VictorZykov/molecubes/README.md

Welcome to the recovered Molecubes software repository!  <br/>This repository was previously hosted on SourceForge.  <br/>Please refer to the molecubes.org wiki for the full project description.
