VictorZykov/molecubes/software/CubeInterface/CubeInterface/README.txt

== Executable ==
   NxTutorial104.exe

== Libraries ==
(PhysX Libraries)
   NxCharacter.dll
   NxCooking.dll
   NxOgre.dll

(OGRE Libraries)
   OgreMain.dll
   OIS.dll
   Plugin_ParticleFX.dll
   RenderSystem_Direct3D9.dll
   RenderSystem_GL.dll

== Configuration Files ==
   config.yaml				(configuration for graphics rendering; edit in Notepad)

== Resources (images, meshes, etc.) ==
   Media\
	- resources.cfg

	- boot.zip			(contains basic media files)
	- tutorialmedia.zip		(contains media files required by tutorials)

	- MSCube19.mesh			(display mesh for bottom half-cube)
	- MSCube20.mesh			(display mesh for upper half-cube)
	- Pyramid13.mesh		(collision mesh for bottom half-cube)
	- Pyramid14.mesh		(collision mesh for upper half-cube)
	- 01 - Default.material		(material information for cubes, e.g. color)
	
	- nxbgui.material		(material information for GUI)

	- bguires.zip			(contains media files for Beta GUI)
	- bgui.exit.active.png		(image for GUI)
	- bgui.exit.png			(image for GUI)
	- debug.active.png		(image for GUI)
	- debug.png			(image for GUI)
	- debugon.active.png		(image for GUI)
	- debugon.png			(image for GUI)
	- pause.active.png		(image for GUI)
	- pause.png			(image for GUI)
	- play.active.png		(image for GUI)
	- play.png			(image for GUI)
