VictorZykov/molecubes/specs/hardware_protocol_definition.xls

Sheet: Revision History
Molecubes Half-Duplex RS232 Bus Command and Protocol Definition Document
Date | Revision | Description | Engineer
2007-09-11 | 1 | Initial revision | Phelps Williams
2007-09-25 | 2 | Coverted to xlsx format, formatting changes | Phelps Williams
2007-10-12 | 3 | Finished populating initial command listing, details of queued commands has also been worked through. Reverted back to xls format. | Phelps Williams
2007-10-15 | 4 | Revisions to instruction listing after certain commands were identified as lacking suffcient feedback. | Phelps Williams
2008-01-11 | 5 | Command 0x08 "set output pins" altered to provide explicit control over data direction. Command 0x03 "set address" marked as only usable over internal bus. Command 0x14 "ADC readout" added. | Victor Zykov
2008-03-17 | 6 | Segregared commands into Master and Slave types with the goal of only having one Master per cube with a priori known functionality (determined with its class). New classes introduced, such as triplet and duet controller AVRs and gripper | Victor Zykov
2008-03-28 | 7 | Device Classes broken out to separate sheet, battery master slave specified. | Phelps Williams

Sheet: Packet Specification
Packet Specification
HEADER | CLASS | ID | LENGTH | INSTRUCTION | PARAM1 | .... | PARAMn | CHECKSUM
Name | Range | Description
HEADER | 0xFF | This is a single byte which identifies an incoming packet
CLASS | 0x00-0xFF | This is a single byte identifying the class of the target device. (See Device Classes sheet)
ID | 0x00-0xFD | Unique class address. There are 254 available Ids for each individual class.
 |  | Class Broadcast Address: 0xFE
LENGTH | 0x00-0xFF | Parameter byte count. Maximum parameter count is 256 parameters per packet. It is important to note that the overall packet is as follows:
 |  | Overall Packet Length = 6 + Length
 |  | The overall packet length takes the header, class, id, length, instruction, and checksum into account.
INSTRUCTION | 0x00-0xFF | Instruction to perform
PARAMETER0...n | 0x00-0xFF | Parameters specific to each instruction
CHECKSUM | 0x00-0xFF | A simple 8bit checksum value. Calculated as follows:
 |  | Checksum = ^(ID + LENGTH + INSTRUCTION + PARAM1 + ... PARAMn)
 |  | Checksum value is 8bits in length and should rollover upon reaching its maxima.
NOTES
To avoid timing errors during packet transmission, the packet source has its interrupts turned off for the period of transmission.

Sheet: Device Classes
Molecubes Device Classes
Class | Master | Description
0xFF | N/A | AX-12 Servomotor class
0xFE | N/A | broadcasting class - for initial module identification and address assignment
0xFD | N/A | ARMClass - for future extensions
0xFC | Yes | Controller AVR shell - with both side panel (triplet)
0xFB | No | Controller AVR shell - with only one left side panel (duet)
0xFA | Yes | Actuator South Class - connected to the motor and Hall sensor
0xF9 | No | Actuator North Class - connected to the motor and main potentiometer
0xF8 | Yes | Gripper class
0xF7 | Yes | Battery Triplet Class (Master, South)
0xF6 | No | Battery Duet Class (Slave, North)
Note: Master Classes can be commanded over the external bus. Non-Master (slave) classes can only be commanded the internal bus.

Sheet: Molecube Instruction Listing
Molecube Module Instruction Listing‡ |  |  |  |  |  |  |  |  | COMMAND RECEPIENTS:
 |  |  |  |  |  |  |  |  | MASTERS (external bus)
Name | Instruction | Parameter Definition |  |  |  |  |  | Notes | SLAVES (internal bus)
Get Firmware Version | 0x02 | Instruction Parameters: | 0 | Bytes | Response Parameters: | 2 | Bytes |  | SOUTH HALVES (ext. bus)
 |  | None |  |  | Firmware Version | 16 | bits
Set Address | 0x03 | Instruction Parameters: | 1 | Bytes | Response Parameters: | 1 | Bytes | master uses this command to propagate
 | p[0] | Address | 8 | bits | Address | 8 | bits | address to slave half via internal bus
 |  |  |  |  |  |  |  | Used only over internal bus
Set Address with | 0x04 | Instruction Parameters: | 1 | Bytes | Response Parameters: | 1 | Bytes | Broadcast command, device which orientation pin high sets provided address and responds indicating address successfully set.
Orientation Pin† | p[0] | Address | 8 | bits | Address (as part of rx process) | 8 | bits
 |  |  |  |  | Error codes
 |  |  |  |  | No parameters - no errors
 |  |  |  |  | p[0] = 1 - Slave comm timeout
 |  |  |  |  | p[0] = 2 - Slave comm error
Get Raw Angle | 0x06 | Instruction Parameters: | 0 | Bytes | Response Parameters: | 4.875 | Bytes
 |  | None |  |  | filler | 6
 |  |  |  |  | Main Pot Reading | 10 | bits
 |  |  |  |  | filler | 6
 |  |  |  |  | Motor Position | 10 | bits
 |  |  |  |  | filler | 7 | bit
 |  |  |  |  | Hall Sensor | 1 | bit
Get Measured Angle | 0x07 | Instruction Parameters: | 0 | Bytes | Response Parameters: | 2 | Bytes | Returns measured angle derived from information also accessible in Get Raw Angle command.
 |  | None |  |  | Calculated angle in .1 degs | 12 | bits
 |  |  |  |  | filler | 4
Set Orientation Pins | 0x08 | Instruction Parameters: | 1 | Bytes | Response Parameters: | 0 | Bytes | CARE SHOULD BE TAKEN TO AVOID
 | p[0] | Board ID - bits 4..7 | 4 | bits | Error codes |  |  | OUTPUT-TO-OUTPUT SHORTS
 |  | Pin ID - bits 2 and 3 | 2 | bits | No parameters - no errors |  |  | ALL PINS ARE INPUTS
 |  | filler bit 1 | 1 | bits | p[0] = 1 - Pin is an output already |  |  | unless set to Output = High
 |  | Desired state bit 0 | 1 | bits | p[0] = 2 - High input level detected |  |  | Sets both data direction and value (for
 |  |  |  | bits | p[0] = 3 - Requested board abscent |  |  | outputs) of individual orientation pins
 |  |  |  |  | p[0] = 4 - Slave commication timeout |  |  | Checks input first to avoid short circuit
 |  |  |  |  | p[0] = 5 - Slave commication error
 | p[0] | Slave Side ID - bits 4..5 | 2 | bits | Error codes
 |  | Pin ID - bits 2 and 3 | 2 | bits | No parameters - no errors
 |  | filler bit 1 | 1 | bits | p[0] = 1 - Pin is an output already
 |  | Desired state bit 0 | 1 | bits | p[0] = 2 - High input level detected
 |  |  |  |  | p[0] = 3 - Requested board not installed
 |  |  |  |  | p[0] = 4 - Wrong side requested
Get Orientation Pins | 0x09 | Instruction Parameters: | 0 | Bytes | Response Parameters: | 4 | Bytes
 | None |  |  |  | p[0] = M3..0, R3..0 (master) | 8 | bits | Sets all orientation I/O s to inputs and
 |  |  |  |  | p[1] = L3..0(m), M3..0 (slave) | 8 | bits | reads their states, then reports them
 |  |  |  |  | p[2] = R3..0, L3..0 (slave) | 8 | bits | in 2 parameter bytes of response
 |  |  |  |  | p[3] = 1 - Slave comm timeout | 8 | bits
` |  |  |  |  | p[3] = 2 - Slave comm error
 | None |  |  |  | p[0] = 4 bit filler, M3..0 (slave) | 8
 |  |  |  |  | p[1] = R3..0, L3..0 (slave) | 8
Get Motor Status | 0x0B | Instruction Parameters: | 0 | Bytes | Response Parameters: | 10 | Bytes
 |  | None |  |  | Goal Position | 16 | bits
 |  |  |  |  | Present Position | 16 | bits
 |  |  |  |  | Present Speed | 16 | bits
 |  |  |  |  | Present Load | 16 | bits
 |  |  |  |  | Present Voltage | 8 | bits
 |  |  |  |  | Present Temperature | 8 | bits
Get Motor Register | 0x0C | Instruction Parameters: | 2 | Bytes | Response Parameters: | * | Bytes
 |  | Starting Address | 8 | bits | Parameter 1 | 8 | bits
 |  | Number of registers to read | 8 | bits | Parameter 2 | 8 | bits
 |  |  |  |  | Parameter n | 8 | bits
Set Motor Register | 0x0D | Instruction Parameters: | * | Bytes | Response Parameters: | 0 | Bytes
 |  | Starting Address | 8 | bits | None
 |  | Parameter 1 | 8 | bits
 |  | Parameter 2 | 8 | bits
 |  | Parameter n | 8 | bits
Servo Angle Tracking | 0x0E | Instruction Parameters: | 1 | Bytes | Response Parameters: | 0 | Bytes | This command turns on and off the
 |  | filler | 7 | bits |  |  |  | servo angle tracking loop
 |  | Tracking Status (ON / OFF) | 1 | bits
Preload Motor Profile | 0x0F | Instruction Parameters: | * | Bytes | Response Parameters: | 0 | Bytes | This allows for command preloading on the servo. Specifically utilizing the REG_WRITE (4-3-1) functionality. An ACTION (4-3-2) command is additionally preloaded and executed when a heartbeat of corresponding timestamp is received.
 |  | Timestamp(msec) | 32 | bits | None
 |  | Starting Address | 8 | bits
 |  | Parameter 1 | 8 | bits
 |  | Parameter 2 | 8 | bits
 |  | Parameter n | 8 | bits
Preload Command | 0x10 | Instruction Parameters: | * | Bytes | Response Parameters: | 0 | Bytes | This is for preloading a command outside of the motor, such as a command listed here. Valid commands cannot have response parameters. An example usage of this command is Set LEDs.
 |  | Timestamp(msec) | 32 | bits
 |  | Instruction | 8 | bits | None
 |  | Parameter 1 | 8 | bits
 |  | Parameter 2 | 8 | bits
 |  | Parameter n | 8 | bits
Heartbeat † | 0x11 | Instruction Parameters: | 4 | Bytes | Response Parameters: | 0 | Bytes | Any preloaded command with matching timestamp is executed simultaneously.
 |  | Timestamp | 32 | bits | None
Set LEDs | 0x12 | Instruction Parameters: | 4 | Bytes | Response Parameters: | 0 | Bytes
 |  | Filler (must be 0) | 5 | bits | Error codes
 | p[0] | BoardID (0 - 5) | 3 | bits | No parameters - no errors
 | p[1] | Red | 8 | bits | p[0] = 1 - Right slave board not installed
 | p[2] | Green | 8 | bits | p[0] = 2 - Left slave board not installed
 | p[3] | Blue | 8 | bits | p[0] = 3 - Slave commication timeout
 |  |  |  |  | p[0] = 4 - Slave commication error
 | p[0] | Side (M = 00, R = 01, L = 10) | 2 | bits | No parameters - no errors
 | p[1] | Red | 8 | bits | p[0] = 1 - Right slave board not installed
 | p[2] | Green | 8 | bits | p[0] = 2 - Left slave board not installed
 | p[3] | Blue | 8 | bits
Get ADC Readout | 0x14 | Instruction Parameters: | 0 | Bytes | Response Parameters: | 2 | Bytes | Command designed for use in actuator
 |  | None |  | p[0] | ADCdata & 0x00ff (LSB) | 10 | bits | angle calculation for transmission over
 |  |  |  | p[1] | (ADCdata & 0xff00)>>8 (MSB) | 6 |  | internal bus, however will also respond
 |  |  |  |  |  |  |  | If received on external bus. North half
 |  |  |  |  |  |  |  | returns Hall effect sensor readout,
 |  |  |  |  |  |  |  | South half returns potentiometer readout,
 |  |  |  |  |  |  |  | Data has no meaning for other classes
Set goal speed and angle | 0x15 | Instruction Parameters: | 4 | Bytes | Response Parameters: | 0 | Bytes
 | p[0] | GoalAngle & 0x00ff (LSB) | 8 |  | confirms execution
 | p[1] | (GlAngl & 0xff00)>>8 (MSB) | 8 |  | by returning own class,
 | p[2] | GoalSpeed & 0x00ff (LSB) | 8 |  | address and command ID
 | p[3] | (GSpeed & 0xff00)>>8 (MSB) | 8
 |  | Goal Angle (0..3600)
 |  | Goal Speed (0..3600)
Request inputs state | 0x16 | Instruction Parameters: | 0 | Bytes | Response Parameters: | 0 | Bytes
Gripper actuation | 0x17 | Instruction Parameters: | 6 | Bytes | Response Parameters: | 0 | Bytes
 | p[0] | Position & 0x00ff (LSB) | 8 |  | confirms execution
 | p[1] | (Pos & 0xff00)>>8 (MSB) | 8 |  | by returning own class,
 | p[2] | Speed & 0x00ff (LSB) | 8 |  | address and command ID
 | p[3] | (Speed & 0xff00)>>8 (MSB) | 8
 | p[4] | Force & 0x00ff (LSB) | 8
 | p[5] | (Force & 0xff00)>>8 (MSB) | 8
 |  | Pos 0..1023
 |  | Speed 0..1023
 |  | Force 200..(400)..500
Get Status | 0xFE | Instruction Parameters: | 0 | Bytes | Response Parameters: | 1 | Bytes | Error codes have not been defined, only occurs in response packet, this instruction will replace the intended response instruction.
 |  | None |  |  | Error Code | 8 | bits
Notes:
† Valid for broadcast
‡ Assumes default address upon startup of molecube module
