VictorZykov/molecubes/specs/molecubes_morphology_file_spec.xls

Sheet: Revision History
Molecube Morphology File (*.mmf) Specification
Date | Revision | Description | Engineer
2008-03-28 | 1 | Initial official revision, file structure implemented and functioning to this spec. | Phelps Williams

Sheet: MorphologyConvention
Overall Molecube Morphology File Structure
Item | Range | Contents
cubecount | 0 - 255 | Number of cubes in the morphology, this corresponds ot the number of module descriptors
cubes[] |  | Array of module descriptors
morphology checksum | 0 - 255
statecount | 0 - 2^32 | Number of state descriptors in the state array
state[] |  | Array of state descriptors
state checksum | 0 - 255
List of Modules is an array listing all Module Descriptors - by the number of Molecube modules comprising the assembly
Module Descriptor is a simple feature list that includes the following items
Item | Range | Contents
ID | 0 - 253 | individual Molecube module identifier, address 0xFE is reserved for broadcasting
Class | 0 - 255 | Molecube class identifier, such as AX-12 servo, South actuator half, North actuator half, etc.
NumLinks | 0 - 255 | Number of physical connections this module has in Molecube assembly
Links[ ] |  | Array of Link Descriptors - structures with physical connection specifications - size of array specified by NumLinks
List Array stores all physical connections existing between modules in the Molecube assembly
Link Descriptor is a simple feature list including two sets of items, describing both joint Molecube connectors and their relative orientation
Item | Range | Contents
selfID | 0 - 253 | individual Molecube module identifier of the first joint module
selfClass | 0 - 255 | Molecube class identifier of the first joint module
selfSide | 0 - n | The joint interface identifier for the first joint module (see Module Connector Identification Conventions below)
selfOrient | 0 - 3 | Orientation of the first module relative to the second (see Orientation Convention below)
neighborID | 0 - 253 | individual Molecube module identifier of the second joint module
neighborClass | 0 - 255 | Molecube class identifier of the second joint module
neighborSide | 0 - n | The joint side identifier for the second joint module
 | Orientation Convention
 | There are four possible relative orientations of the Molecube interfaces relative to each other when joint together
 | Each of these four orientations can be characterized by one of four pin interconnection variants below
 | Orientation 0 |  | Orientation 1 |  |  | Orientation 2 |  | Orientation 3
 | Face A | Face B | Face A | Face B |  | Face A | Face B | Face A | Face B
 | Pin 0 <-> | Pin 3 | Pin 0 <-> | Pin 2 |  | Pin 0 <-> | Pin 1 | Pin 0 <-> | Pin 0
 | Pin 1 <-> | Pin 2 | Pin 1 <-> | Pin 1 |  | Pin 1 <-> | Pin 0 | Pin 1 <-> | Pin 3
 | Pin 2 <-> | Pin 1 | Pin 2 <-> | Pin 0 |  | Pin 2 <-> | Pin 3 | Pin 2 <-> | Pin 2
 | Pin 3 <-> | Pin 0 | Pin 3 <-> | Pin 3 |  | Pin 3 <-> | Pin 2 | Pin 3 <-> | Pin 1
 | Module Connector Identification Conventions
 | Face ID | Actuator | Gripper |  | Controller |  | Battery
 | 0 | South Main | Main |  | Triplet Main |  | Triplet Main | Masters
 | 1 | South Right | Right |  | Triplet Right |  | Triplet Right
 | 2 | South Left | Left |  | Triplet Left |  | Triplet Left
 | 3 | North Main |  |  | Duet Main |  | Duet Main | Slaves
 | 4 | North Right |  |  |  |  | Duet Right
 | 5 | North Left |  |  | Duet Left
State Descriptor - a state descriptor maintains some representation of physical or logical state at a point in time
Item | Range | Contents
id | 0 - 255 | Molecube address
class | 0 - 255 | Molecube class
timestamp | 0 - 2^32 | Time of state validity
channel | 0 - 255 | Telemetry Channel represented
value | 0 - 2^32 | Telemetry Channel value
Telemetry Channel Definitions - reference to cube specific channels of telemetry
Class | Channel | Description
0xFA |  | South Actuator Half
 | 0x00 | Actuator position in 10ths of degrees
0xF8 |  | Gripper
 | 0x00 | Gripper position
