VictorZykov/molecubes/software/CubeInterface/hardware_protocol_definition.xls

Sheet: Revision History
Molecubes Half-Duplex RS232 Bus Command and Protocol Definition Document
Date | Revision | Description | Engineer
2007-09-11 | 1 | Initial revision | Phelps Williams
2007-09-25 | 2 | Coverted to xlsx format, formatting changes | Phelps Williams
2007-10-12 | 3 | Finished populating initial command listing, details of queued commands has also been worked through. Reverted back to xls format. | Phelps Williams
2007-10-15 | 4 | Revisions to instruction listing after certain commands were identified as lacking suffcient feedback. | Phelps Williams

Sheet: Packet Specification
Packet Specification
HEADER | CLASS | ID | LENGTH | INSTRUCTION | PARAM1 | .... | PARAMn | CHECKSUM
Name | Range | Description
HEADER | 0xFF | This is a single byte which identifies an incoming packet
CLASS | 0x00-0xFF | This is a single byte identifying the class of the target device.
 |  | Device Classes:
 |  | 0xFF | AX-12 Servomotor
 |  | 0xFE | Molecube North Controller
 |  | 0xFD | Molecube South Controller
ID | 0x00-0xFD | Unique class address. There are 254 available Ids for each individual class.
 |  | Class Broadcast Address: 0xFE
LENGTH | 0x00-0xFF | Parameter byte count. Maximum parameter count is 256 parameters per packet. It is important to note that the overall packet is as follows:
 |  | Overall Packet Length = 6 + Length
 |  | The overall packet length takes the header, class, id, length, instruction, and checksum into account.
INSTRUCTION | 0x00-0xFF | Instruction to perform
PARAMETER0...n | 0x00-0xFF | Parameters specific to each instruction
CHECKSUM | 0x00-0xFF | A simple 8bit checksum value. Calculated as follows:
 |  | Checksum = ^(ID + LENGTH + INSTRUCTION + PARAM1 + ... PARAMn)
 |  | Checksum value is 8bits in length and should rollover upon reaching its maxima.

Sheet: Molecube Instruction Listing
Molecube Module Instruction Listing‡
Name | Instruction | Parameter Definition |  |  |  |  |  | Notes
Get Firmware Version | 0x02 | Instruction Parameters: | 0 | Bytes | Response Parameters: | 2 | Bytes
 |  | None |  |  | Firmware Version | 16 | bits
Set Address | 0x03 | Instruction Parameters: | 1 | Bytes | Response Parameters: | 1 | Bytes
 |  | Address | 8 | bits | Address | 8 | bits
Set Address with Orientation Pin† | 0x04 | Instruction Parameters: | 1 | Bytes | Response Parameters: | 1 | Bytes | Broadcast command, device which orientation pin high sets provided address and responds indicating address successfully set.
 |  | Address | 8 | bits | Address | 8 | bits
Set Address with Orientation Pin and Set Motor Master† | 0x05 | Instruction Parameters: | 1 | Bytes | Response Parameters: | 1 | Bytes
 |  | Address | 8 | bits | Address | 8 | bits
Get Raw Angle | 0x06 | Instruction Parameters: | 0 | Bytes | Response Parameters: | 3 | Bytes
 |  | None |  |  | Global Position | 10 | bits
 |  |  |  |  | Motor Position | 10 | bits
 |  |  |  |  | Insensitivity Region | 1 | bit
 |  |  |  |  | Filler | 3 | bits
Get Measured Angle | 0x07 | Instruction Parameters: | 0 | Bytes | Response Parameters: | 2 | Bytes | Returns measured angle derived from information also accessible in Get Raw Angle command.
 |  | None |  |  | Joint Angle | 16 | bits
Set Orientation Pin | 0x08 | Instruction Parameters: | 1 | Bytes | Response Parameters: | 0 | Bytes
 |  | Side (M = 00, R = 01, L = 10) | 2 | bits | None
 |  | Pin (0-3) | 2 | bits
 |  | State | 1 | bit
 |  | Filler (don't care) | 3 | bits
Get Orientation Pins | 0x09 | Instruction Parameters: | 0 | Bytes | Response Parameters: | 3 | Bytes | Provides complete representation of current orientation pin state along with Data Direction indication (DDR) which indicates whether pin is an input or an output.
 |  | None |  |  | Main (M0, M1, M2, M3) | 4 | bits
 |  |  |  |  | Right (R0, R1, R2, R3) | 4 | bits
 |  |  |  |  | Left (L0, L1, L2, L3) | 4 | bits
 |  |  |  |  | Main DDR (M0, M1, M2, M3) | 4 | bits
 |  |  |  |  | Right DDR (R0, R1, R2, R3) | 4 | bits
 |  |  |  |  | Left DDR (L0, L1, L2, L3) | 4 | bits
`
Is Orientation Pin Observed† | 0x0A | Instruction Parameters: | 0 | Bytes | Response Parameters: | 1 | Bytes | If observed is false (0) remaining bits in parameter byte are don’t care
 |  | None |  |  | Observed (boolean) | 1 | bit
 |  |  |  |  | Side (M = 00, R = 01, L = 10) | 2 | bits
 |  |  |  |  | Pin (0-3) | 2 | bits
 |  |  |  |  | State | 1 | bit
 |  |  |  |  | Filler (don't care) | 2 | bits
Get Motor Status | 0x0B | Instruction Parameters: | 0 | Bytes | Response Parameters: | 10 | Bytes
 |  | None |  |  | Goal Position | 16 | bits
 |  |  |  |  | Present Position | 16 | bits
 |  |  |  |  | Present Speed | 16 | bits
 |  |  |  |  | Present Load | 16 | bits
 |  |  |  |  | Present Voltage | 8 | bits
 |  |  |  |  | Present Temperature | 8 | bits
Get Motor Register | 0x0C | Instruction Parameters: | 2 | Bytes | Response Parameters: | * | Bytes
 |  | Starting Address | 8 | bits | Parameter 1 | 8 | bits
 |  | Number of registers to read | 8 | bits | Parameter 2 | 8 | bits
 |  |  |  |  | Parameter n | 8 | bits
Set Motor Register | 0x0D | Instruction Parameters: | * | Bytes | Response Parameters: | 0 | Bytes
 |  | Starting Address | 8 | bits | None
 |  | Parameter 1 | 8 | bits
 |  | Parameter 2 | 8 | bits
 |  | Parameter n | 8 | bits
Set Motor Master | 0x0E | Instruction Parameters: | 0 | Bytes | Response Parameters: | 0 | Bytes | The receipient of this command is expected to internally inform the other half of the molecube.
 |  | None |  |  | None
Preload Motor Profile | 0x0F | Instruction Parameters: | * | Bytes | Response Parameters: | 0 | Bytes | This allows for command preloading on the servo. Specifically utilizing the REG_WRITE (4-3-1) functionality. An ACTION (4-3-2) command is additionally preloaded and executed when a heartbeat of corresponding timestamp is received.
 |  | Timestamp(msec) | 32 | bits | None
 |  | Starting Address | 8 | bits
 |  | Parameter 1 | 8 | bits
 |  | Parameter 2 | 8 | bits
 |  | Parameter n | 8 | bits
Preload Command | 0x10 | Instruction Parameters: | * | Bytes | Response Parameters: | 0 | Bytes | This is for preloading a command outside of the motor, such as a command listed here. Valid commands cannot have response parameters. An example usage of this command is Set LEDs.
 |  | Timestamp(msec) | 32 | bits
 |  | Instruction | 8 | bits | None
 |  | Parameter 1 | 8 | bits
 |  | Parameter 2 | 8 | bits
 |  | Parameter n | 8 | bits
Heartbeat † | 0x11 | Instruction Parameters: | 4 | Bytes | Response Parameters: | 0 | Bytes | Any preloaded command with matching timestamp is executed simultaneously.
 |  | Timestamp | 32 | bits | None
Set LEDs | 0x12 | Instruction Parameters: | 4 | Bytes | Response Parameters: | 0 | Bytes
 |  | Filler (must be 0) | 6 | bits | None
 |  | Side (M = 00, R = 01, L = 10) | 2 | bits
 |  | Red | 8 | bits
 |  | Green | 8 | bits
 |  | Blue | 8 | bits
Get Status | 0xFE | Instruction Parameters: | 0 | Bytes | Response Parameters: | 1 | Bytes | Error codes have not been defined, only occurs in response packet, this instruction will replace the intended response instruction.
 |  | None |  |  | Error Code | 8 | bits
Notes:
† Valid for broadcast
‡ Assumes default address upon startup of molecube module
