VictorZykov/molecubes/hardware/actuator/pcb/docs/ATmega16PinsFuncs.xls

Chip ID | U1
Type | ATmega644P
Pin No. | Pin ID | Function | Connects to
1 | PB5 | ISP: MOSI | X1.1 (MO)
2 | PB6 | ISP: MISO | X1.2 (MI)
3 | PB7 | ISP: SCK | X1.6 (SC)
4 | /RESET | /RESET | X1.5 (/RS)
5 | VCC | VCC | X1.4 (VC)
6 | GND | GND | X1.3 (GD)
7 | XTAL2 | XTAL2 | Q1.1
8 | XTAL1 | XTAL1 | Q1.3
9 | PD0 | RXD0 Internal RS232 | IC1.6 (1Y)
10 | PD1 | TXD0 Internal RS232 | IC1.5 (2A)
11 | PD2 | RXD1 External RS232 | IC4.6 (1Y)
12 | PD3 | TXD1 External RS232 | IC4.5 (2A)
13 | PD4 | Control TXD1 (External RS-232) | IC4.7 (2OE)
14 | PD5 | Control RXD1 (External RS-232) | IC4.1 (1OE)
15 | PD6 | I/O Left_3 | P10.3, J10.1
16 | PD7 | I/O Left_0 | P9.3, J9.1
17 | VCC | VCC
18 | GND | GND
19 | PC0 | TWI: SCL | IC7.8, IC8.8, IC9.8
20 | PC1 | TWI: SDA | IC7.9, IC8.9, IC9.9
21 | PC2 | I/O Left_2 | P11.3, J11.1
22 | PC3 | I/O Left_1 | P12.3, J12.1
23 | PC4 | Not connected
24 | PC5 | Not connected
25 | PC6 | I/O Right_2 | P5.3, J5.1
26 | PC7 | I/O Right_1 | P6.3, J6.1
27 | AVCC | Conditioned ADC power supply | C5, L1
28 | GND | GND
29 | AREF | Not connected
30 | PA7 | I/O Right_3 | P8.3, J8.1
31 | PA6 | I/O Right_0 | P7.3, J7.1
32 | PA5 | ADC pin | JP3.AD, JP4.AD
33 | PA4 | Not connected
34 | PA3 | Not connected
35 | PA2 | I/O M0 | P2.3, J2.1
36 | PA1 | I/O M3 | P3.3, J3.1
37 | PA0 | I/O M2 | P4.3, J4.1
38 | VCC | VCC
39 | GND | GND
40 | PB0 | I/O M1 | P1.3, J1.1
41 | PB1 | Control RXD0 (Internal RS-232) | IC1.1 (1OE)
42 | PB2 | Control TXD0 (Internal RS-232) | IC1.7 (2OE)
43 | PB3 | Not connected
44 | PB4 | Not connected
