VictorZykov/molecubes/doc/LPC-P2148.pdf

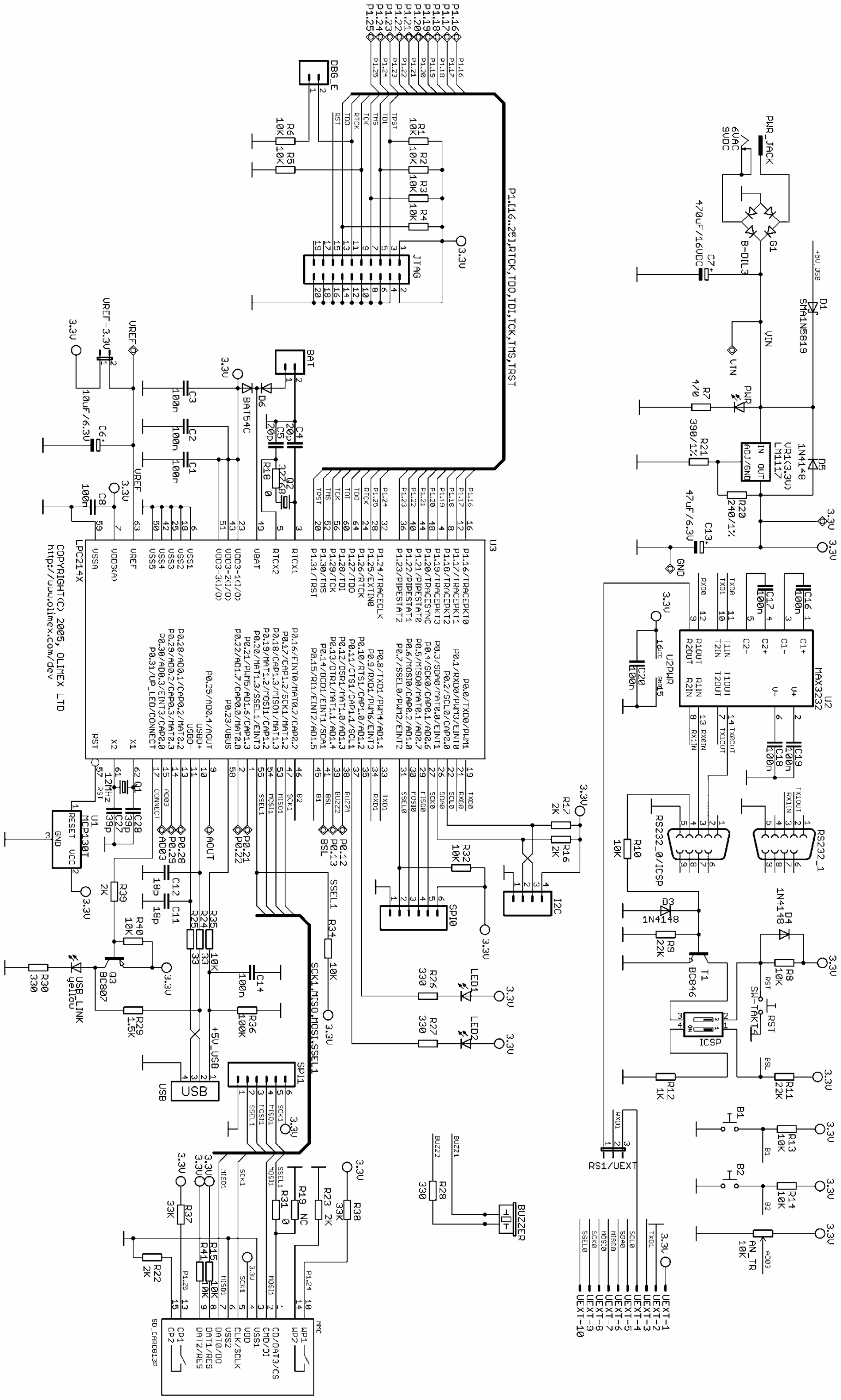
[picture p10: figure]
