VictorZykov/molecubes/specs/molecubes_sequence_file_spec.xls

Sheet: Revision History
Molecube Sequence File (*.msf) Specification
Date | Revision | Description | Engineer
2008-03-28 | 1 | Initial official revision, file structure implemented and functioning to this spec. | Phelps Williams

Sheet: FileStructure
Molecube Sequence File (*.msf) Specification
Description: This is a binary file of currently arbitrary size specified by the structure in this document. For Commands, see hardware_protocol_definition document.
Name | Variable Type | Description | Example (base16) | Example Decoded
Sequence Name | char array size 25 | Human Readable identifier of the command sequence | 54 65 73 74 20 53 65 71 75 65 6e 63 65 00 | Test Sequence
Topology Hash | unsigned int (32bit) | Links sequence to hardware configuration. LSB must equal number of cubes, format of 3MSB has yet to be specified and isn't used in runtime yet | 02 00 00 00 | 2
Command Count | unsigned int (32bit) | Total Number of commands in this particular sequence | 04 00 00 00 | 4
Size | unsigned int (32bit) | Size of all Commands in the sequence, not including this header | 34 00 00 00 | 52
Header Checksum | unsigned char (8bit) | Equals Name, Topology Hash, Command Count and size, summed and inverted(~) | fd
Cmd0 Timestamp | unsigned int (32bit) | Time in milliseconds of execution | 0a 00 00 00 | 10
Cmd0 Bus | unsigned char (8bit) | 0 (Internal Bus), 1 (External Bus) | 00 | 0 (Internal Bus)
Cmd0 Header | unsigned char (8bit) | Always 255 | ff
Cmd0 Class | unsigned char (8bit) |  | ff | 255 is AX12 Motor
Cmd0 ID | unsigned char (8bit) | Device Address | 01
Cmd0 Length | unsigned char (8bit) |  | 02
Cmd0 Instruction | unsigned char (8bit) |  | 03
Cmd0 Param 0 | unsigned char (8bit) |  | 19
… | …
Cmd0 Param n | unsigned char (8bit) |  | 00
… | …
Cmd N Timestamp | unsigned int (32bit)
Cmd N Bus | unsigned char (8bit)
Cmd N Header | unsigned char (8bit)
Cmd N Class | unsigned char (8bit)
Cmd N ID | unsigned char (8bit)
Cmd N Length | unsigned char (8bit)
Cmd N Instruction | unsigned char (8bit)
Cmd N Param 0 | unsigned char (8bit)
… | …
Cmd N Param n | unsigned char (8bit)
