VictorZykov/molecubes/doc/datasheets/rn41/RN41-pads.jpg

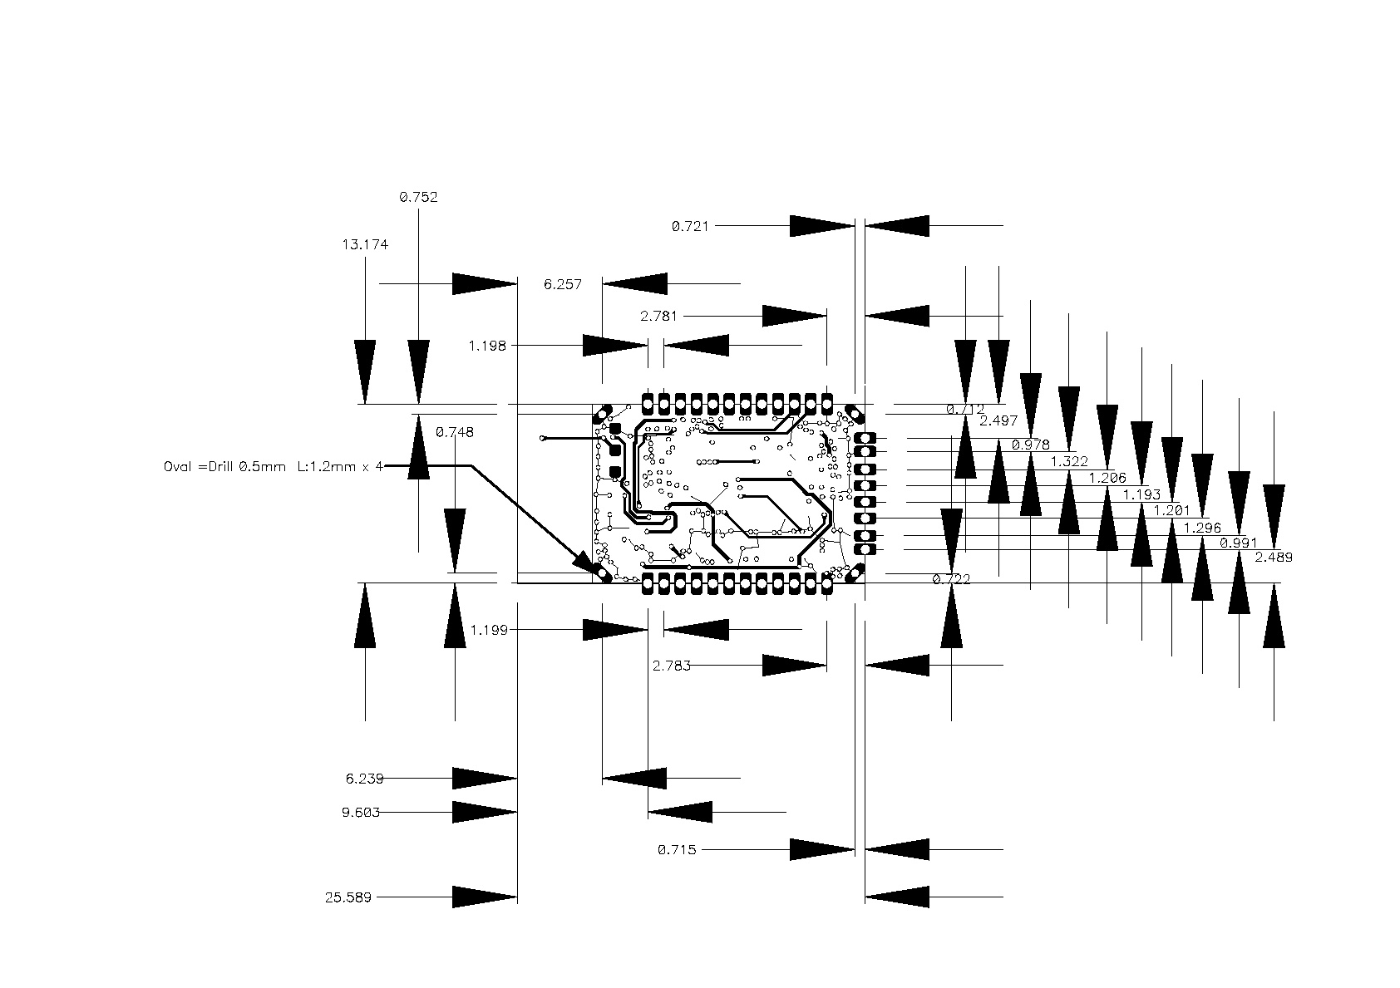
doc/datasheets/rn41/RN41-pads.jpg
