VictorZykov/molecubes/doc/LPC-H2148-dimensions.gif

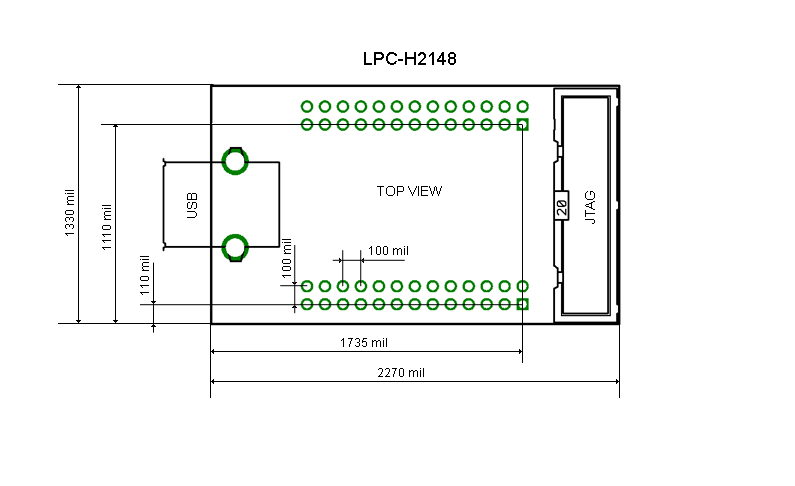
doc/LPC-H2148-dimensions.gif
