VictorZykov/molecubes/hardware/stand/BOM_stand.xls

LCD Voltmeter | QM100V-40 | http://www.martelmeters.com/pdf/QM_100V-40.pdf
Power Switch | CRE22F4FBBNE | http://www.cherrycorp.com/english/rockers/pdf/CR_Series.pdf
Battery Holder | BH24D | http://www.batteryholders.com/BH24DL.pdf
AC-DC converter | PW132 | http://www.slpower.com/Upload/Technical/200703140337144861498590_PW132.pdf
Jack for power supply | SC1050-ND | http://www.switchcraft.com/products/pdf_files/jack-120_schematic.pdf
