VictorZykov/molecubes/hardware/battery/regulator_2A_14V/bom.xls

Molecubes Battery 14V 2A BOM
Part | Description | Manufacturer P/N | Digikey P/N | Notes
C1 | CAP .10UF 25V CERAMIC X7R 0805 | C0805C104K3RACTU | 399-1168-1-ND | Cbyp | y
C2 | CAP .15UF 16V CERAMIC X7R 0805 | ECJ-2VB1C154K | PCC1814CT-ND | Ccomp | y
C3 | CAP 100UF 16V ELECT FK SMD | EEV-FK1C101P | PCE3399CT-ND | Cin | y
C4 | CAP 330UF 35V ELECT FK SMD | EEV-FK1V331P | PCE3420CT-ND | Cout | y
C5 | CAP 330UF 35V ELECT FK SMD | EEV-FK1V331P | PCE3420CT-ND | Cout | y
C6 | CAP 330UF 35V ELECT FK SMD | EEV-FK1V331P | PCE3420CT-ND | Cout | y
C7 | CAP 10000PF 50V CERAMIC X7R 0805 | C0805C103K5RACTU | 399-1158-1-ND | Csense | y
D1 | DIODE SCHOTTKY 30V 12A D-PAK | 12CWQ03FN | 12CWQ03FN-ND |  | y
IC1 | LM3478MM | LM3478MM | LM3478MMCT-ND |  | y
L1 | INDUCTOR POWER 22UH 4.1A SMD | 744770122 | 732-1227-1-ND |  | y
M1 | MOSFET N-CH 30V 13.6A 8-SOIC | IRF7821TRPBF | IRF7821PBFCT-ND |  | y
R1 | RES 1.0K OHM 1/8W 5% 0805 SMD | ERJ-6GEYJ102V | P1.0KACT-ND | Rcomp | y
R2 | RES 0.0 OHM 1/8W 5% 0805 SMD | ERJ-6GEY0R00V | P0.0ACT-ND | Rdr | y
R3 | RES 95.3K OHM 1/8W 1% 0805 SMD | ERJ-6ENF9532V | P95.3KCCT-ND | Rfadj | y
R4 | RES 976 OHM 1/16W 1% 0402 SMD | CRCW0402976RFKED | 541-976LCT-ND | Rfb1 | y
R5 | RES 10K OHM 1/8W 5% 0805 SMD | ERJ-6GEYJ103V | P10KACT-ND | Rfb2 | y
R6 | RES 604 OHM 1/16W 1% 0402 SMD | CRCW0402604RFKED | 541-604LCT-ND | Rs1 | y
R7 | RESISTOR .022 OHM 1/4W 1% 1210 | ERJ-L14KF22MU | P22NACT-ND | Rsense | y
J1 | CONN BATTERY 2 POS MINI | 009155002201006 | 478-4682-1-ND |  | y
J2 | CONN BATTERY 2 POS MINI | 009155002201006 | 478-4682-1-ND |  | y
Fuse Options
 | FUSE 5A 32V FAST 1206 | 0466005.NR | F1460CT-ND | Fast 5A
 | FUSE 5A 63V 1206 SLOW C1S | C1S 5 | 507-1194-1-ND | Slow 5A
 | FUSE 7A 125V 6125 SLOW SST | SST 7 | 507-1072-1-ND | Slow 7A
 | FUSE BRICK 10A 125V FAST 6125FA | TR2/6125FA10A | 283-2530-1-ND | Fast 10A
 |  |  | Newark P/N
S1 | Miniature Slide Switch 6A | SPC12416 | 53H6675 |  | y
 | External power jack | SC1050-ND |  |  | y
