VictorZykov/molecubes/hardware/controller/pcb/bom.xls

Sheet: BOM
 | Molecubes Controller Daughter Board BOM
 | Part | Description | Manufacturer P/N | Digikey P/N | Notes
* | EXT1 | CONN HEADER 26 POS STRGHT GOLD | N2526-6002RB | MHC26K-ND
* | EXT2 | CONN HEADER 26 POS STRGHT GOLD | N2526-6002RB | MHC26K-ND
* | R1 | RES 10K OHM 1/10W 5% 0603 SMD | ERJ-3GEYJ103V | P10KGCT-ND
* | R2 | RES 10K OHM 1/10W 5% 0603 SMD | ERJ-3GEYJ103V | P10KGCT-ND
* | R3 | RES 1.0K OHM 1/10W 5% 0603 SMD | RC0603JR-071KL | 311-1.0KGRCT-ND
* | R4 | RES 1.0K OHM 1/10W 5% 0603 SMD | RC0603JR-071KL | 311-1.0KGRCT-ND
* | R5 | RES 0.0 OHM 1/10W 5% 0603 SMD | MCR03EZPJ000 | RHM0.0GCT-ND
* | R6 | RES 82 OHM 1/10W 5% 0603 SMD | MCR03EZPJ820 | RHM82GCT-ND
* | R7 | RES 1.0K OHM 1/10W 5% 0603 SMD | RC0603JR-071KL | 311-1.0KGRCT-ND
* | R8 | RES 10K OHM 1/10W 5% 0603 SMD | ERJ-3GEYJ103V | P10KGCT-ND
* | R9 | RES 10K OHM 1/10W 5% 0603 SMD | ERJ-3GEYJ103V | P10KGCT-ND
 | C1 | DELETED
 | C2 | DELETED
 | C3 | DELETED
 | C4 | DELETED
* | C5 | CAP CERM .01UF 10% 50V X7R 0603 | 06035C103KAT2A | 478-1227-1-ND | Cb
* | C6 | CAP CER .68UF 50V 10% X7R 1210 | GRM32NR71H684KA01L | 490-1860-1-ND | Cin
* | C7 | CAP CER .68UF 50V 10% X7R 1210 | GRM32NR71H684KA01L | 490-1860-1-ND | Cin
 | C8 | CAP CER 22UF 16V X5R 20% 1210 | C3225X5R1C226M | 445-1436-1-ND | Cout
 | C9 | CAP CER 22UF 16V X5R 20% 1210 | C3225X5R1C226M | 445-1436-1-ND | Cout
 | C10 | CAP CER 22UF 16V X5R 20% 1210 | C3225X5R1C226M | 445-1436-1-ND | Cout
 | C11 | CAP CERAMIC .56UF 10V X5R 0603 | C0603C564K8PACTU | 399-3115-1-ND
 | C12 | CAP CERAMIC .56UF 10V X5R 0603 | C0603C564K8PACTU | 399-3115-1-ND
 | L1 | INDUCTOR SHIELD PWR 100UH SMD | DR74-101-R | 513-1225-1-ND | L1
* | D1 | DIODE SCHOTTKY 30V 3A SMA | B330A-13-F | B330A-FDICT-ND | D1
* | D2 | LED 470NM BLUE CLEAR 0603 SMD | SML-E12BC7TT86 | 511-1589-1-ND
* | IC1 | IC QUAD BUS BUF GATE 3ST 14TSSOP | SN74AHCT126PWR | 296-4660-1-ND
 | IC2 | DELETED
* | IC3 | LM2674M-5.0 | LM2674M-5.0/NOPB | LM2674M-5.0-ND
* | IC4 | IC BUS BUFF GATE DUAL 3ST 8VSSOP | SN74LVC2G126DCUR | 296-12555-1-ND
* | IC5 | MODULE BLUETOOTH W/ANT CLASS1 | RN-41 | WRL-08497 (Sparkfun) | 740-1007-ND - Sparkfun is less expensive
 | SKT1 | CONN TRANSFLSH R/A PUSH-PUSH SMD | 500873-0801 | PRT-00127 (Sparkfun)
 | S1 | SWITCH PB SPDT .4VA SMD | GP12MSV1BE | CKN9063CT-ND
 | S2 | SWITCH PB SPDT .4VA SMD | GP12MSV1BE | CKN9063CT-ND

Sheet: Regulation Tests
Regulation Load Test
Load | Description | Digikey P/N
50mA | 100ohm .5W resistor | PPC100XCT-ND
106mA | 47ohm 1W resistor | PPC47W-1CT-ND
208mA | 24ohm 2W resistor | BC24W-2CT-ND
313mA | 16ohm 2W resistor | BC16W-2CT-ND
417mA | 2x 6ohm 2W resistor (in series) | PPC6.2W-2CT-ND
