VictorZykov/molecubes/hardware/actuator/pcb/docs/BOM_Molecubes.xls

Bill of Materials
Manufacturer Part No. | Supplier Part No. | Qty | Design Reference | Description | Package | Pitch, mm | Cost, $ | Total, $ | 200 Qty | Totals | Vendor
Section 1: Parts below should be assembled on all 200 boards
TMK107BJ474KA-T | 587-1247-1-ND | 2 | C1, C9 | CAP CER .47UF 25V X5R 0603 | 0603 |  | 0.121 | 0.242 | 500 | 20.63 | digikey
GRM31CF50J226ZE01L | 490-1846-1-ND | 2 | C2, C8 | CAP CERAMIC 22UF 16V X5R 1206 | 1206 |  | 0.94 | 1.88 | 500 | 161.81 | digikey
C0603C104K8RACTU | 399-1095-1-ND | 2 | C5, C6 | CAP .10UF 10V CERAMIC X7R 0603 | 0603 (1608) |  | 0.023 | 0.046 | 500 | 3.94 | digikey
SN74LVC2G126DCUR | 296-12555-1-ND | 2 | IC1, IC4 | IC BUS BUFF GATE DUAL 3ST | 8-VSSOP | 0.5 | 0.48 | 0.96 | 500 | 84 | digikey
LM2940IMP-5.0/NOPB | LM2940IMP-5.0/NOPB | 2 | IC2, IC6 | IC 5V 1A LDO VREG SOT223 | SOT-223-4 |  | 2.15 | 4.3 | 420 | 392.7 | Newark
MCP120T-460I/TT | MCP120T-460I/TTCT-ND | 1 | IC5 | IC SUPRVSR 4.60V OPN DRAIN SOT23 | SOT-23-3 |  | 0.48 | 0.48 | 210 | 80.33 | digikey
PCA9633DP2-T | 568-3237-1-ND | 3 | IC7, IC8, IC9 | IC LED DRVR 4BIT I2C 10-TSSOP | 10-TSSOP | 0.5 | 1.3 | 3.9 | 610 | 411.75 | digikey
87340-0424 | WM18688-ND | 12 | J1, J2, J3, J4, J5, J6, J7, J8, J9, J10, J11, J12 | CONN RECEPT 4POS 2MM LOPRO SMD |  |  | 1.2 | 14.4 | 2520 | 1179.49 | digikey
GLF2012T100K | 445-3159-1-ND | 1 | L1 | INDUCTOR 10UH 140MA 10% 0805 | 0805 (2012) |  | 0.22 | 0.22 | 210 | 35.28 | digikey
OVSTRGBAC6 | 828-OVSTRGBAC6 | 3 | LED1, LED2, LED3 | LED RGB SMD 2.7 X 2.4 X 0.95 |  |  | 3.09 | 9.27 | 630 | 957.6 | mouser
NRPN022MAMS-RC |  | 12 | P1, P2, P3, P4, P5, P6, P7, P8, P9, P10, P11, P12 | CONN HEADER 2MM DUAL SMD 4POS |  | 2 | 0.7 | 8.4 | 2500 | 802.5 | Sullins
CSTCE16M0V53-R0 | 490-1198-1-ND | 1 | Q1 | RESONATOR 16.0MHZ CERAMIC | CERALOCK | 0.95 | 0.87 | 0.87 | 210 | 117.33 | digikey
EXB-28V243JX | Y7243CT-ND | 3 | R1, R5, R10 | RES ARRAY 24K OHM 5% 4 RES SMD | 0402x4 | 0.5 | 0.1 | 0.3 | 630 | 39.38 | digikey
MCR03EZPFX1502 | RHM15.0KHCT-ND | 2 | R2. R21 | RES 15.0K OHM 1/10W 1% 0603 SMD | 0603 |  | 0.076 | 0.152 | 420 | 9.83 | digikey
MCR03EZPFX4701 | RHM4.70KHCT-ND | 2 | R3, R4, | RES 4.70K OHM 1/10W 1% 0603 SMD | 0603 |  | 0.076 | 0.152 | 420 | 9.83 | digikey
MCR03EZPFX80R6 | RHM80.6HCT-ND | 6 | R6, R8, R11, R13, R15, R16 | RES 80.6 OHM 1/10W 1% 0603 SMD | 0603 |  | 0.076 | 0.456 | 1260 | 20.1 | digikey
MCR03EZPFX1500 | RHM150HCT-ND | 3 | R7, R12, R14 | RES 150 OHM 1/10W 1% 0603 SMD | 0603 |  | 0.076 | 0.228 | 630 | 14.74 | digikey
ATMEGA324P-20MU | ATMEGA324P-20MU-ND | 1 | U1 | IC AVR MCU 16K 16MHZ COM | 44-MLF | 0.5 | 5.13 | 5.13 | 505 | 815.9 | digikey
54132-5097 |  | 4 | X2, X3, X4, X5 | 0.5 FPC ZIF HSG ASSY 50CKT EMBSTP PKG, |  | 0.5 | 4.67 | 18.68 | 1500 | 1512.00 | MVP Micro
Section 2: Parts below should only be assembled on 60 out of 200 boards
B45197A3107K409 | 495-1548-1-ND | 1 | C10 | CAP TANT 100UF 16V 10% LOESR SMD | 7343-31 (EIA) |  | 1.05 | 1.05 | 63 | 57.27 | digikey
B45197A6156K409 | 495-1580-1-ND | 1 | C11 | CAP TANT 15UF 35V 10% LOESR SMD | 7343-31 (EIA) |  | 1 | 1 | 63 | 54.87 | digikey
GCM188R71H103KA37D | 490-4778-1-ND | 1 | C12 | CAP CER .01UF 50V X7R 0603 | 0603 |  | 0.037 | 0.037 | 70 | 2.59 | digikey
B330A-13-F | B330A-FDICT-ND | 1 | D1 | DIODE SCHOTTKY 30V 3A SMA | SMA |  | 0.94 | 0.94 | 63 | 51.22 | digikey
LM2675M-ADJ/NOPB | LM2675M-ADJ-ND | 1 | IC10 | IC REG SIMPLE SWITCHER 8-SOIC | 8-SOIC | 0.5 | 4 | 4 | 63 | 191.52 | digikey
DR1050-680-R | 704-DR1050-680-R | 1 | L2 | 68uH 1.7A 111mOhms |  |  | 1.92 | 1.92 | 63 | 81.27 | mouser
RR0816P-8250-D-89A | RR08P825DCT-ND | 1 | R17 | RES 825 OHM 1/16W .5% 0603 SMD | 0603 |  | 0.14 | 0.14 | 70 | 5.28 | digikey
RR0816P-6041-D-76H | RR08P6.04KDCT-ND | 1 | R18 | RES 6.04K OHM 1/16W .5% 0603 SMD | 0603 |  | 0.14 | 0.14 | 70 | 5.28 | digikey
Section 3: Parts below should not be assembled on any boards
TMK107BJ474KA-T |  | 1 | C3 | CAP CER .47UF 25V X5R 0603 | 0603 |  | 0.121 | 0.121 | 500 | 20.63 | digikey
GRM31CF50J226ZE01L |  | 1 | C4 | CAP CERAMIC 22UF 16V X5R 1206 | 1206 |  | 0.94 | 0.94 | 500 | 161.81 | digikey
LM2940IMP-10 |  | 1 | IC3 | IC LDO REGULATOR SOT-223-4 | SOT-223-4 |  | 2.15 | 2.15 | 75 | 120 | Newark
ECJ-1VB1C563K |  | 1 | C7 | CAP 56000PF 16V CERM X7R 0603 | 0603 |  | 0.036
RC0603FR-0780K6L |  | 1 | R9 | RES 80.6K OHM 1/10W 1% 0603 SMD | 0603 |  | 0.077
AH180-PL-A |  | 1 | Hall Effect Sensor | IC SENSOR SWITCH HALL SIP-3L | SIP-3L |  | 1.58
 |  | Notes |  |  |  |  |  | 82.504 |  | 7420.88
 |  | 1. | 87340-0414 and 87340-0454 are similar to 87340-0424 and 87340-0464, except they do not have bottom locating pegs
 |  | 2. | R9, C3, C4, C7, IC3, JP1, JP2, JP4, and JP5 should not be assembled on any boards
 |  | 3. | C10, C11, C12, D1, IC10, L2, R17, and R18 should only be assembled on 60 out of 200 sets
Drill Rack
0.052" |  | Large wire mounting holes
0.040" |  | Mounting holes for JP1, JP2, JP4, JP5
0.020" |  | All other vias and X1
