VictorZykov/molecubes/doc/datasheets/LPC2148/chemical_LPC2141FBD64.xls

As a proactive and sustainable company, NXP has decided to publish chemical content information of its product portfolio through direct Internet access. With this information, we can provide data to our customers to facilitate any assessment regarding compliance to the RoHS directive and lead-free status. NXP has set a standard in the semiconductor business with this detailed level of data, directly retrieved from its general product database. NXP products are compliant to the EU Directives RoHS, WEEE, ELV and the China RoHS. Please see also our Restricted Substances Declaration.
Typenumber | Package | Package description | Moisture Sensitivity Level | Total product weight
LPC2141FBD64 | SOT314-2 | LQFP64 |  | 367 mg
Subpart | Material group | Substances | CAS number | Mass(mg) | Mass(%)
Wire | Other | Gold (Au) | 7440-57-5 | 02.42 | 00.66
Component | Other | Copper (Cu) | 7440-50-8 | 88.54 | 24.10
 |  | Nickel (Ni) | 7440-02-0 | 02.74 | 00.75
 |  | Silver (Ag) | 7440-22-4 | 02.73 | 00.74
 |  | Tin (Sn) | 7440-31-5 | 02.01 | 00.55
 |  | Subtotal |  | 96.02 | 26.13
Mould compound | Other | Epoxy resin system |  | 39.76 | 10.82
 |  | Misc. silica compounds |  | 208.74 | 56.81
 |  | Subtotal |  | 248.50 | 67.63
Adhesive | Other | Resin system |  | 00.30 | 00.08
 |  | Silver (Ag) | 7440-22-4 | 01.19 | 00.32
 |  | Subtotal |  | 01.49 | 00.40
Die | Other | Silicon (Si) | 7440-21-3 | 19.02 | 05.18
 |  | Total |  | 367 | 100.00
Disclaimer
All information in this document is furnished for exploratory or indicative purposes only. All information in this document is believed to be accurate and reliable. However, NXP does not give any representations or warranties as to the accuracy or completeness of such information and shall have no liability for the consequences of use of such information. NXP may make changes to information published in this document at any time and without notice. Minor deviations may occur in the products from different manufacturing location. This document supersedes and replaces all information supplied prior to the publication hereof. Nothing in this document may be interpreted or construed as an offer to sell products that is open for acceptance or the grant, conveyance or implication of any license under any copyrights, patents or other industrial or intellectual property rights.
