VictorZykov/molecubes/hardware/passive/DummyHalf.SLDASM

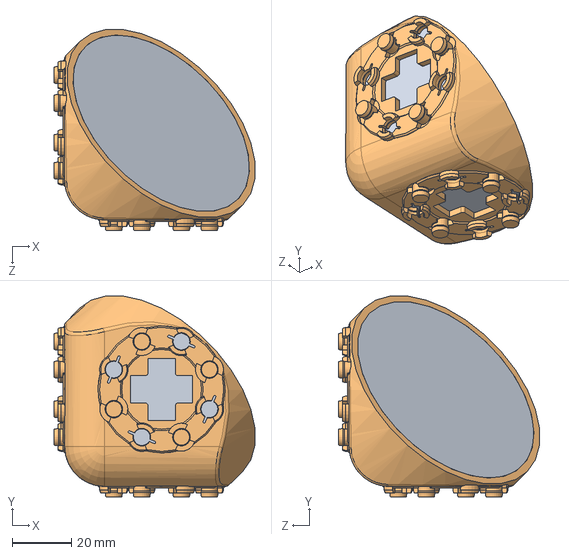
[picture p13: CAD file, 2019-09-05]
hardware/passive/DummyHalf.SLDASM
68.0 x 68.0 x 68.0 mm
DummyFiller
DummyShell
