VictorZykov/molecubes/hardware/battery/solidworks/Battery.SLDASM

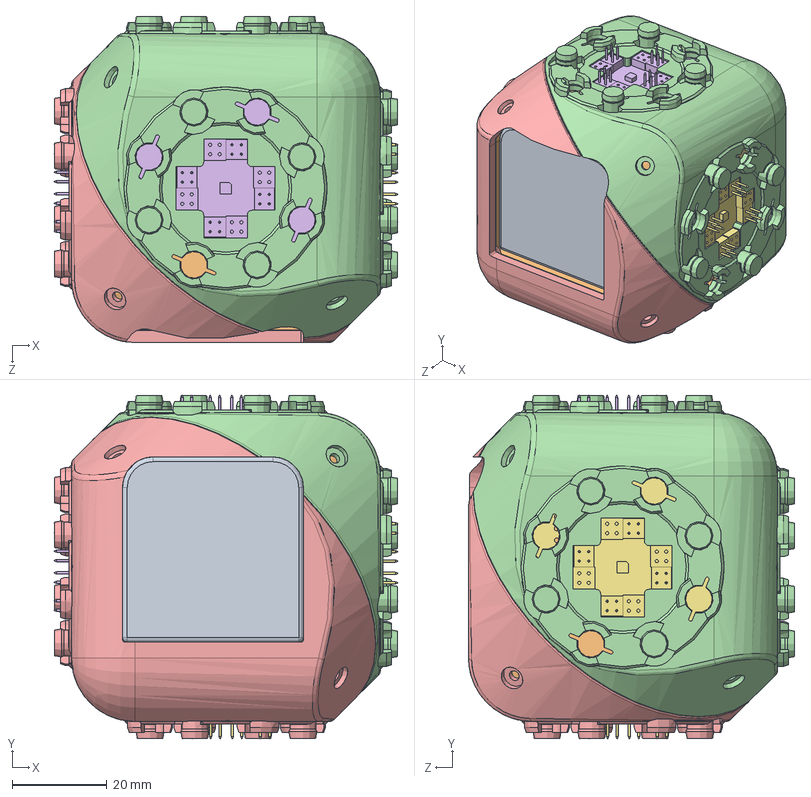
[picture p14: CAD file, 2019-09-05]
hardware/battery/solidworks/Battery.SLDASM
72.8 x 72.8 x 69.0 mm
SamsungBattery
BatteryEnclosure
BatteryPCB
SnapShellBatteryOpposite
SnapShellBattery
PCB_M x 2
PCB_R x 2
