VictorZykov/molecubes/hardware/wheel/Wheel.SLDASM

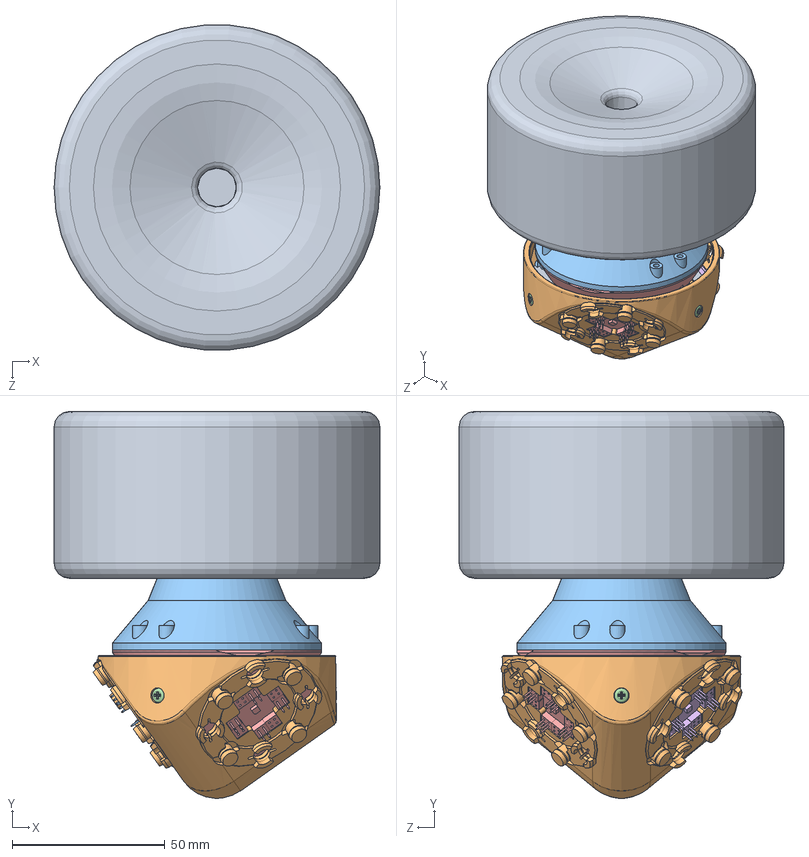
[picture p15: CAD file, 2019-09-05]
hardware/wheel/Wheel.SLDASM
106.7 x 126.7 x 106.4 mm
Tyre
SnapShell
PCB_M
ShortTopCasing
InternalGear
ThinBearing
AX12_Top
Pinion
MotorHolder
AX12_body
WheelAxle
Bolt x 3
PCB_L
PCB_R_power
