VictorZykov/molecubes/hardware/passive/Dummy.SLDASM

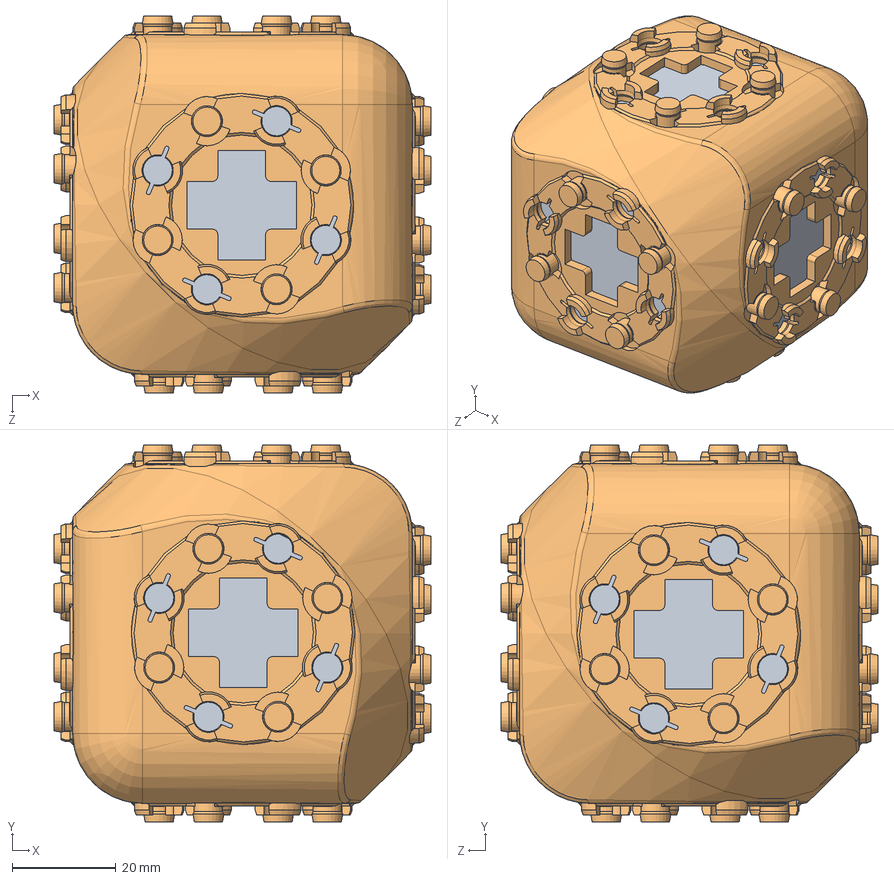
[picture p16: CAD file, 2019-09-05]
hardware/passive/Dummy.SLDASM
72.5 x 72.5 x 72.5 mm
DummyFiller x 2
DummyShell x 2
