VictorZykov/molecubes/hardware/actuator/solidworks/Actuator.SLDASM

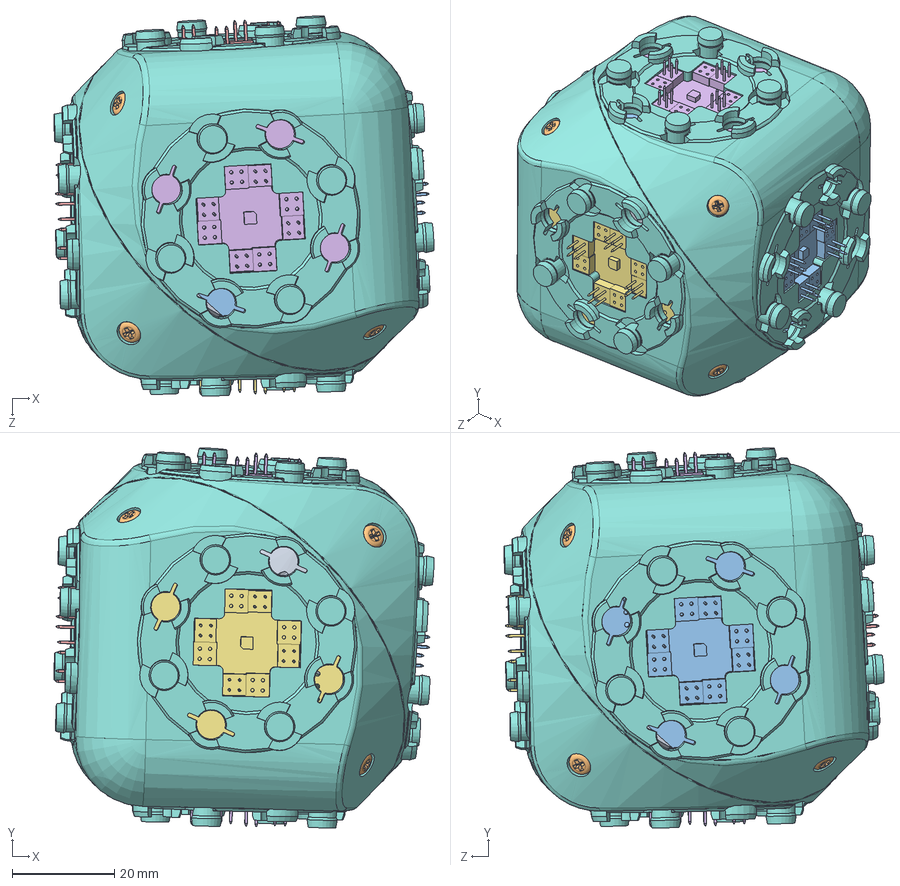
[picture p17: CAD file, 2019-09-05]
hardware/actuator/solidworks/Actuator.SLDASM
74.4 x 74.4 x 74.4 mm
Pinion
AX12_body
GearHolder
MotorHolder
slipRing
TopCasing
ThinBearing
AX12_Top
InternalGear
Bolt x 6
PCB_R
PiherPot
PCB_L x 2
PCB_M x 2
PCB_R_power
SnapShell x 2
