VictorZykov/molecubes/hardware/passive/PassiveCardan.SLDASM

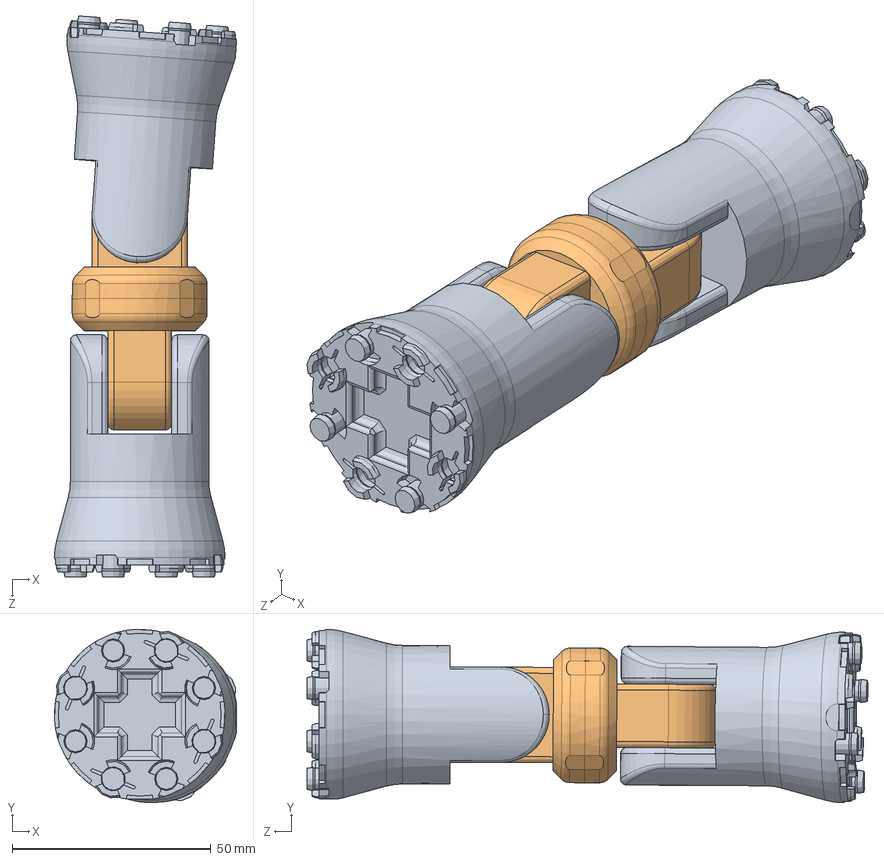
[picture p18: CAD file, 2019-09-05]
hardware/passive/PassiveCardan.SLDASM
45.9 x 43.7 x 141.3 mm
PassiveHinge x 2
HingePin x 2
