VictorZykov/molecubes/hardware/controller/solidworks/ARMCube.SLDASM

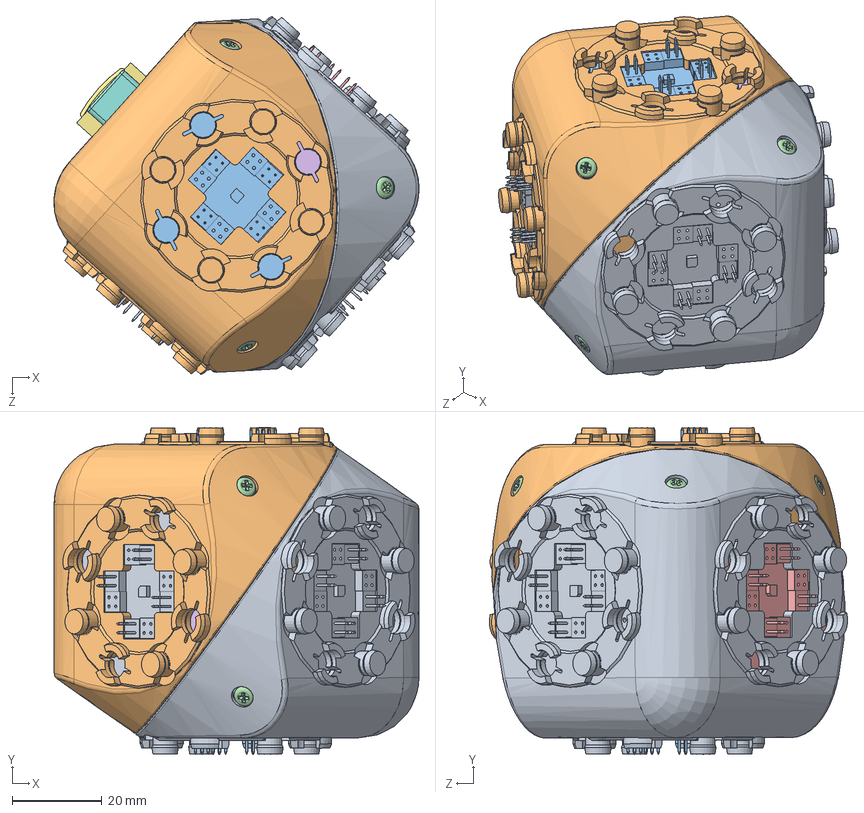
[picture p19: CAD file, 2019-09-05]
hardware/controller/solidworks/ARMCube.SLDASM
81.3 x 72.8 x 79.8 mm
PCB_L x 2
ARMHousingBack
PCB_M x 2
Bolt x 6
PCB_R
ARMHousing
DaughterBoard
OlimexMSP430
SnapShell
SnapShellController
