VictorZykov/molecubes/hardware/gripper/solidworks/GripperFDM.SLDASM

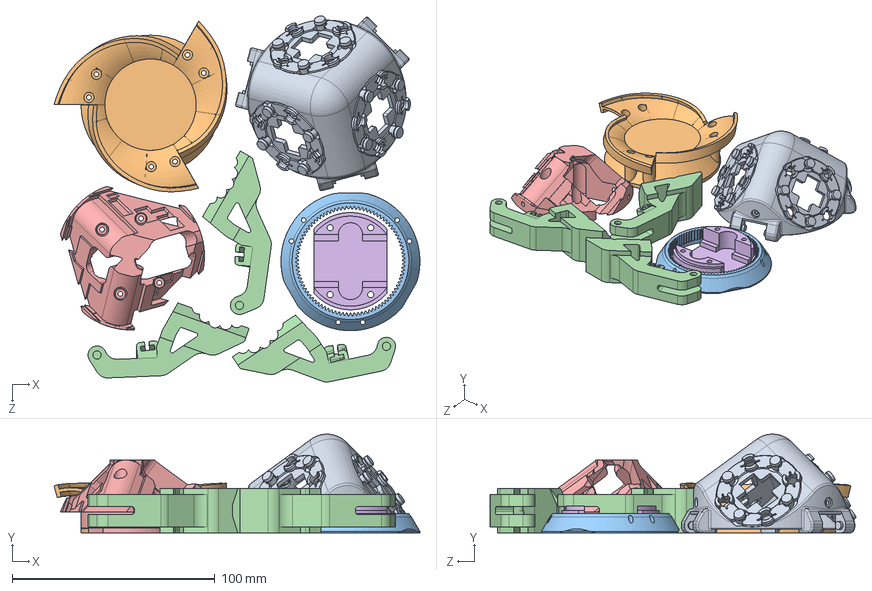
[picture p20: CAD file, 2019-09-05]
hardware/gripper/solidworks/GripperFDM.SLDASM
180.5 x 48.8 x 180.5 mm
AxleSnapShell
GripperDriver
InternalGear
Jaw x 3
MotorHolder
ShortTopCasing
