VictorZykov/molecubes/software/CubeInterface/3DModels/SimpleFullCubeCollision.STL

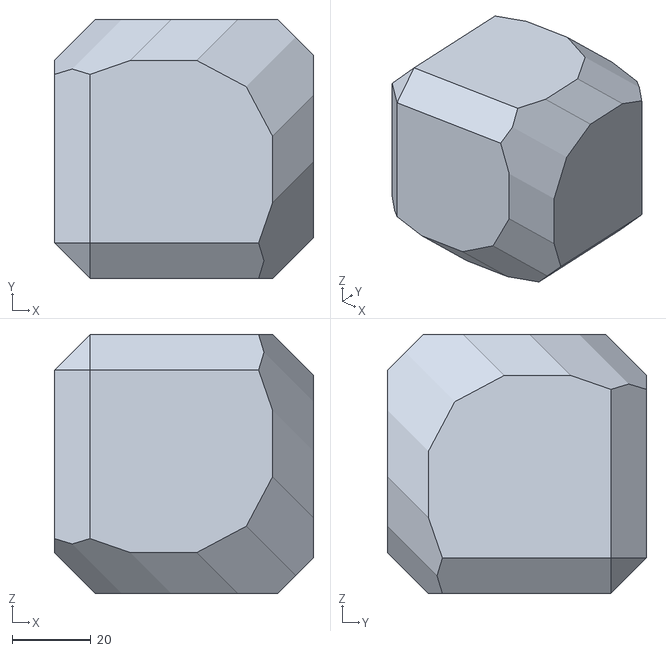
[picture p21: CAD file, 2019-09-05]
software/CubeInterface/3DModels/SimpleFullCubeCollision.STL
65.6 x 65.6 x 65.6
