VictorZykov/molecubes/hardware/actuator/solidworks/SnapShell.SLDASM

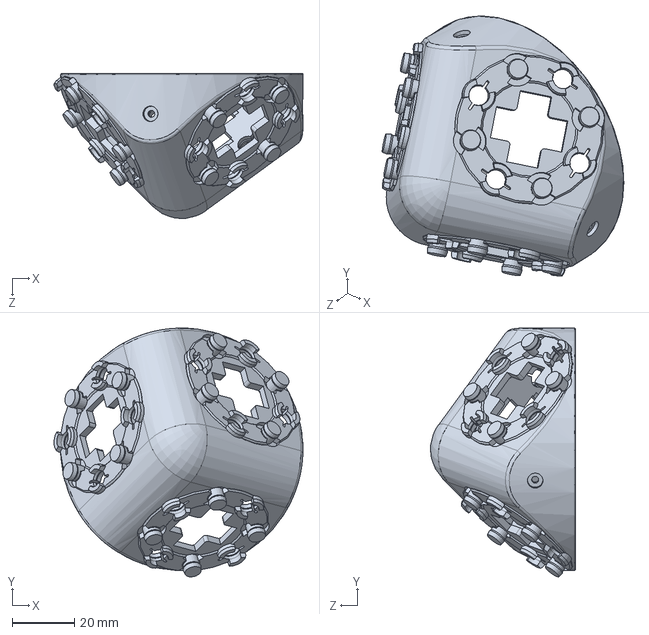
[picture p22: CAD file, 2019-09-05]
hardware/actuator/solidworks/SnapShell.SLDASM
80.2 x 80.1 x 46.8 mm
