VictorZykov/molecubes/hardware/controller/solidworks/ARMCumeFDM.SLDASM

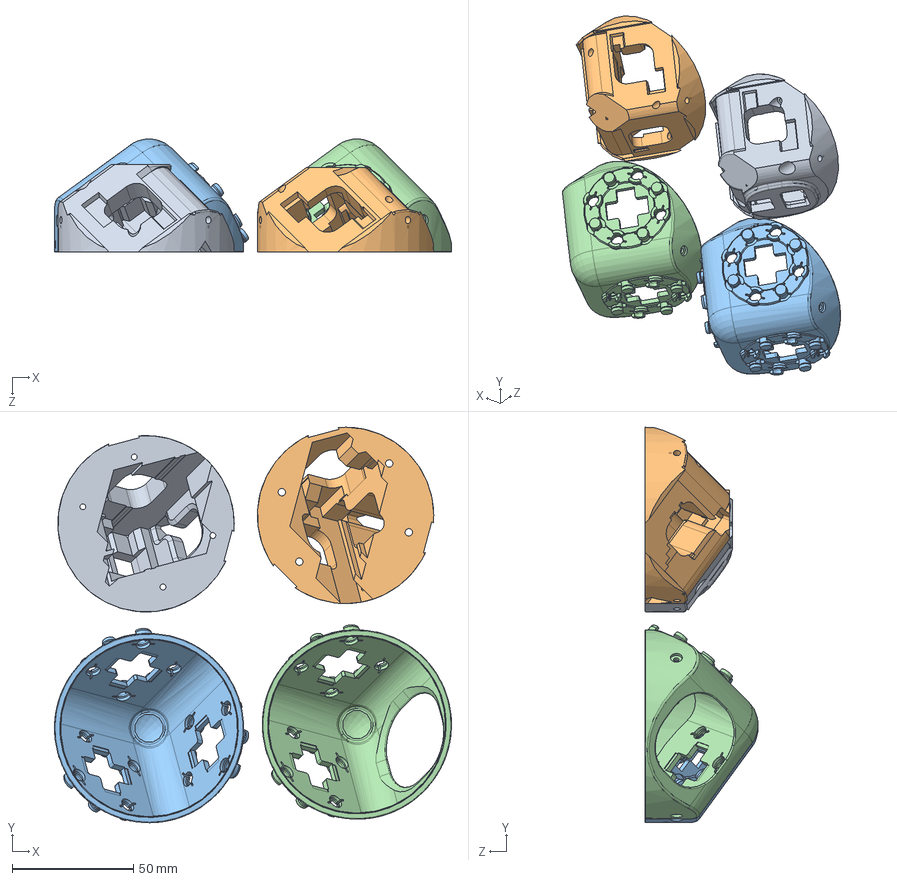
[picture p23: CAD file, 2019-09-05]
hardware/controller/solidworks/ARMCumeFDM.SLDASM
163.8 x 163.3 x 46.8 mm
ARMHousing
ARMHousingBack
SnapShell
SnapShellController
