VictorZykov/molecubes/hardware/gripper/solidworks/Gripper.SLDASM

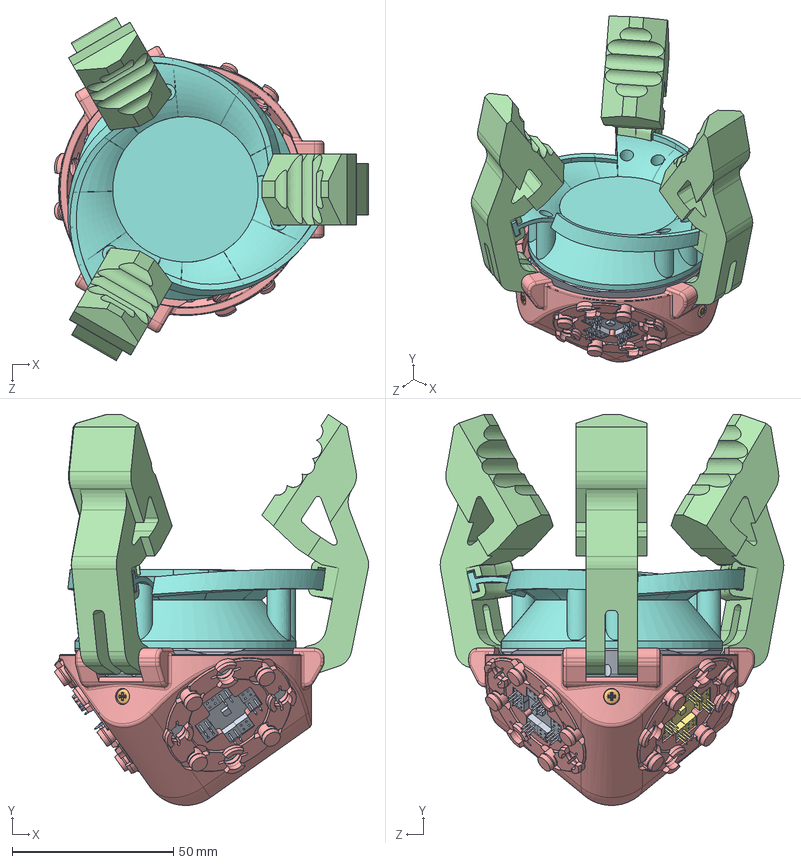
[picture p24: CAD file, 2019-09-05]
hardware/gripper/solidworks/Gripper.SLDASM
97.3 x 121.1 x 106.4 mm
PCB_L
Bolt x 3
PCB_M
Jaw x 3
AxleSnapShell
ShortTopCasing
PCB_R_power
GripperDriver
InternalGear
ThinBearing
AX12_Top
Pinion
MotorHolder
AX12_body
