VictorZykov/molecubes/hardware/actuator/solidworks/ActuatorFDM.SLDASM

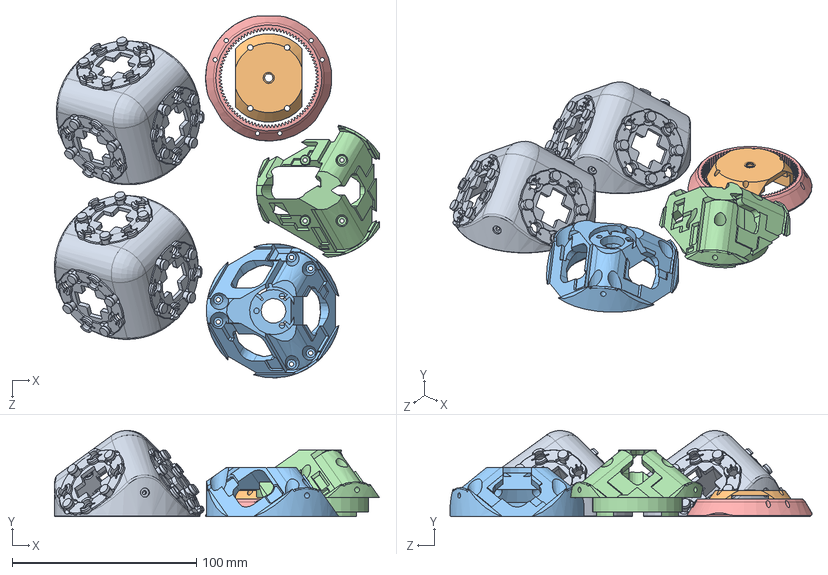
[picture p25: CAD file, 2019-09-05]
hardware/actuator/solidworks/ActuatorFDM.SLDASM
176.4 x 46.8 x 196.4 mm
SnapShell x 2
TopCasing
GearHolder
MotorHolder
InternalGear
