VictorZykov/molecubes/doc/datasheets/rn41/RN41-pads.dxf

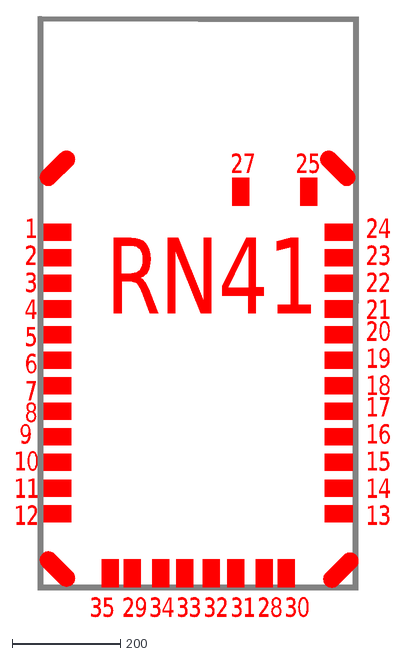
[picture p26: CAD file, 2019-09-05]
doc/datasheets/rn41/RN41-pads.dxf
1
2
3
4
5
6
7
8
9
10
11
12
24
23
22
21
20
19
18
14
13
15
17
16
35
29
34
27
25
33
32
31
28
30
RN41
