VictorZykov/molecubes/hardware/actuator/solidworks/PiherPot.SLDPRT

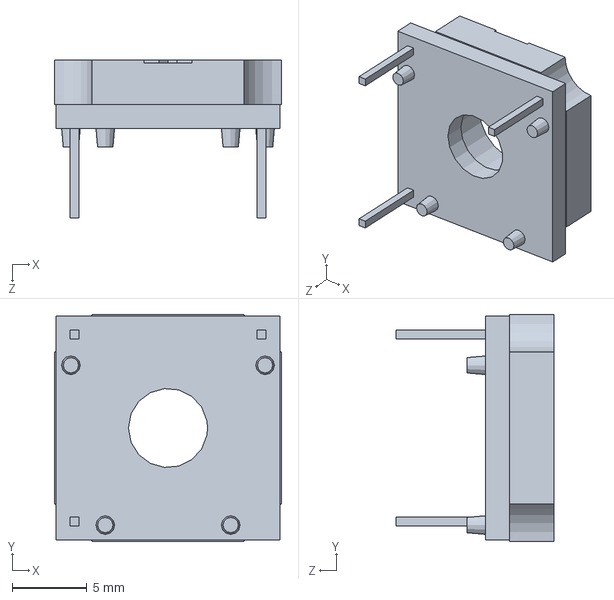
[picture p27: CAD file, 2019-09-05]
hardware/actuator/solidworks/PiherPot.SLDPRT
15.2 x 15.2 x 10.6 mm
