VictorZykov/molecubes/hardware/battery/solidworks/PCB_R.SLDPRT

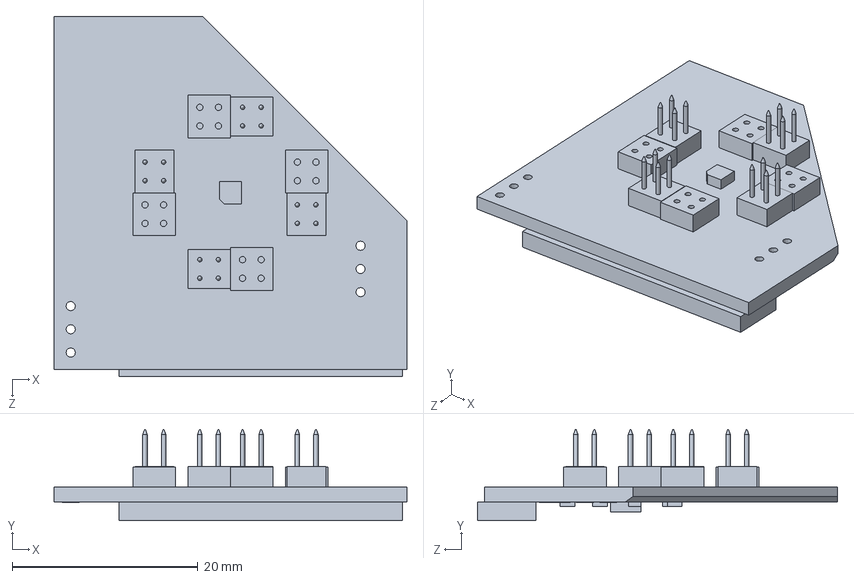
[picture p28: CAD file, 2019-09-05]
hardware/battery/solidworks/PCB_R.SLDPRT
38.0 x 9.80 x 38.8 mm
