VictorZykov/molecubes/hardware/gripper/solidworks/Jaw.SLDPRT

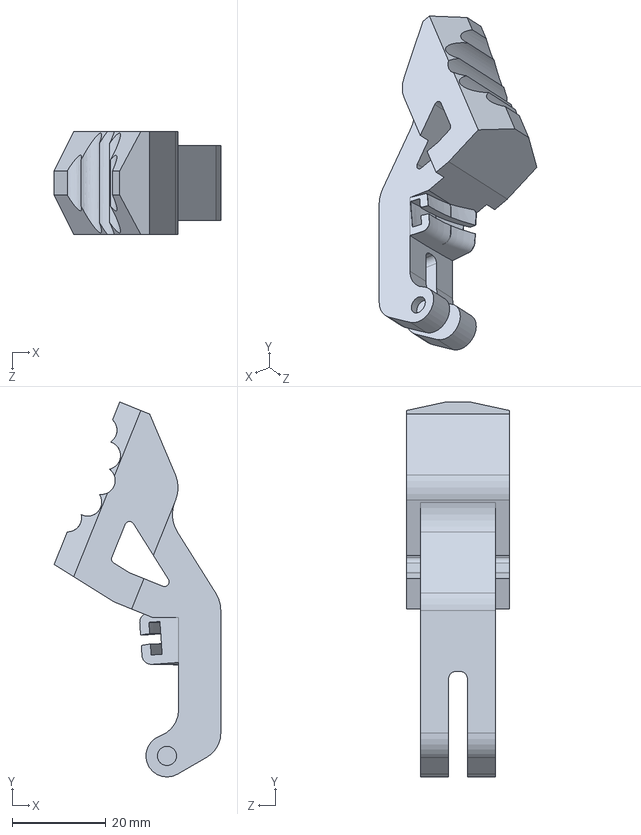
[picture p29: CAD file, 2019-09-05]
hardware/gripper/solidworks/Jaw.SLDPRT
35.6 x 80.0 x 22.0 mm
