VictorZykov/molecubes/hardware/passive/STL/PassiveCardanCore.STL

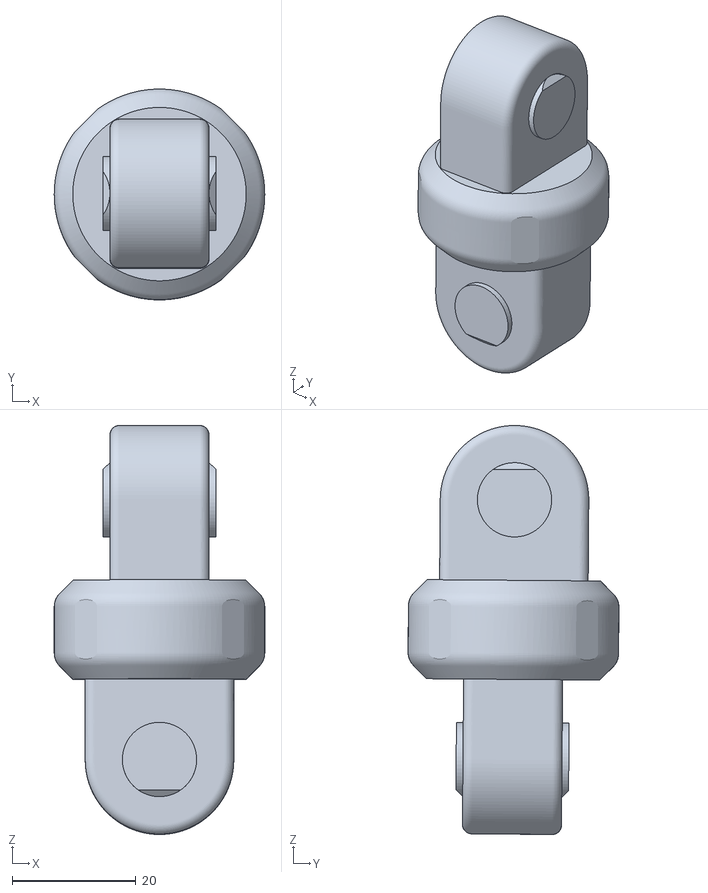
[picture p30: CAD file, 2019-09-05]
hardware/passive/STL/PassiveCardanCore.STL
34.0 x 34.1 x 66.0
