VictorZykov/molecubes/hardware/wheel/InternalGear.SLDPRT

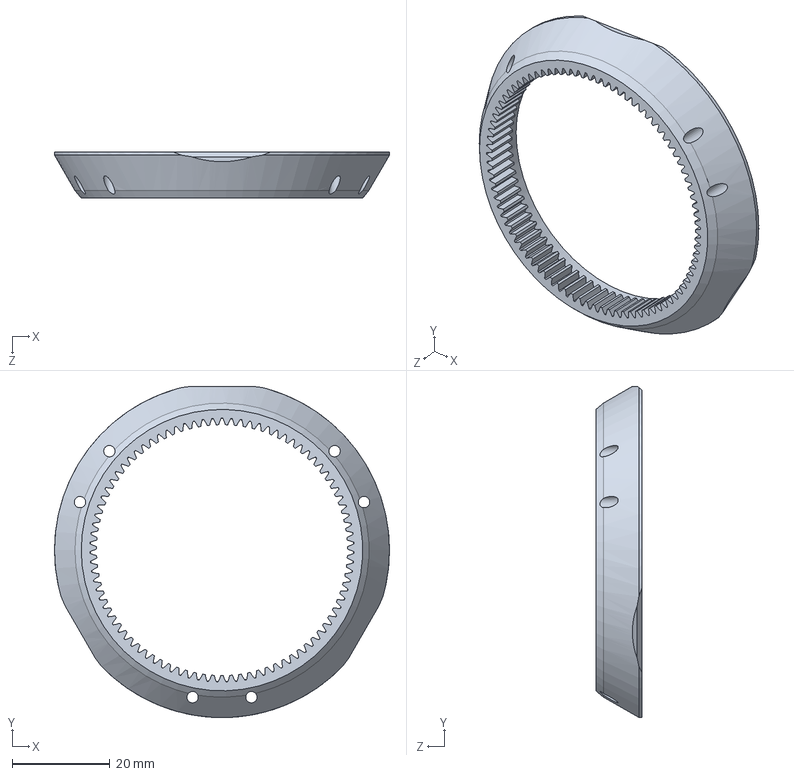
[picture p31: CAD file, 2019-09-05]
hardware/wheel/InternalGear.SLDPRT
68.6 x 67.8 x 9.49 mm
