VictorZykov/molecubes/software/CubeInterface/3DModels/GripperCollision.STL

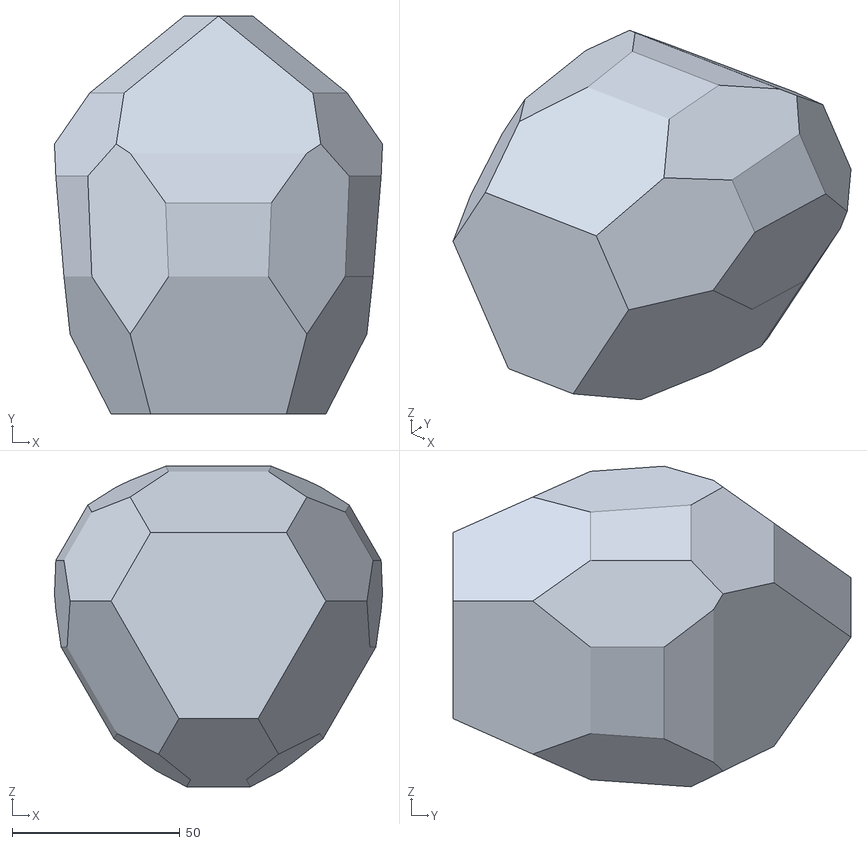
[picture p32: CAD file, 2019-09-05]
software/CubeInterface/3DModels/GripperCollision.STL
97.9 x 118.8 x 95.7
