VictorZykov/molecubes/hardware/actuator/solidworks/PCB_R_power.SLDPRT

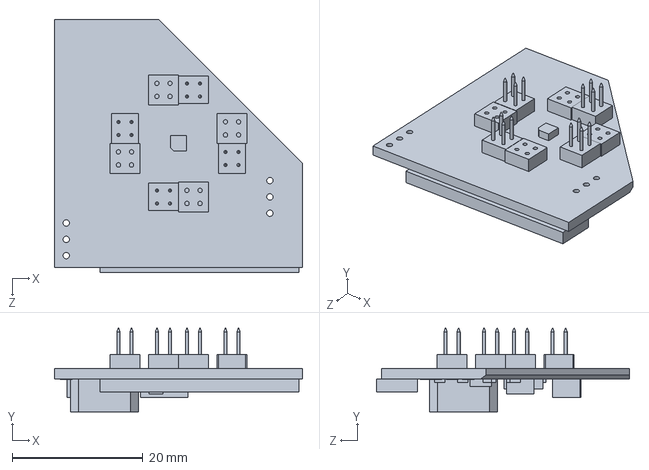
[picture p34: CAD file, 2019-09-05]
hardware/actuator/solidworks/PCB_R_power.SLDPRT
38.0 x 12.8 x 38.8 mm
