VictorZykov/molecubes/hardware/controller/solidworks/DaughterBoard.SLDPRT

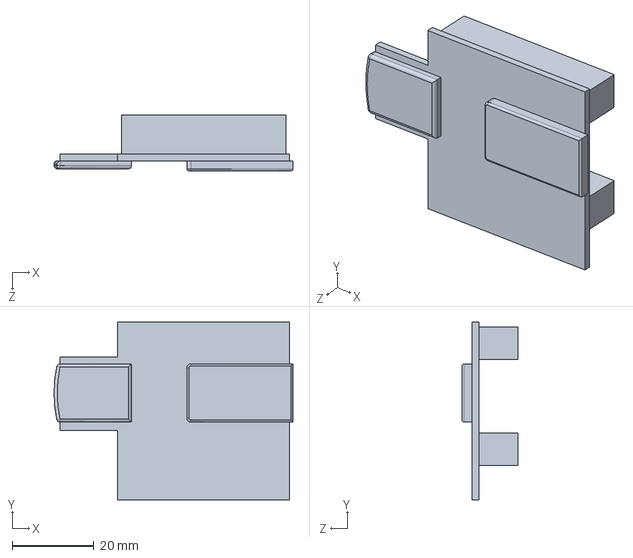
[picture p35: CAD file, 2019-09-05]
hardware/controller/solidworks/DaughterBoard.SLDPRT
58.5 x 43.5 x 13.7 mm
