VictorZykov/molecubes/hardware/gripper/solidworks/ShortTopCasing.SLDPRT

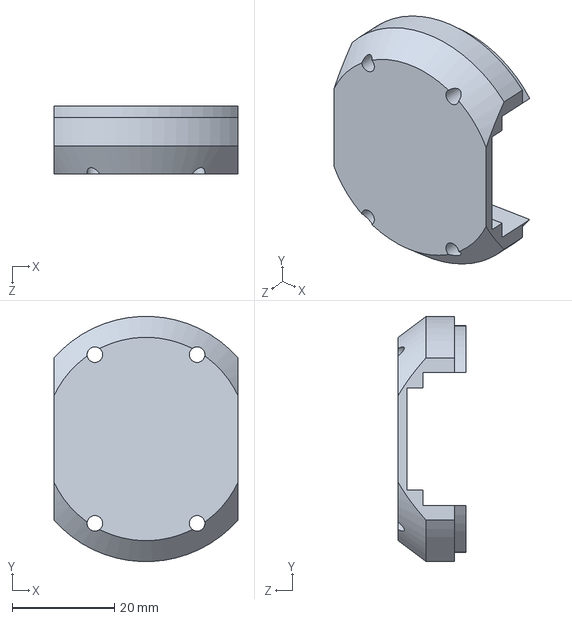
[picture p36: CAD file, 2019-09-05]
hardware/gripper/solidworks/ShortTopCasing.SLDPRT
36.0 x 47.9 x 13.2 mm
