VictorZykov/molecubes/hardware/passive/PassiveFoot.SLDPRT

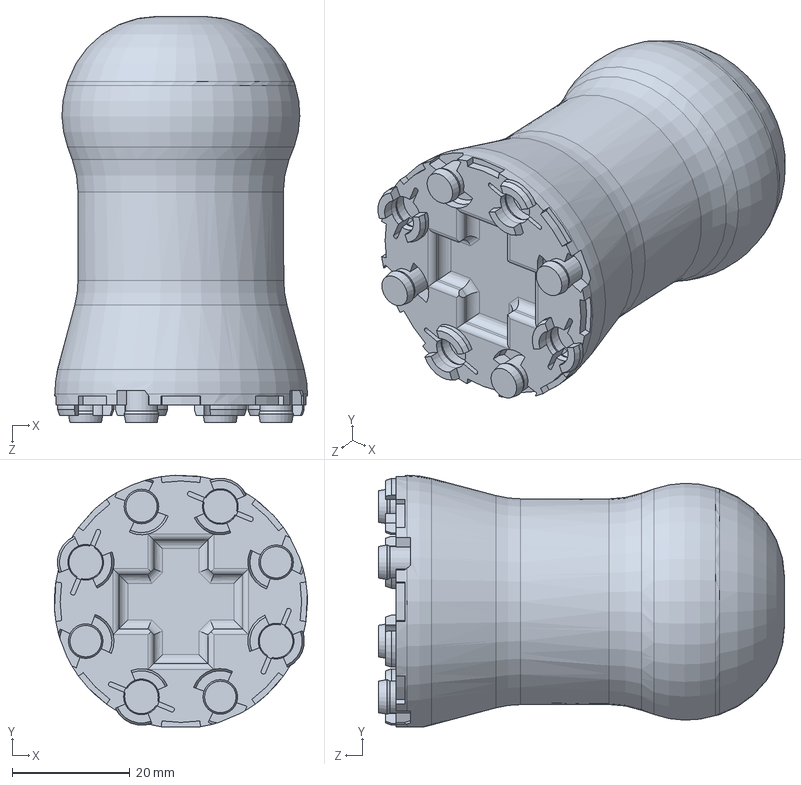
[picture p37: CAD file, 2019-09-05]
hardware/passive/PassiveFoot.SLDPRT
43.0 x 42.7 x 69.0 mm
