VictorZykov/molecubes/software/CubeInterface/3DModels/SimpleBattery.STL

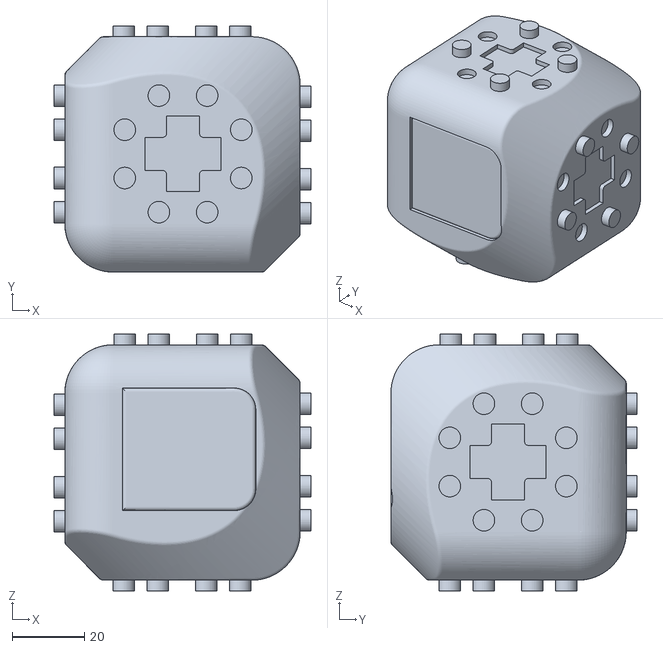
[picture p38: CAD file, 2019-09-05]
software/CubeInterface/3DModels/SimpleBattery.STL
71.3 x 68.3 x 71.3
