VictorZykov/molecubes/hardware/actuator/solidworks/slipRing.SLDPRT

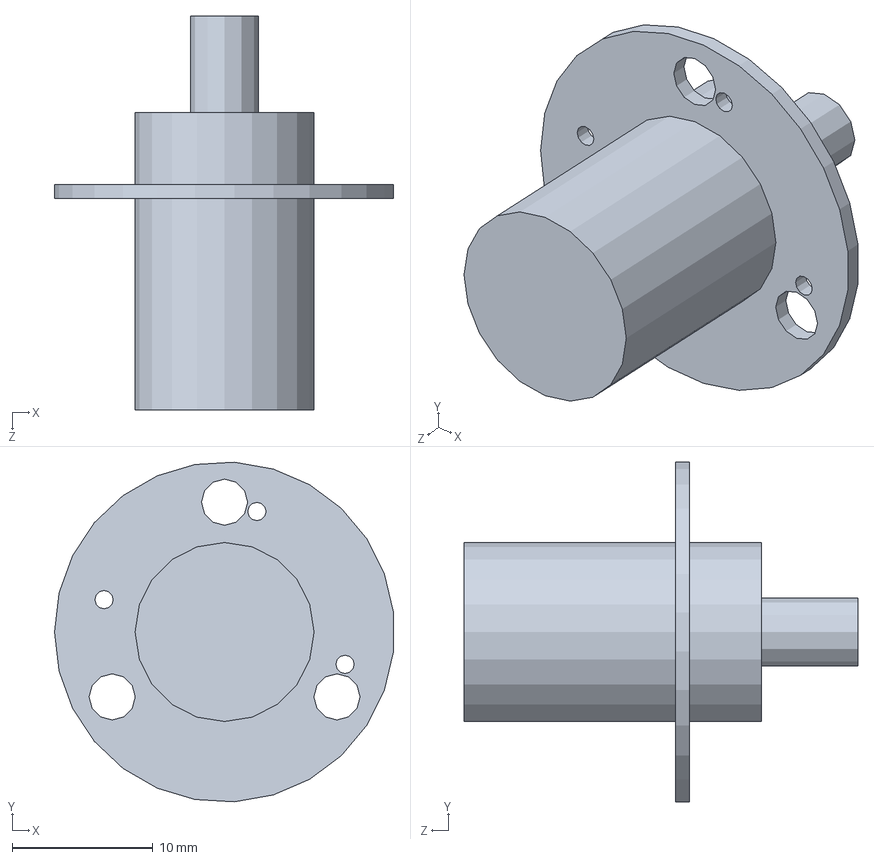
[picture p39: CAD file, 2019-09-05]
hardware/actuator/solidworks/slipRing.SLDPRT
24.0 x 24.1 x 27.9 mm
