VictorZykov/molecubes/hardware/battery/solidworks/SamsungBattery.SLDPRT

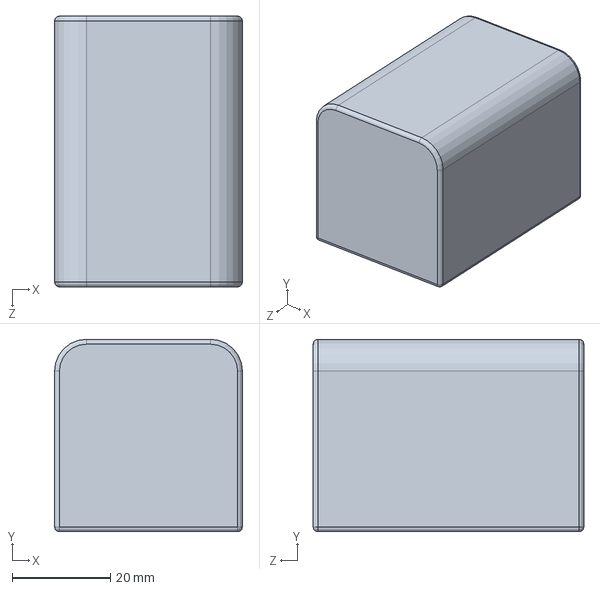
[picture p40: CAD file, 2019-09-05]
hardware/battery/solidworks/SamsungBattery.SLDPRT
38.3 x 39.2 x 55.2 mm
