VictorZykov/molecubes/hardware/controller/solidworks/PCB_L.SLDPRT

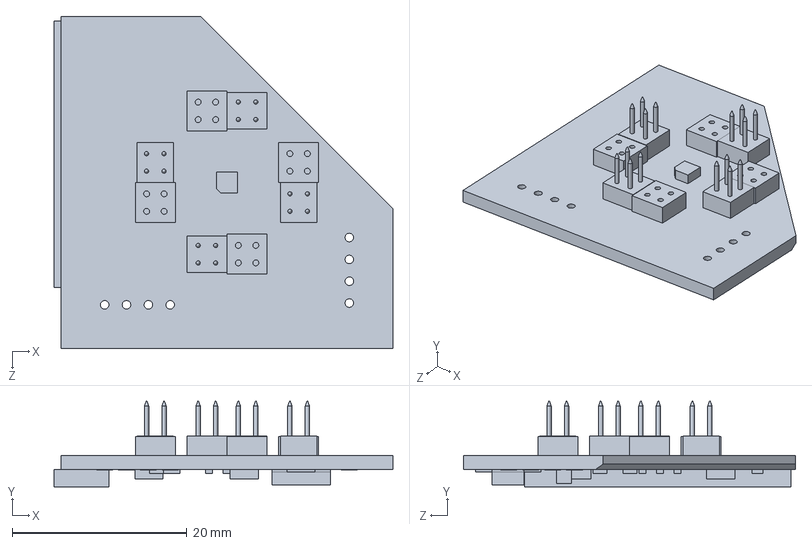
[picture p41: CAD file, 2019-09-05]
hardware/controller/solidworks/PCB_L.SLDPRT
38.8 x 9.80 x 38.0 mm
