VictorZykov/molecubes/hardware/gripper/solidworks/AX12_body.SLDPRT

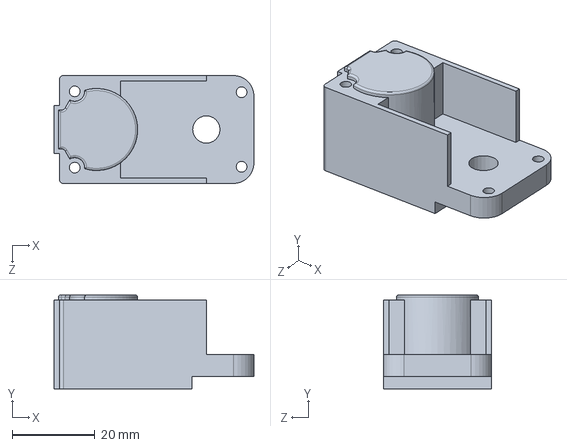
[picture p42: CAD file, 2019-09-05]
hardware/gripper/solidworks/AX12_body.SLDPRT
48.3 x 22.7 x 26.1 mm
