VictorZykov/molecubes/software/CubeInterface/3DModels/SimpleController.STL

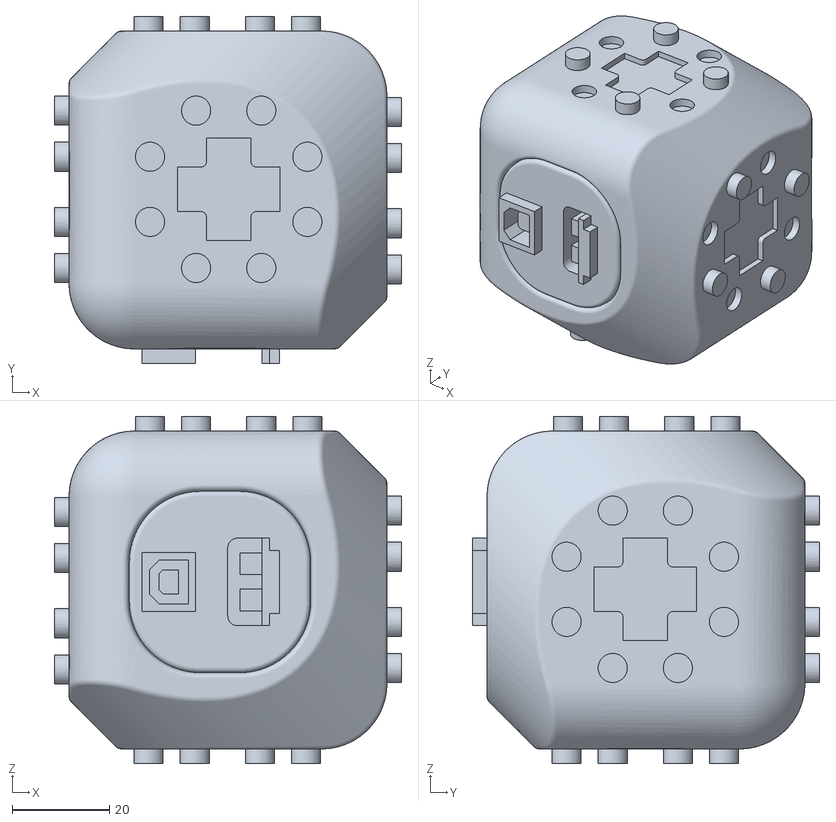
[picture p43: CAD file, 2019-09-05]
software/CubeInterface/3DModels/SimpleController.STL
71.3 x 71.3 x 71.3
