VictorZykov/molecubes/hardware/actuator/solidworks/MotorHolder.SLDPRT

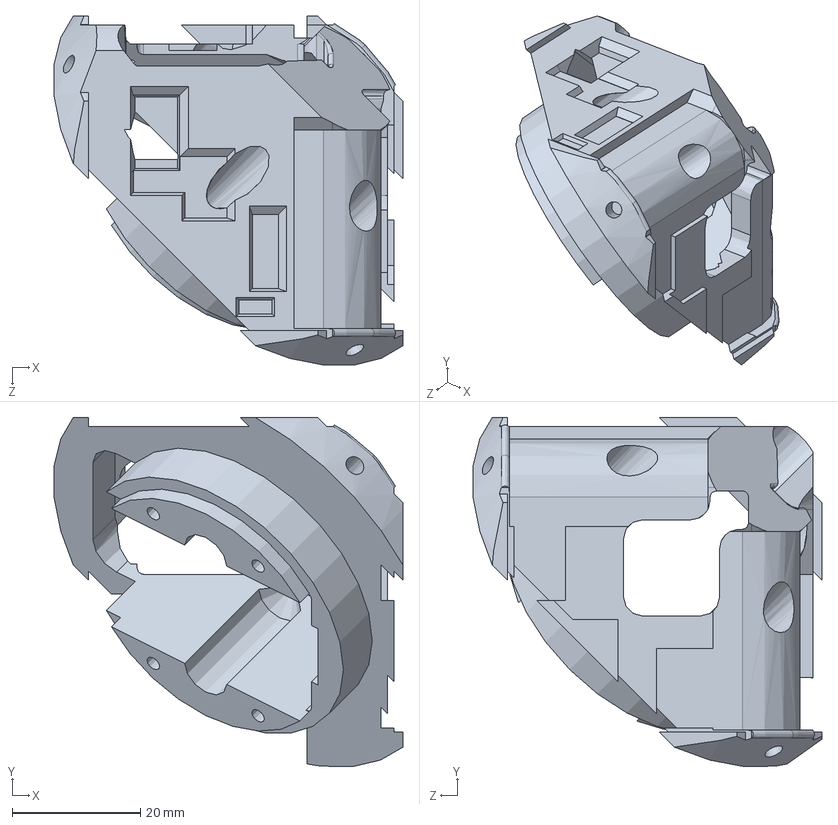
[picture p44: CAD file, 2019-09-05]
hardware/actuator/solidworks/MotorHolder.SLDPRT
54.4 x 54.4 x 54.4 mm
