VictorZykov/molecubes/hardware/battery/solidworks/SnapShellBatteryOpposite.SLDPRT

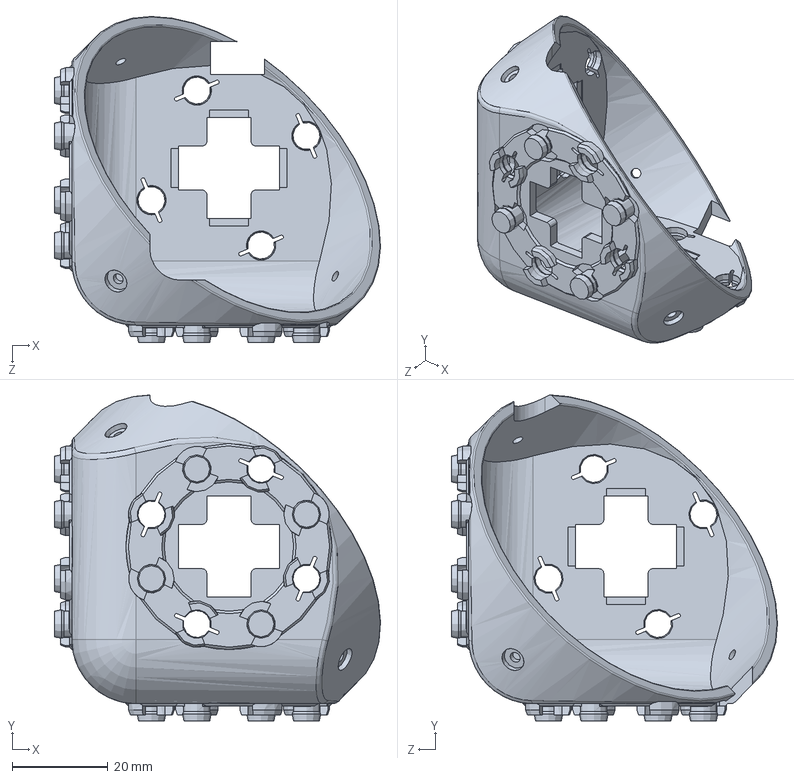
[picture p45: CAD file, 2019-09-05]
hardware/battery/solidworks/SnapShellBatteryOpposite.SLDPRT
68.0 x 68.0 x 68.0 mm
