VictorZykov/molecubes/hardware/controller/solidworks/ARMHousingBack.SLDPRT

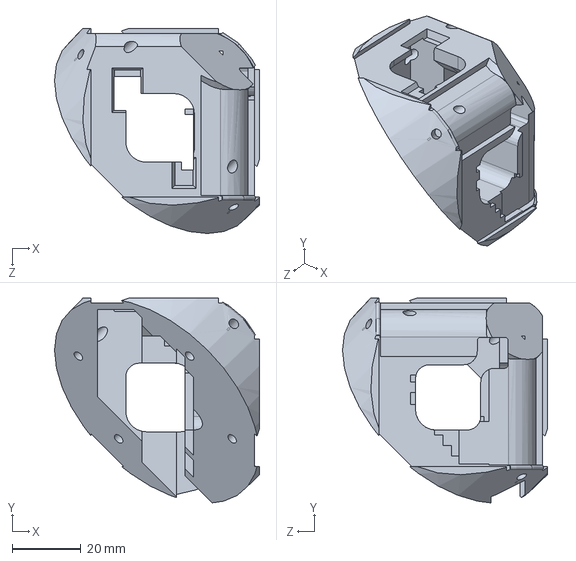
[picture p46: CAD file, 2019-09-05]
hardware/controller/solidworks/ARMHousingBack.SLDPRT
59.7 x 59.7 x 59.7 mm
