VictorZykov/molecubes/hardware/gripper/solidworks/ThinBearing.SLDPRT

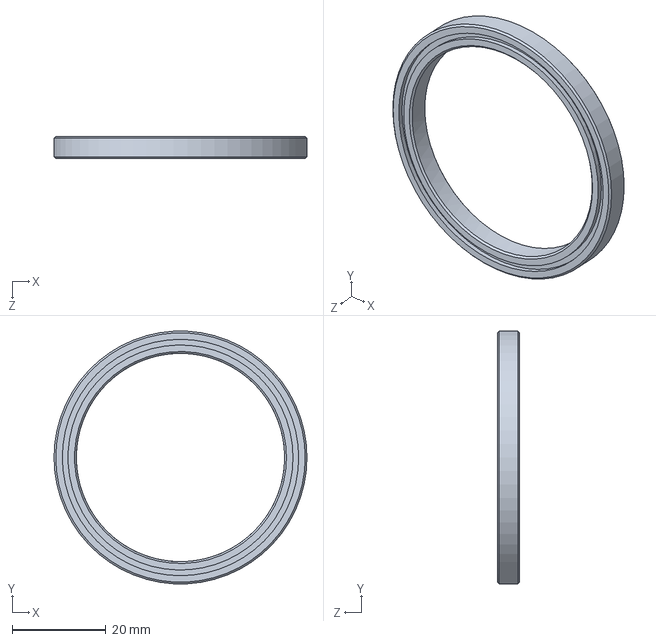
[picture p47: CAD file, 2019-09-05]
hardware/gripper/solidworks/ThinBearing.SLDPRT
54.0 x 53.9 x 4.76 mm
