VictorZykov/molecubes/hardware/passive/PassiveRodSocket.SLDPRT

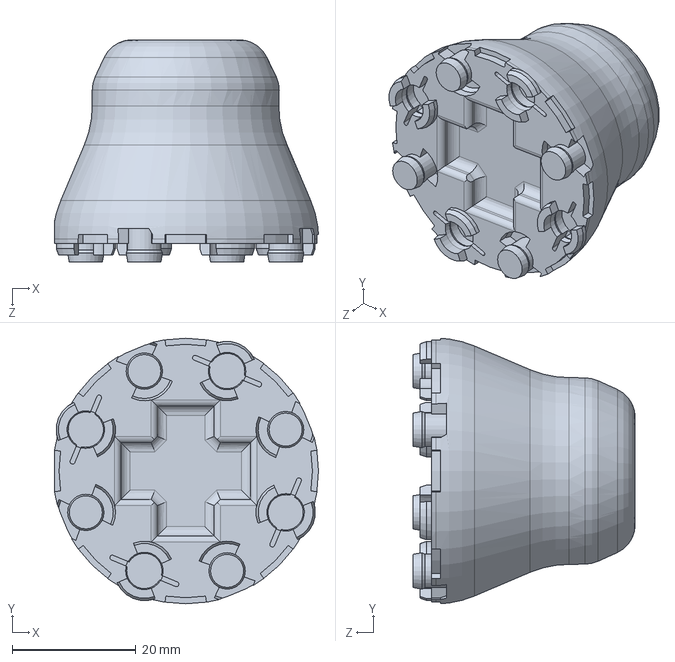
[picture p48: CAD file, 2019-09-05]
hardware/passive/PassiveRodSocket.SLDPRT
42.7 x 43.0 x 36.0 mm
