VictorZykov/molecubes/software/CubeInterface/3DModels/TwoHalfPinsCollision.STL

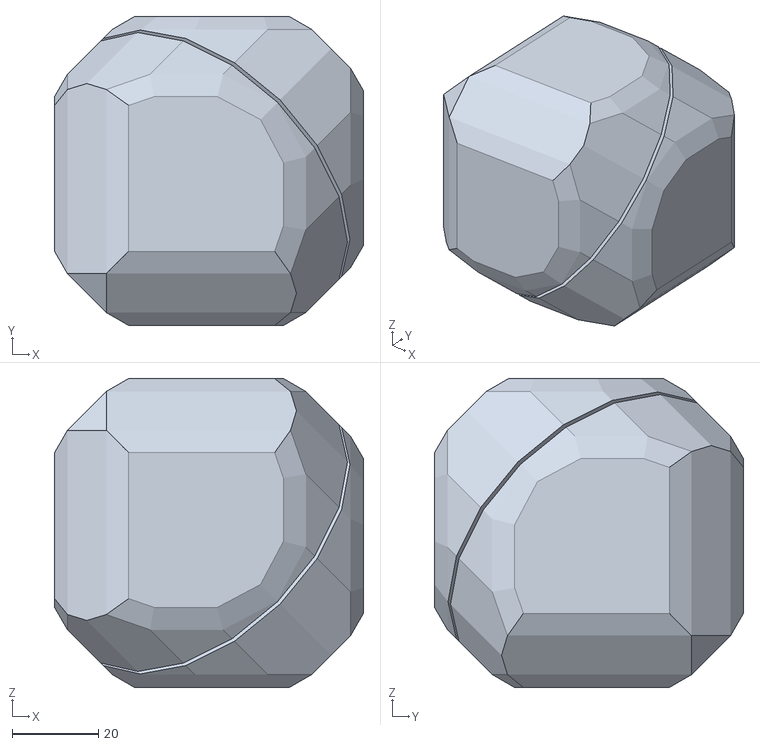
[picture p49: CAD file, 2019-09-05]
software/CubeInterface/3DModels/TwoHalfPinsCollision.STL
71.6 x 71.6 x 71.6
