VictorZykov/molecubes/hardware/battery/solidworks/SnapShellBattery.SLDPRT

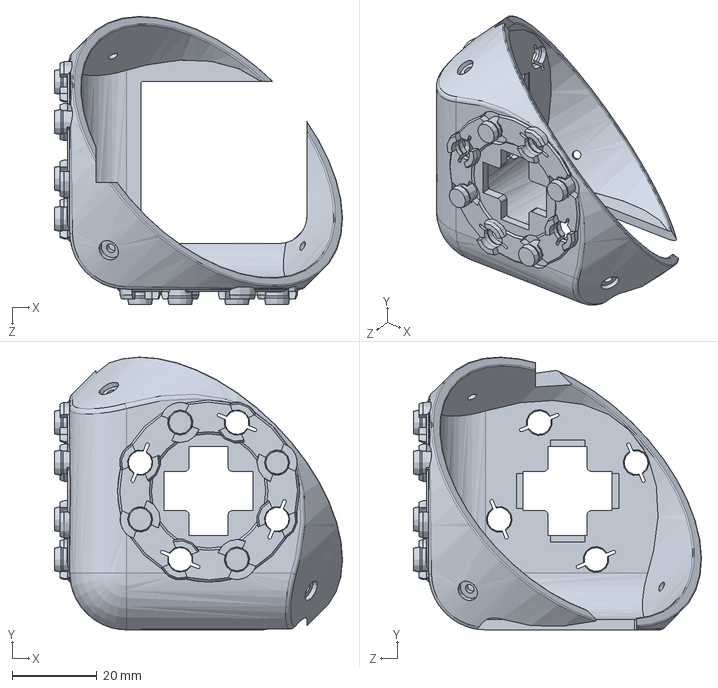
[picture p50: CAD file, 2019-09-05]
hardware/battery/solidworks/SnapShellBattery.SLDPRT
68.0 x 64.4 x 68.0 mm
