VictorZykov/molecubes/hardware/controller/solidworks/ARMHousing.SLDPRT

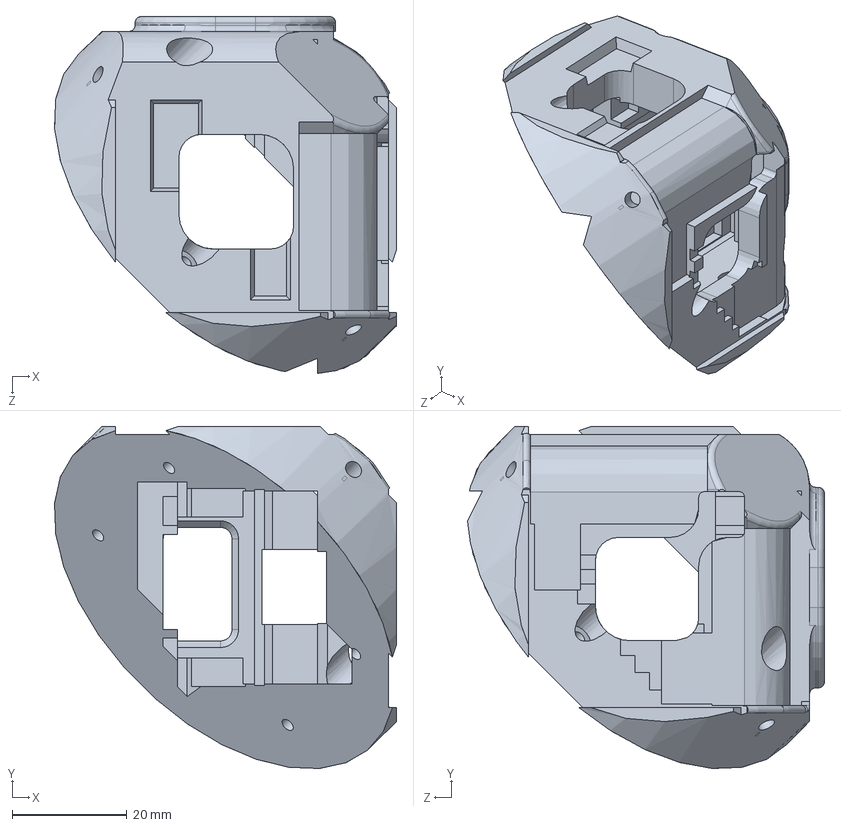
[picture p51: CAD file, 2019-09-05]
hardware/controller/solidworks/ARMHousing.SLDPRT
59.7 x 59.7 x 62.3 mm
