VictorZykov/molecubes/hardware/gripper/solidworks/PCB_M.SLDPRT

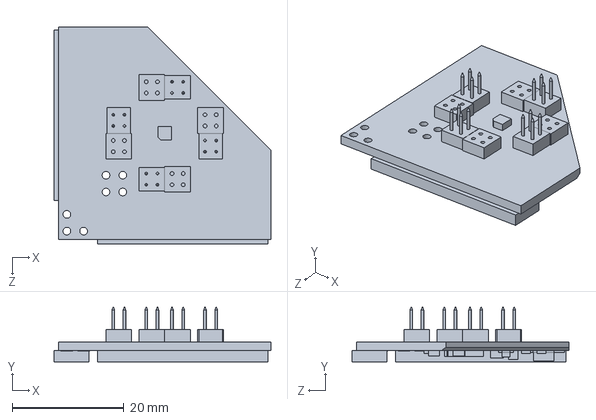
[picture p52: CAD file, 2019-09-05]
hardware/gripper/solidworks/PCB_M.SLDPRT
38.8 x 9.80 x 38.8 mm
