VictorZykov/molecubes/software/CubeInterface/3DModels/CubePinsCollision.STL

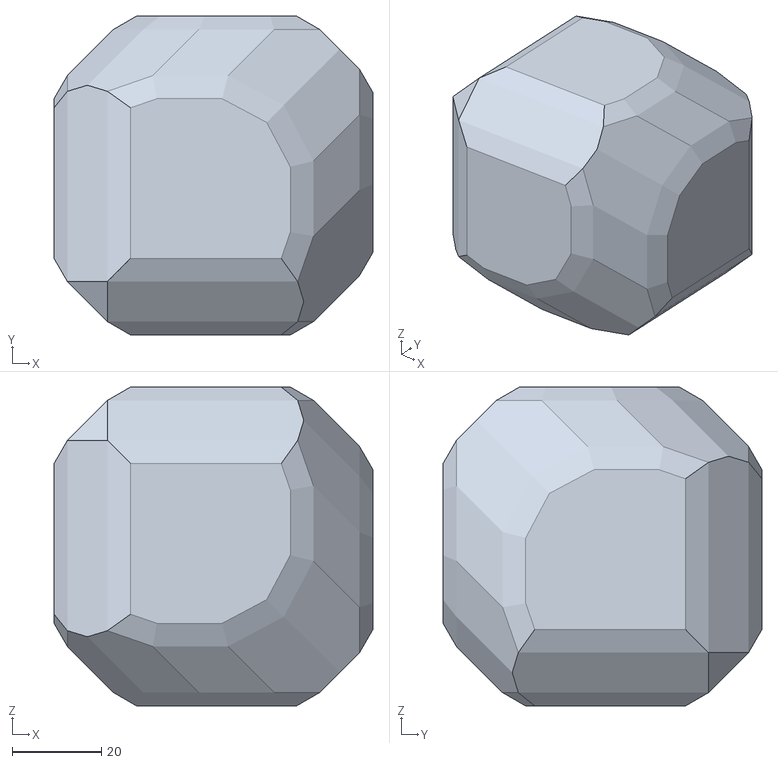
[picture p53: CAD file, 2019-09-05]
software/CubeInterface/3DModels/CubePinsCollision.STL
71.6 x 71.6 x 71.6
