VictorZykov/molecubes/hardware/battery/solidworks/BatteryEnclosure.SLDPRT

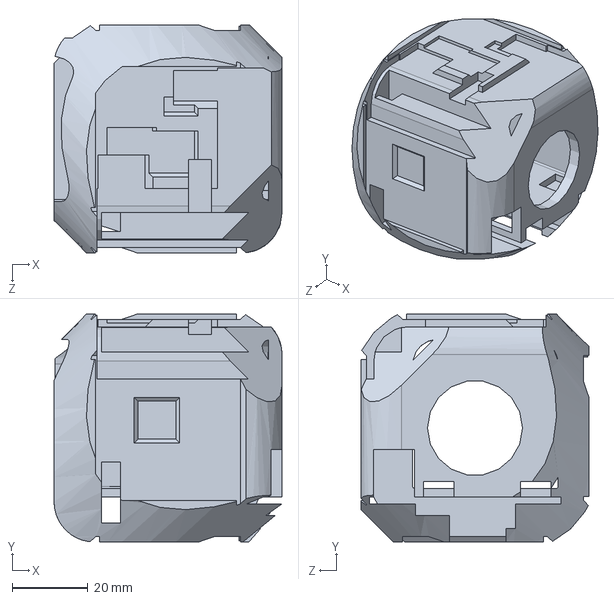
[picture p54: CAD file, 2019-09-05]
hardware/battery/solidworks/BatteryEnclosure.SLDPRT
60.0 x 60.0 x 60.0 mm
