VictorZykov/molecubes/hardware/gripper/solidworks/AxleSnapShell.SLDPRT

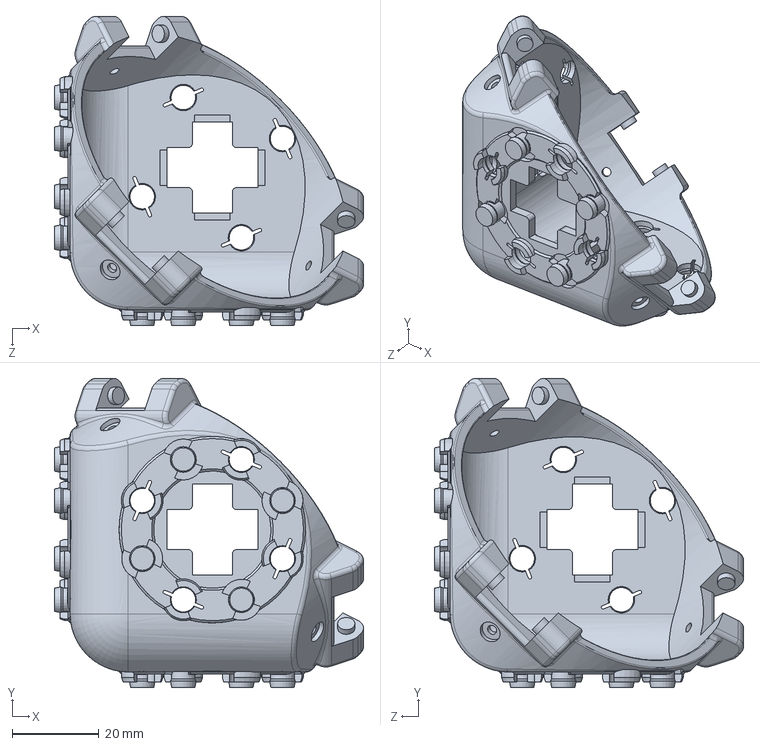
[picture p55: CAD file, 2019-09-05]
hardware/gripper/solidworks/AxleSnapShell.SLDPRT
71.2 x 71.2 x 71.2 mm
