VictorZykov/molecubes/software/CubeInterface/3DModels/TwoHalvesCollision.STL

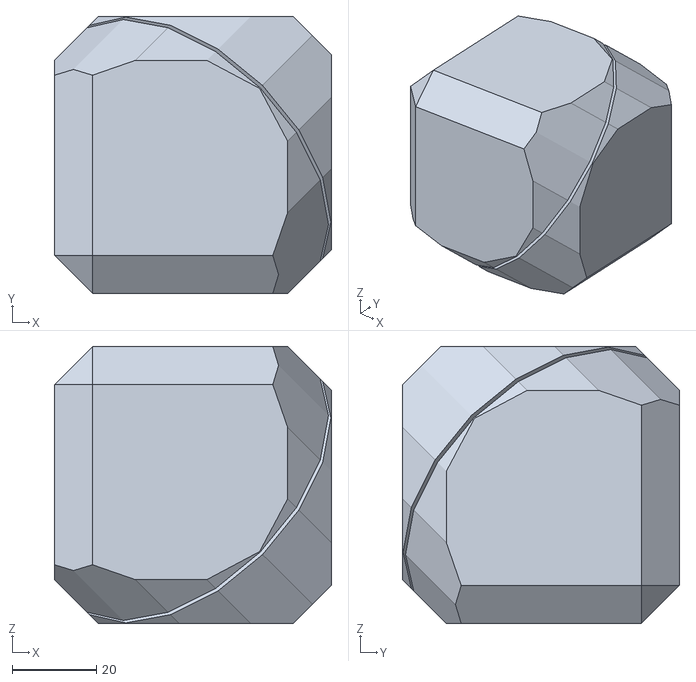
[picture p56: CAD file, 2019-09-05]
software/CubeInterface/3DModels/TwoHalvesCollision.STL
65.6 x 65.6 x 65.6
