VictorZykov/molecubes/hardware/battery/solidworks/BatteryPCB.SLDPRT

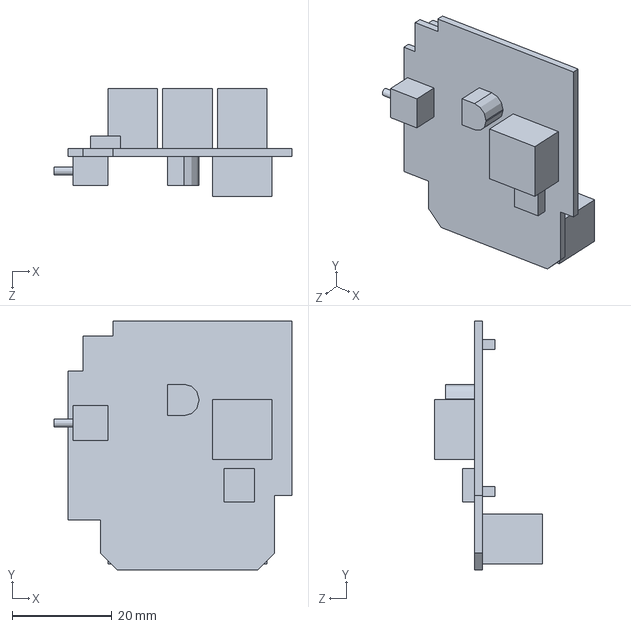
[picture p57: CAD file, 2019-09-05]
hardware/battery/solidworks/BatteryPCB.SLDPRT
47.8 x 50.0 x 21.6 mm
