VictorZykov/molecubes/hardware/gripper/solidworks/GripperDriver.SLDPRT

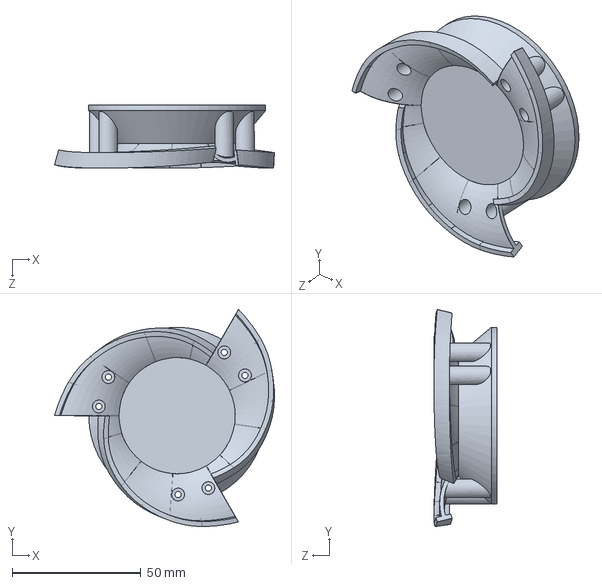
[picture p58: CAD file, 2019-09-05]
hardware/gripper/solidworks/GripperDriver.SLDPRT
85.3 x 84.2 x 24.5 mm
