VictorZykov/molecubes/hardware/passive/SocketCap.SLDPRT

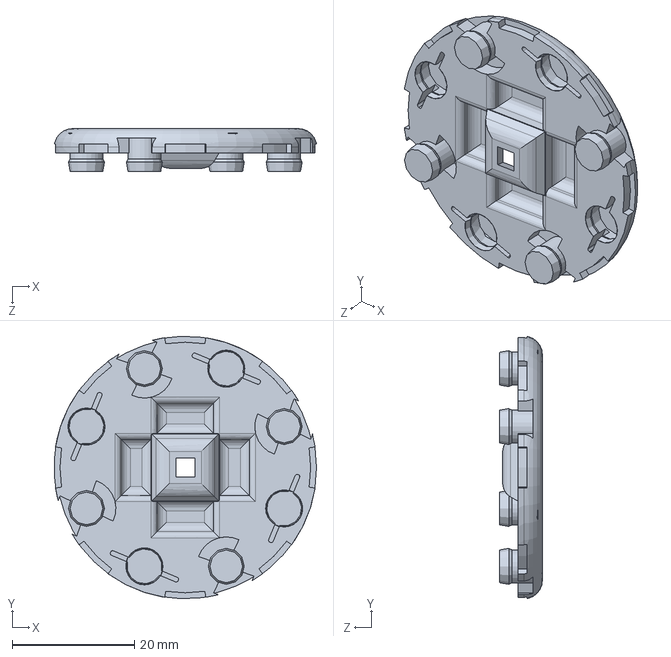
[picture p59: CAD file, 2019-09-05]
hardware/passive/SocketCap.SLDPRT
42.9 x 42.9 x 7.00 mm
