VictorZykov/molecubes/hardware/controller/solidworks/SnapShellController.SLDPRT

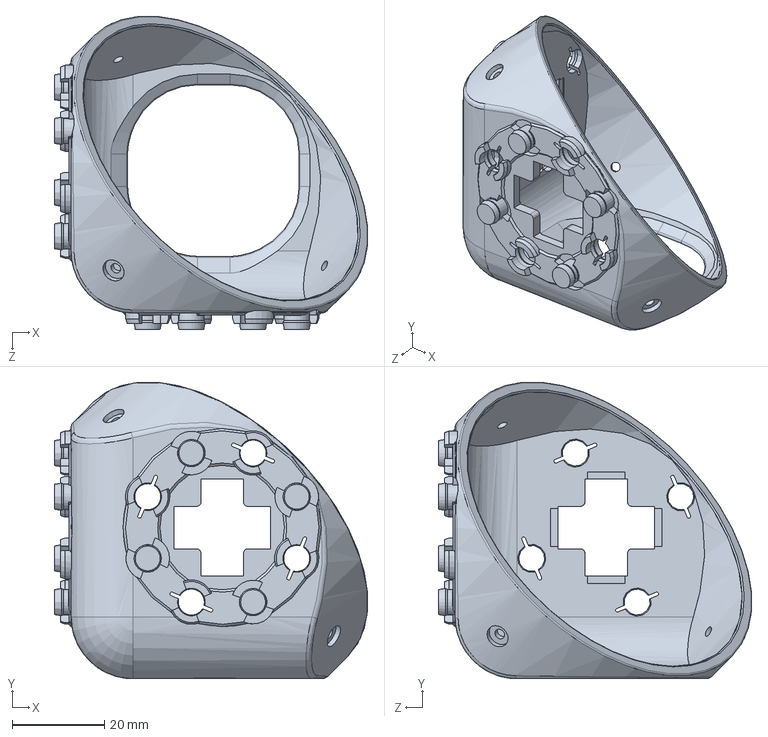
[picture p60: CAD file, 2019-09-05]
hardware/controller/solidworks/SnapShellController.SLDPRT
67.9 x 64.3 x 67.9 mm
