VictorZykov/molecubes/hardware/gripper/solidworks/AX12_Top.SLDPRT

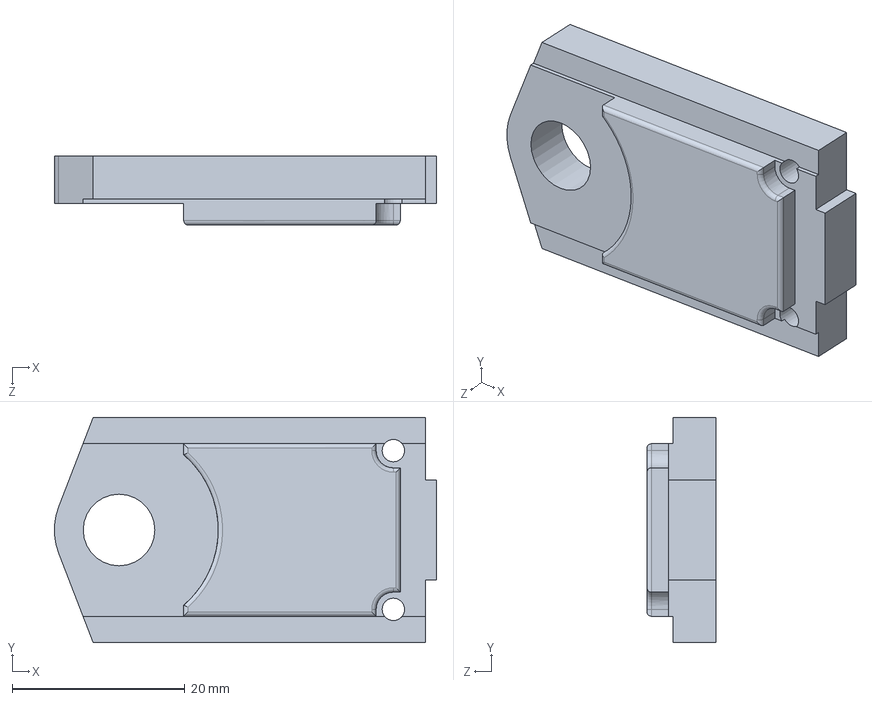
[picture p61: CAD file, 2019-09-05]
hardware/gripper/solidworks/AX12_Top.SLDPRT
44.3 x 26.1 x 8.00 mm
