VictorZykov/molecubes/hardware/passive/DummyFiller.SLDPRT

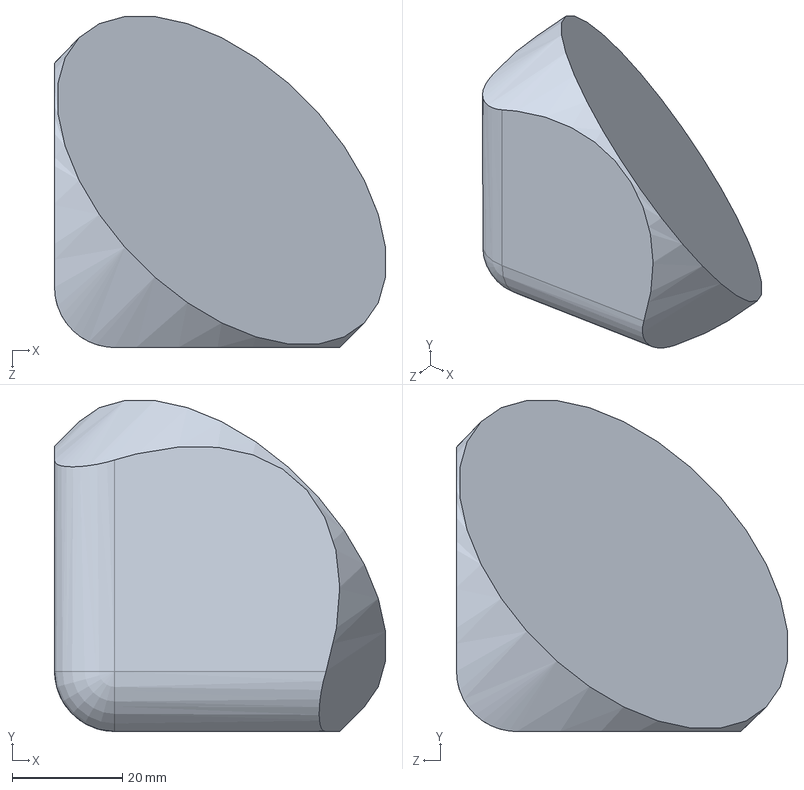
[picture p62: CAD file, 2019-09-05]
hardware/passive/DummyFiller.SLDPRT
60.0 x 60.0 x 60.0 mm
