VictorZykov/molecubes/hardware/wheel/Tyre.SLDPRT

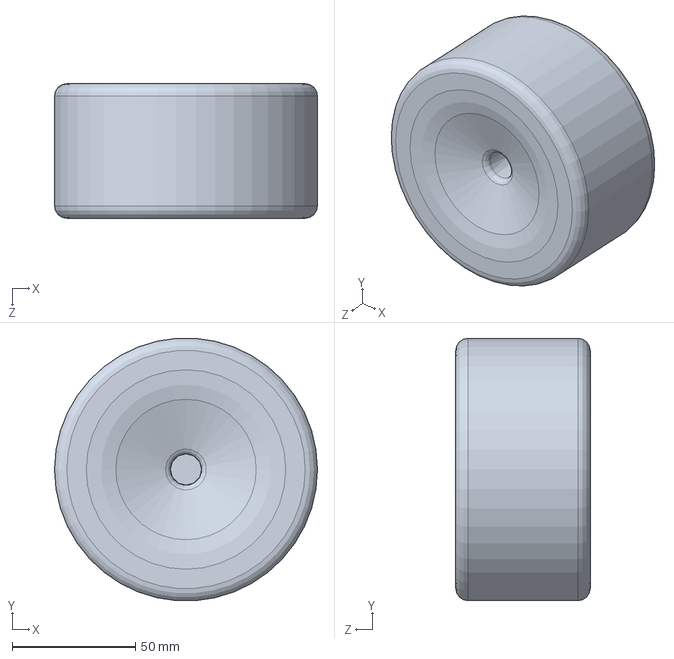
[picture p63: CAD file, 2019-09-05]
hardware/wheel/Tyre.SLDPRT
106.7 x 106.4 x 54.6 mm
