VictorZykov/molecubes/software/CubeInterface/3DModels/Battery.STL

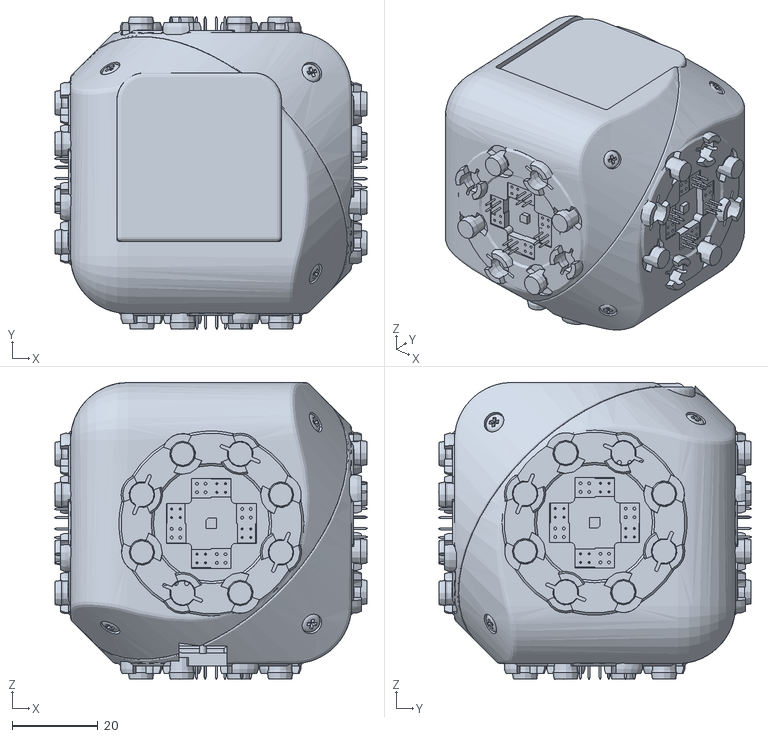
[picture p64: CAD file, 2019-09-05]
software/CubeInterface/3DModels/Battery.STL
72.8 x 72.8 x 69.1
