VictorZykov/molecubes/hardware/passive/HingePin.SLDPRT

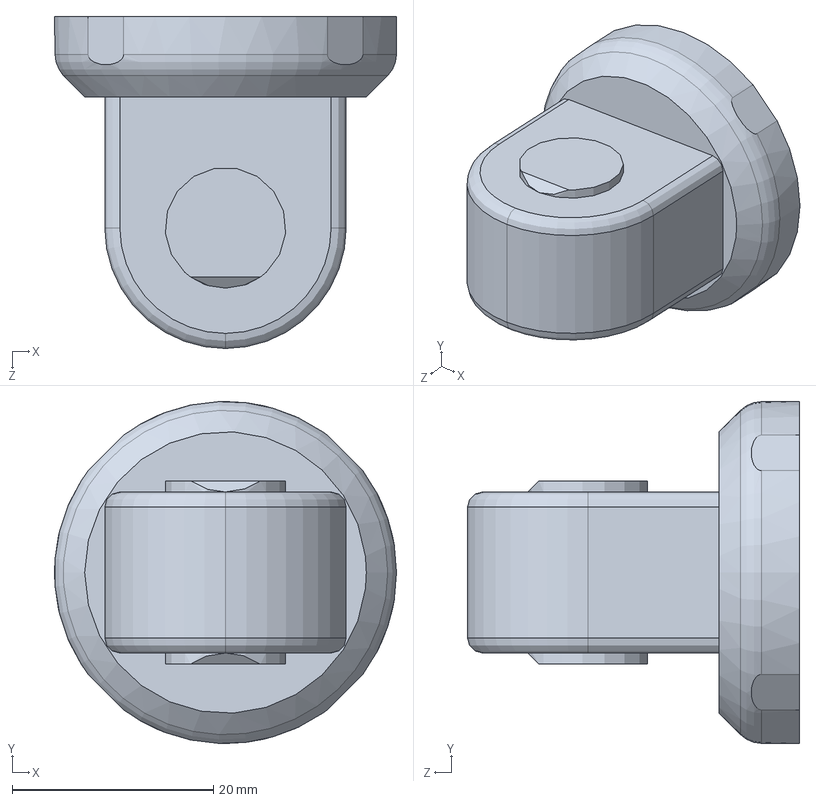
[picture p65: CAD file, 2019-09-05]
hardware/passive/HingePin.SLDPRT
34.0 x 34.0 x 33.0 mm
