VictorZykov/molecubes/software/CubeInterface/3DModels/SimpleShell.STL

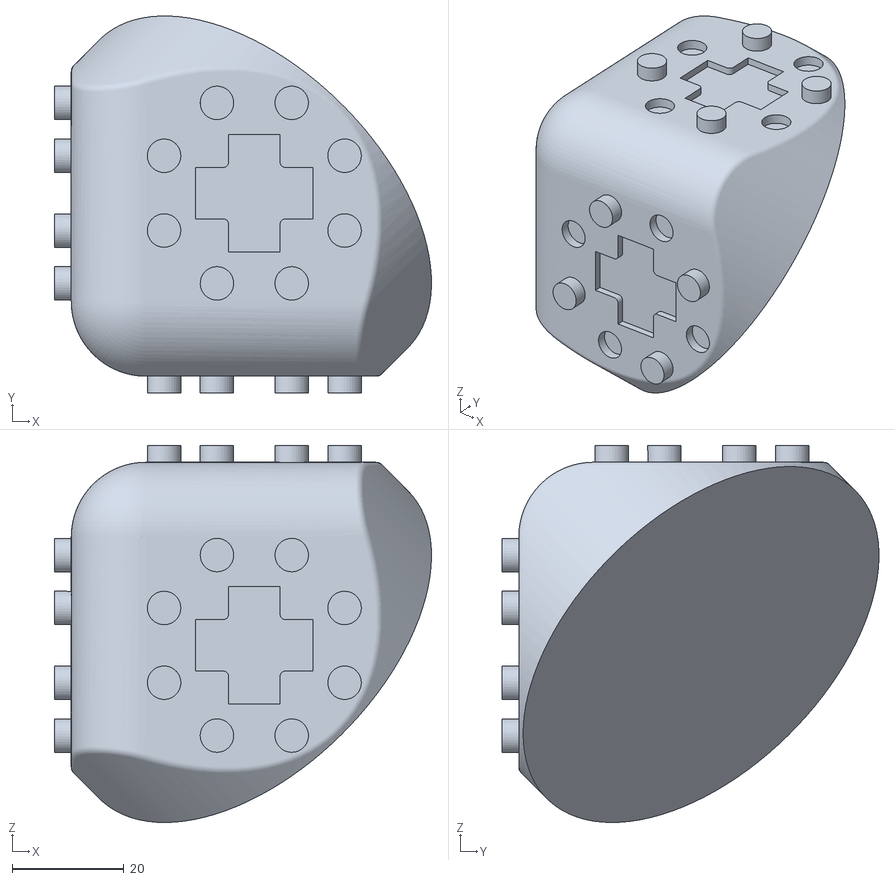
[picture p66: CAD file, 2019-09-05]
software/CubeInterface/3DModels/SimpleShell.STL
67.5 x 67.5 x 67.5
