VictorZykov/molecubes/hardware/actuator/solidworks/Pinion.SLDPRT

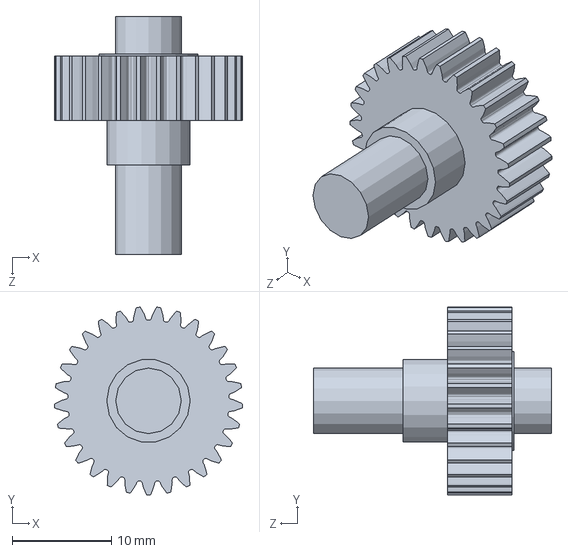
[picture p67: CAD file, 2019-09-05]
hardware/actuator/solidworks/Pinion.SLDPRT
18.9 x 18.9 x 24.0 mm
