VictorZykov/molecubes/hardware/passive/PassiveHinge.SLDPRT

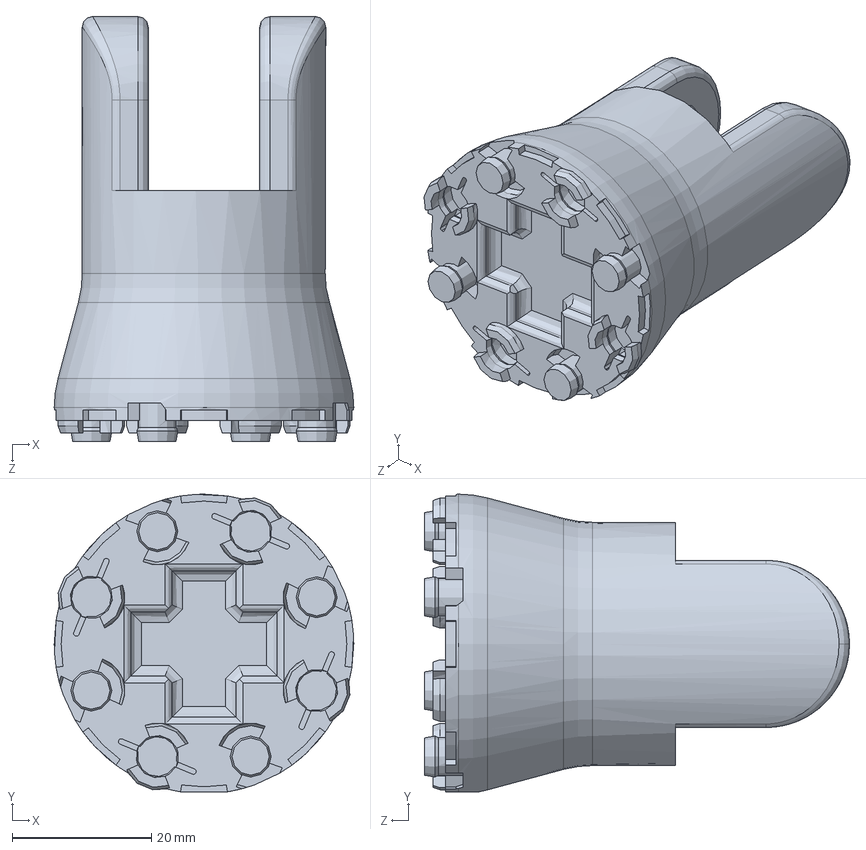
[picture p68: CAD file, 2019-09-05]
hardware/passive/PassiveHinge.SLDPRT
43.0 x 42.7 x 61.0 mm
