VictorZykov/molecubes/hardware/passive/CameraHolder.SLDPRT

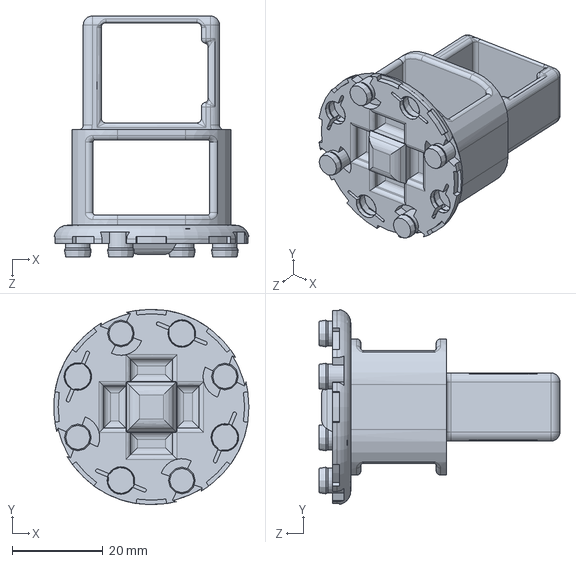
[picture p69: CAD file, 2019-09-05]
hardware/passive/CameraHolder.SLDPRT
42.9 x 42.9 x 53.0 mm
