VictorZykov/molecubes/hardware/wheel/Pinion.SLDPRT

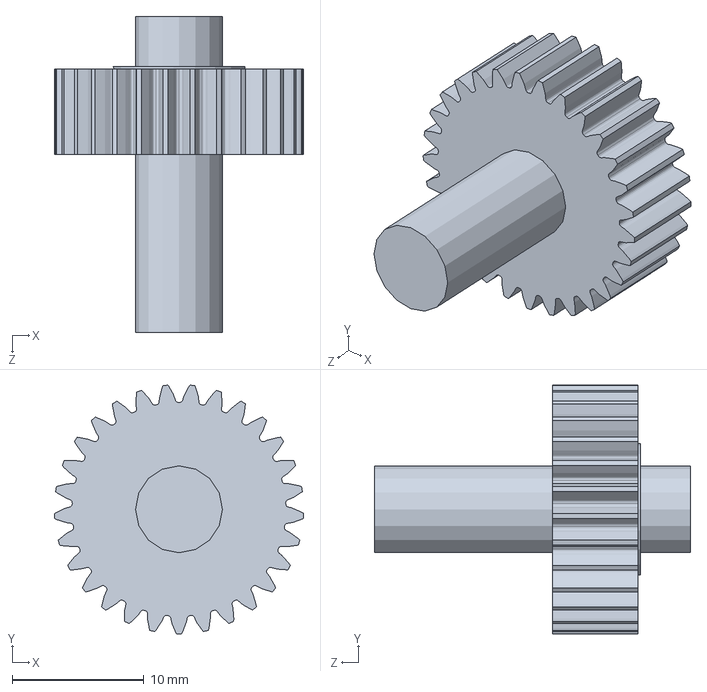
[picture p70: CAD file, 2019-09-05]
hardware/wheel/Pinion.SLDPRT
18.9 x 18.9 x 24.0 mm
