VictorZykov/molecubes/software/CubeInterface/3DModels/SimpleCube.STL

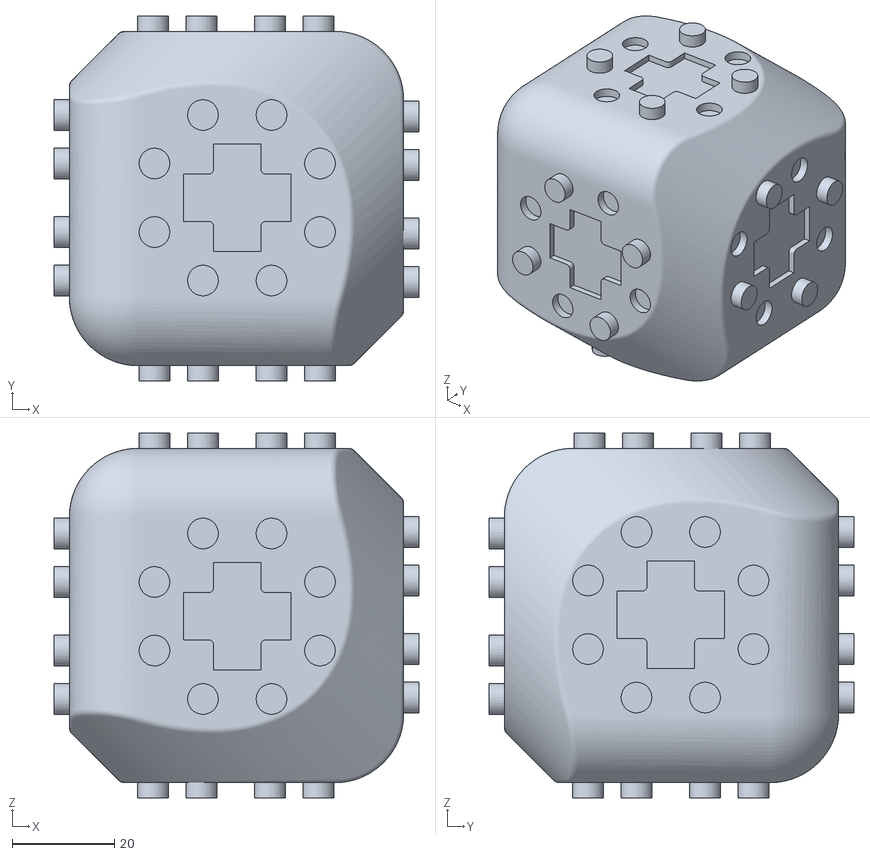
[picture p71: CAD file, 2019-09-05]
software/CubeInterface/3DModels/SimpleCube.STL
71.3 x 71.3 x 71.3
