VictorZykov/molecubes/hardware/actuator/solidworks/TopCasing.SLDPRT

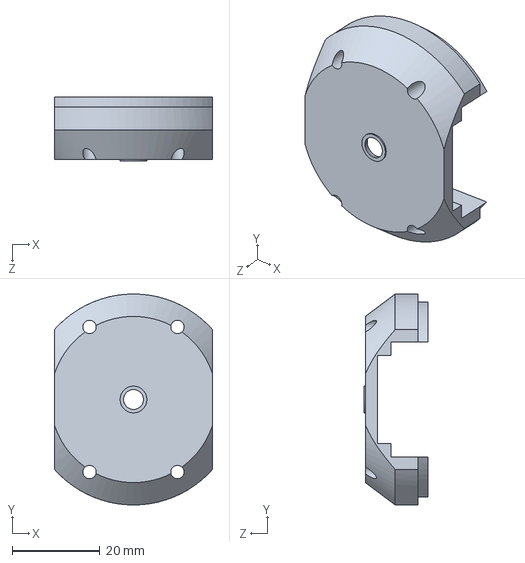
[picture p72: CAD file, 2019-09-05]
hardware/actuator/solidworks/TopCasing.SLDPRT
36.0 x 48.0 x 14.6 mm
