VictorZykov/molecubes/hardware/controller/solidworks/OlimexMSP430.SLDPRT

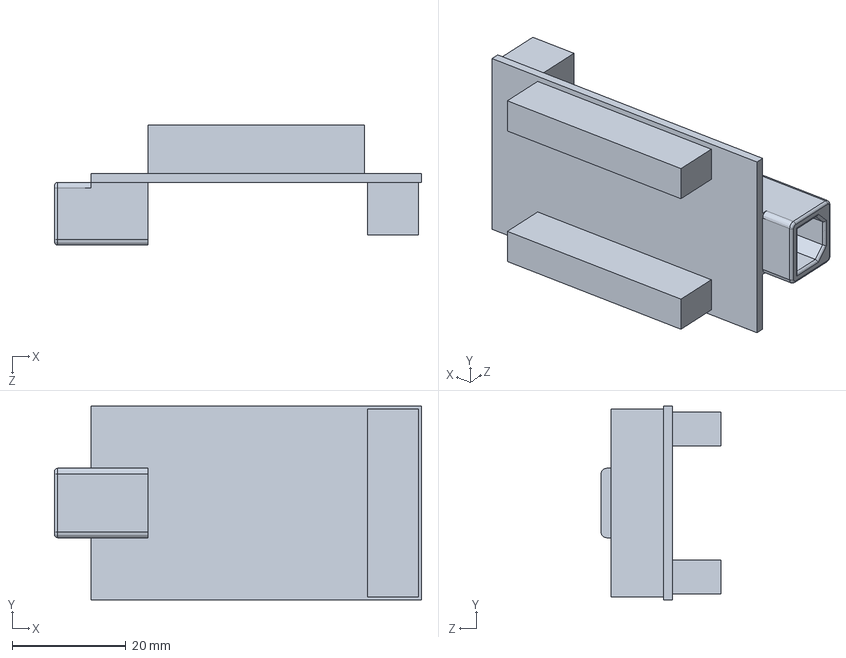
[picture p73: CAD file, 2019-09-05]
hardware/controller/solidworks/OlimexMSP430.SLDPRT
64.4 x 34.0 x 21.1 mm
