VictorZykov/molecubes/hardware/gripper/solidworks/MotorHolder.SLDPRT

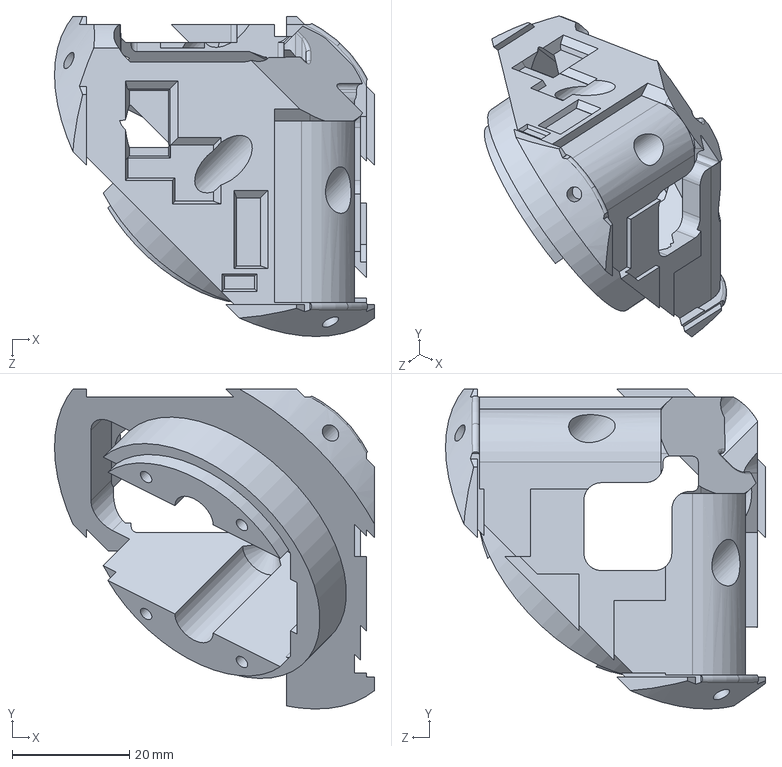
[picture p74: CAD file, 2019-09-05]
hardware/gripper/solidworks/MotorHolder.SLDPRT
54.5 x 54.5 x 54.5 mm
