VictorZykov/molecubes/software/CubeInterface/3DModels/Base.STL

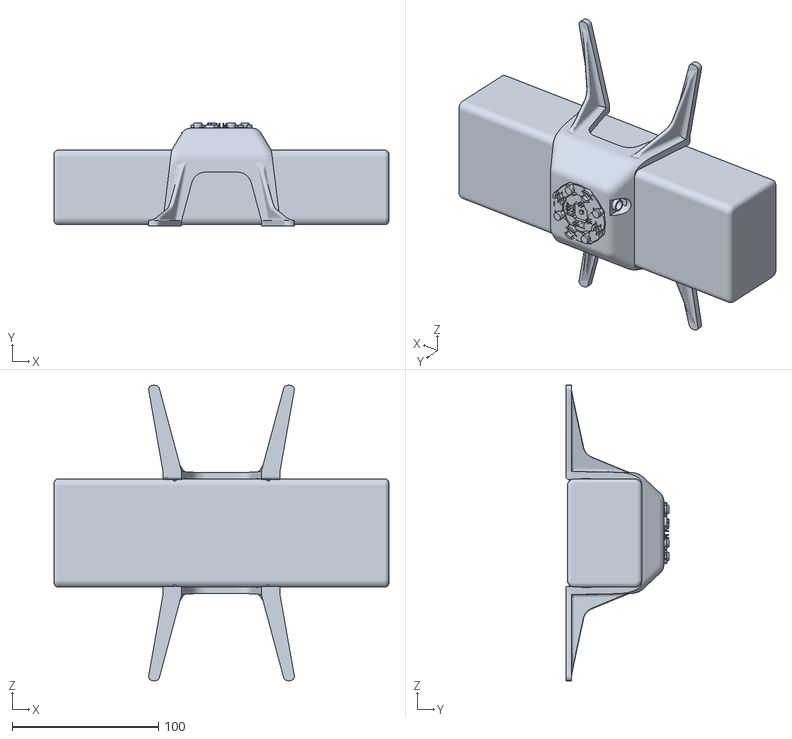
[picture p75: CAD file, 2019-09-05]
software/CubeInterface/3DModels/Base.STL
229.0 x 70.7 x 202.0
