VictorZykov/molecubes/hardware/wheel/WheelAxle.SLDPRT

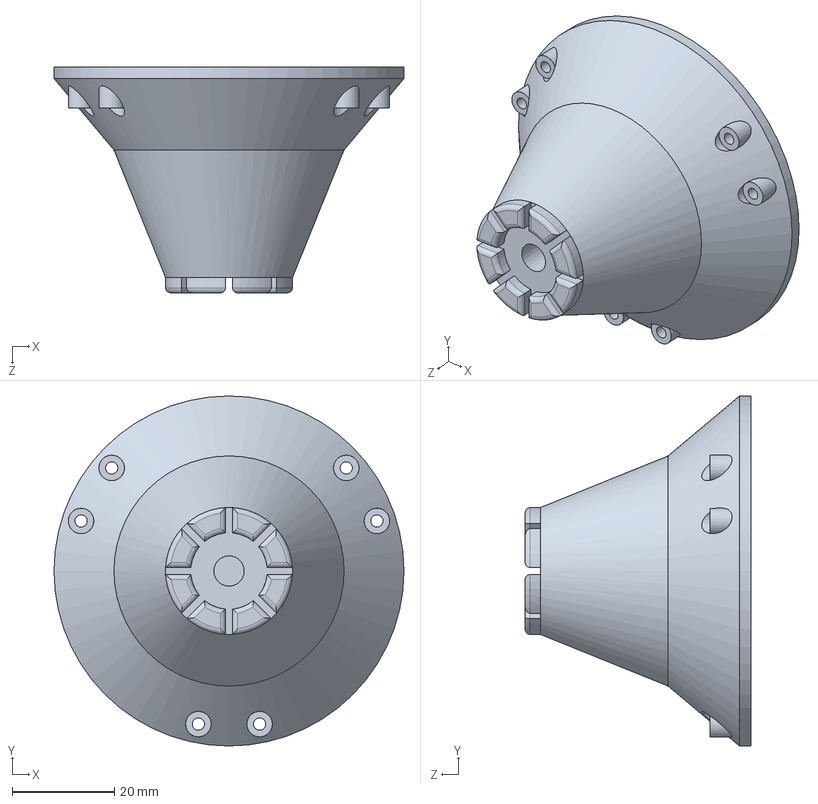
[picture p76: CAD file, 2019-09-05]
hardware/wheel/WheelAxle.SLDPRT
68.6 x 68.6 x 44.3 mm
