VictorZykov/molecubes/hardware/actuator/solidworks/GearHolder.SLDPRT

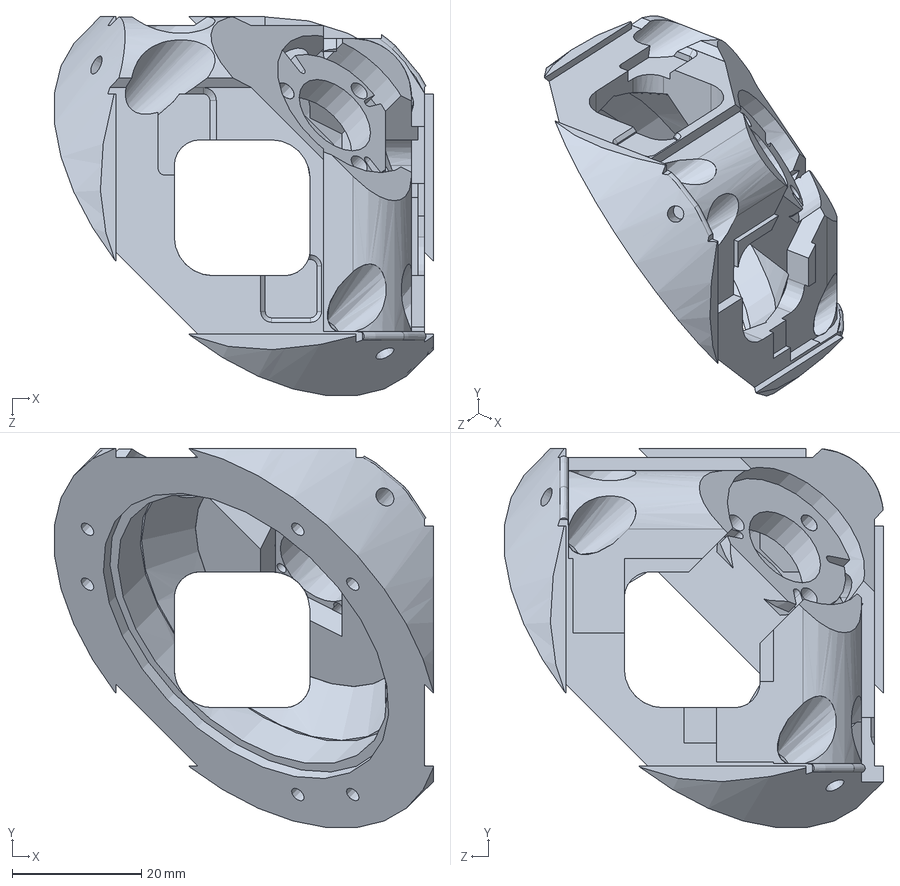
[picture p77: CAD file, 2019-09-05]
hardware/actuator/solidworks/GearHolder.SLDPRT
58.6 x 58.6 x 58.6 mm
