VictorZykov/molecubes/(list of files, cad)

Other CAD files:
hardware/wheel/PCB_R_power.SLDPRT
hardware/wheel/SnapShell.SLDPRT
hardware/actuator/solidworks/ThinBearing.SLDPRT
hardware/passive/DummyShell.SLDPRT
hardware/wheel/ThinBearing.SLDPRT
hardware/controller/solidworks/PCB_R.SLDPRT
hardware/actuator/solidworks/AX12_body.SLDPRT
hardware/wheel/PCB_L.SLDPRT
software/CubeInterface/3DModels/SimpleCubeCollision.STL
hardware/actuator/solidworks/PCB_M.SLDPRT
hardware/battery/solidworks/PCB_M.SLDPRT
hardware/actuator/solidworks/PCB_R.SLDPRT
hardware/controller/solidworks/PCB_M.SLDPRT
hardware/wheel/PCB_M.SLDPRT
hardware/controller/solidworks/SnapShell.SLDPRT
hardware/wheel/MotorHolder.SLDPRT
hardware/gripper/solidworks/Pinion.SLDPRT
hardware/wheel/AX12_body.SLDPRT
hardware/actuator/solidworks/InternalGear.SLDPRT
hardware/controller/solidworks/ControllerFDM.STL
hardware/wheel/ShortTopCasing.SLDPRT
software/CubeInterface/3DModels/BaseCollision.STL
hardware/gripper/solidworks/PCB_R_power.SLDPRT
hardware/actuator/solidworks/AX12_Top.SLDPRT
hardware/gripper/solidworks/InternalGear.SLDPRT
hardware/wheel/AX12_Top.SLDPRT
hardware/actuator/solidworks/PCB_L.SLDPRT
hardware/gripper/solidworks/PCB_L.SLDPRT
hardware/actuator/solidworks/Bolt.SLDPRT
hardware/actuator/solidworks/GearHolder.STL
hardware/actuator/solidworks/InternalGear.STL
hardware/actuator/solidworks/MotorHolder.STL
hardware/actuator/solidworks/SnapShell.SLDPRT
hardware/actuator/solidworks/SnapShell.STL
hardware/actuator/solidworks/TopCasing.STL
hardware/controller/solidworks/Bolt.SLDPRT
hardware/gripper/solidworks/Bolt.SLDPRT
hardware/gripper/solidworks/GripperFDM.STL
hardware/passive/STL/CameraHolder.STL
hardware/passive/STL/Dummy.STL
hardware/passive/STL/PassiveFoot.STL
hardware/passive/STL/PassiveHinge.STL
hardware/passive/STL/PassiveRodSocket.STL
hardware/passive/STL/SocketCap.STL
hardware/wheel/Bolt.SLDPRT
