VictorZykov/molecubes/specs/BatteryTesting.xls

Sheet: 2.2 Ah #1 Test 1
Samsung SB-L220 7.4V 2200mAh (Li-ion)
R, Ohms | 18.2
V no load | 8.5
Time | Voltage | Current | Power | mAh
14:27:00 | 8.01 | 0.4401098901 | 3.52528022
14:27:00 | 7.99 | 0.439010989 | 3.507697802 | 0
14:28:00 | 7.95 | 0.4368131868 | 3.472664835 | 7.298534799
14:30:00 | 7.9 | 0.4340659341 | 3.429120879 | 14.51465201
14:40:00 | 7.84 | 0.4307692308 | 3.377230769 | 72.06959707
14:50:00 | 7.8 | 0.4285714286 | 3.342857143 | 71.61172161
14:54:00 | 7.75 | 0.4258241758 | 3.300137363 | 28.47985348
15:02:00 | 7.67 | 0.4214285714 | 3.232357143 | 56.48351648
15:11:00 | 7.63 | 0.4192307692 | 3.198730769 | 63.04945055
15:16:00 | 7.6 | 0.4175824176 | 3.173626374 | 34.86721612
15:31:00 | 7.59 | 0.417032967 | 3.16528022 | 104.3269231
15:42:00 | 7.69 | 0.4225274725 | 3.249236264 | 76.95970696
16:00:00 | 7.61 | 0.4181318681 | 3.181983516 | 126.0989011
16:06:00 | 7.58 | 0.4164835165 | 3.156945055 | 41.73076923
16:16:00 | 7.55 | 0.4148351648 | 3.132005495 | 69.27655678
16:19:00 | 7.54 | 0.4142857143 | 3.123714286 | 20.72802198
16:23:00 | 7.52 | 0.4131868132 | 3.107164835 | 27.58241758
16:33:00 | 7.5 | 0.4120879121 | 3.090659341 | 68.77289377
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
