VictorZykov/molecubes/software/actuator/basic_io/Debug/BuildLog.htm

Build Log

| | Build started: Project: AVRProject, Configuration: Debug|Win32

Command Lines

| | Creating temporary file "D:\DOCUME~1\VIKTOR~1\LOCALS~1\Temp\BAT0000813403052.bat" with contents [ @echo off make clean && make if errorlevel 1 goto VCReportError goto VCEnd :VCReportError echo Project : error PRJ0019: A tool returned an error code from "Performing Makefile project actions" exit 1 :VCEnd ] Creating command line "D:\DOCUME~1\VIKTOR~1\LOCALS~1\Temp\BAT0000813403052.bat"

Output Window

Performing Makefile project actions
rm -f molecubePacket.o main.o D:\WinAVR\avrlib/buffer.o D:\WinAVR\avrlib/uart2.o D:\WinAVR\avrlib/timer.o D:\WinAVR\avrlib/i2c.o D:\WinAVR\avrlib/a2d.o
rm -f molecubePacket.s main.s D:\WinAVR\avrlib/buffer.s D:\WinAVR\avrlib/uart2.s D:\WinAVR\avrlib/timer.s D:\WinAVR\avrlib/i2c.s D:\WinAVR\avrlib/a2d.s
rm -f molecubePacket.lst main.lst D:\WinAVR\avrlib/buffer.lst D:\WinAVR\avrlib/uart2.lst D:\WinAVR\avrlib/timer.lst D:\WinAVR\avrlib/i2c.lst D:\WinAVR\avrlib/a2d.lst
rm -f main.map
rm -f main.elf
rm -f main.cof
rm -f main.obj
rm -f main.a90
rm -f main.sym
rm -f main.eep
rm -f main.hex
rm -f main.bin
Errors: none
avr-gcc -c -g -Os -Wall -Wstrict-prototypes -ID:\WinAVR\avrlib -Wa,-ahlms=main.lst -mmcu=atmega324p -I. main.c -o main.o
avr-gcc -c -g -Os -Wall -Wstrict-prototypes -ID:\WinAVR\avrlib -Wa,-ahlms=molecubePacket.lst -mmcu=atmega324p -I. molecubePacket.c -o molecubePacket.o
avr-gcc -c -g -Os -Wall -Wstrict-prototypes -ID:\WinAVR\avrlib -Wa,-ahlms=D:\WinAVR\avrlib/buffer.lst -mmcu=atmega324p -I. D:\WinAVR\avrlib/buffer.c -o D:\WinAVR\avrlib/buffer.o
avr-gcc -c -g -Os -Wall -Wstrict-prototypes -ID:\WinAVR\avrlib -Wa,-ahlms=D:\WinAVR\avrlib/uart2.lst -mmcu=atmega324p -I. D:\WinAVR\avrlib/uart2.c -o D:\WinAVR\avrlib/uart2.o
avr-gcc -c -g -Os -Wall -Wstrict-prototypes -ID:\WinAVR\avrlib -Wa,-ahlms=D:\WinAVR\avrlib/timer.lst -mmcu=atmega324p -I. D:\WinAVR\avrlib/timer.c -o D:\WinAVR\avrlib/timer.o
avr-gcc -c -g -Os -Wall -Wstrict-prototypes -ID:\WinAVR\avrlib -Wa,-ahlms=D:\WinAVR\avrlib/i2c.lst -mmcu=atmega324p -I. D:\WinAVR\avrlib/i2c.c -o D:\WinAVR\avrlib/i2c.o
avr-gcc -c -g -Os -Wall -Wstrict-prototypes -ID:\WinAVR\avrlib -Wa,-ahlms=D:\WinAVR\avrlib/a2d.lst -mmcu=atmega324p -I. D:\WinAVR\avrlib/a2d.c -o D:\WinAVR\avrlib/a2d.o
avr-gcc molecubePacket.o main.o D:\WinAVR\avrlib/buffer.o D:\WinAVR\avrlib/uart2.o D:\WinAVR\avrlib/timer.o D:\WinAVR\avrlib/i2c.o D:\WinAVR\avrlib/a2d.o -Wl,-Map=main.map,--cref -lm -mmcu=atmega324p -o main.elf
avr-objcopy -O binary -R .eeprom main.elf main.bin
avr-objcopy -O ihex -R .eeprom main.elf main.hex
avr-size main.elf
text data bss dec hex filename
9256 0 866 10122 278a main.elf
Errors: none
rm D:\WinAVR\avrlib/a2d.o D:\WinAVR\avrlib/i2c.o D:\WinAVR\avrlib/uart2.o D:\WinAVR\avrlib/buffer.o D:\WinAVR\avrlib/timer.o molecubePacket.o

Results

| | Build log was saved at "file://e:\Work\MScubes\SourceForge\trunk\software\actuator\basic_io\Debug\BuildLog.htm" AVRProject - 0 error(s), 0 warning(s)
