VictorZykov/molecubes/software/controller/serialInterfaceTest/Debug/BuildLog.htm

Build Log

| | Build started: Project: Serial Interface Test, Configuration: Debug|Win32

Command Lines

| | Creating temporary file "C:\DOCUME~1\PHELPS~1\LOCALS~1\Temp\BAT00000411444004.bat" with contents [ @echo off make clean && make if errorlevel 1 goto VCReportError goto VCEnd :VCReportError echo Project : error PRJ0019: A tool returned an error code from "Performing Makefile project actions" exit 1 :VCEnd ] Creating command line "C:\DOCUME~1\PHELPS~1\LOCALS~1\Temp\BAT00000411444004.bat"

Output Window

Performing Makefile project actions
rm -f C:\WinARM\armlib/arch/lpc2000/boot/boot.o main_serial.o usb.o molecubePacket.o commands.o C:\WinARM\armlib/rprintf.o C:\WinARM\armlib/buffer.o C:\WinARM\armlib/arch/lpc2000/processor.o C:\WinARM\armlib/arch/lpc2000/timer.o C:\WinARM\armlib/arch/lpc2000/uartintr.o
rm -f main_serial.s usb.s molecubePacket.s commands.s C:\WinARM\armlib/rprintf.s C:\WinARM\armlib/buffer.s C:\WinARM\armlib/arch/lpc2000/processor.s C:\WinARM\armlib/arch/lpc2000/timer.s C:\WinARM\armlib/arch/lpc2000/uartintr.s
rm -f main_serial.lst usb.lst molecubePacket.lst commands.lst C:\WinARM\armlib/rprintf.lst C:\WinARM\armlib/buffer.lst C:\WinARM\armlib/arch/lpc2000/processor.lst C:\WinARM\armlib/arch/lpc2000/timer.lst C:\WinARM\armlib/arch/lpc2000/uartintr.lst
rm -f main_serial.map
rm -f main_serial.elf
rm -f main_serial.obj
rm -f main_serial.hex
rm -f main_serial.bin
rm -f main_serial.hex
Errors: none
arm-elf-gcc -c -I./ -I./inc -I./conf -g -O1 -Wall -Wstrict-prototypes -IC:\WinARM\armlib -IC:\WinARM\armlib/arch/lpc2000 -IC:\WinARM\armlib/arch/lpc2000/include -IC:\WinARM\bin/arm-elf/include -Wa,-ahlms=main_serial.lst -mcpu=arm7tdmi -I. main_serial.c -o main_serial.o
arm-elf-gcc -x assembler-with-cpp -c -Wa, -gstabs -mcpu=arm7tdmi -I. C:\WinARM\armlib/arch/lpc2000/boot/boot.s -o C:\WinARM\armlib/arch/lpc2000/boot/boot.o
arm-elf-gcc -c -I./ -I./inc -I./conf -g -O1 -Wall -Wstrict-prototypes -IC:\WinARM\armlib -IC:\WinARM\armlib/arch/lpc2000 -IC:\WinARM\armlib/arch/lpc2000/include -IC:\WinARM\bin/arm-elf/include -Wa,-ahlms=usb.lst -mcpu=arm7tdmi -I. usb.c -o usb.o
arm-elf-gcc -c -I./ -I./inc -I./conf -g -O1 -Wall -Wstrict-prototypes -IC:\WinARM\armlib -IC:\WinARM\armlib/arch/lpc2000 -IC:\WinARM\armlib/arch/lpc2000/include -IC:\WinARM\bin/arm-elf/include -Wa,-ahlms=molecubePacket.lst -mcpu=arm7tdmi -I. molecubePacket.c -o molecubePacket.o
arm-elf-gcc -c -I./ -I./inc -I./conf -g -O1 -Wall -Wstrict-prototypes -IC:\WinARM\armlib -IC:\WinARM\armlib/arch/lpc2000 -IC:\WinARM\armlib/arch/lpc2000/include -IC:\WinARM\bin/arm-elf/include -Wa,-ahlms=commands.lst -mcpu=arm7tdmi -I. commands.c -o commands.o
arm-elf-gcc -c -I./ -I./inc -I./conf -g -O1 -Wall -Wstrict-prototypes -IC:\WinARM\armlib -IC:\WinARM\armlib/arch/lpc2000 -IC:\WinARM\armlib/arch/lpc2000/include -IC:\WinARM\bin/arm-elf/include -Wa,-ahlms=C:\WinARM\armlib/rprintf.lst -mcpu=arm7tdmi -I. C:\WinARM\armlib/rprintf.c -o C:\WinARM\armlib/rprintf.o
arm-elf-gcc -c -I./ -I./inc -I./conf -g -O1 -Wall -Wstrict-prototypes -IC:\WinARM\armlib -IC:\WinARM\armlib/arch/lpc2000 -IC:\WinARM\armlib/arch/lpc2000/include -IC:\WinARM\bin/arm-elf/include -Wa,-ahlms=C:\WinARM\armlib/buffer.lst -mcpu=arm7tdmi -I. C:\WinARM\armlib/buffer.c -o C:\WinARM\armlib/buffer.o
arm-elf-gcc -c -I./ -I./inc -I./conf -g -O1 -Wall -Wstrict-prototypes -IC:\WinARM\armlib -IC:\WinARM\armlib/arch/lpc2000 -IC:\WinARM\armlib/arch/lpc2000/include -IC:\WinARM\bin/arm-elf/include -Wa,-ahlms=C:\WinARM\armlib/arch/lpc2000/processor.lst -mcpu=arm7tdmi -I. C:\WinARM\armlib/arch/lpc2000/processor.c -o C:\WinARM\armlib/arch/lpc2000/processor.o
arm-elf-gcc -c -I./ -I./inc -I./conf -g -O1 -Wall -Wstrict-prototypes -IC:\WinARM\armlib -IC:\WinARM\armlib/arch/lpc2000 -IC:\WinARM\armlib/arch/lpc2000/include -IC:\WinARM\bin/arm-elf/include -Wa,-ahlms=C:\WinARM\armlib/arch/lpc2000/timer.lst -mcpu=arm7tdmi -I. C:\WinARM\armlib/arch/lpc2000/timer.c -o C:\WinARM\armlib/arch/lpc2000/timer.o
arm-elf-gcc -c -I./ -I./inc -I./conf -g -O1 -Wall -Wstrict-prototypes -IC:\WinARM\armlib -IC:\WinARM\armlib/arch/lpc2000 -IC:\WinARM\armlib/arch/lpc2000/include -IC:\WinARM\bin/arm-elf/include -Wa,-ahlms=C:\WinARM\armlib/arch/lpc2000/uartintr.lst -mcpu=arm7tdmi -I. C:\WinARM\armlib/arch/lpc2000/uartintr.c -o C:\WinARM\armlib/arch/lpc2000/uartintr.o
arm-elf-gcc C:\WinARM\armlib/arch/lpc2000/boot/boot.o main_serial.o usb.o molecubePacket.o commands.o C:\WinARM\armlib/rprintf.o C:\WinARM\armlib/buffer.o C:\WinARM\armlib/arch/lpc2000/processor.o C:\WinARM\armlib/arch/lpc2000/timer.o C:\WinARM\armlib/arch/lpc2000/uartintr.o usbstack.a -TC:\WinARM\armlib/arch/lpc2000/boot/lpc2148-rom-iap.ld -lm -nostartfiles -Wl,-Map=main_serial.map,--cref,-nostdlib -o main_serial.elf
arm-elf-objcopy -O binary main_serial.elf main_serial.bin
arm-elf-objcopy -O ihex main_serial.elf main_serial.hex
arm-elf-size main_serial.elf
text data bss dec hex filename
14132 8 1140 15280 3bb0 main_serial.elf
Errors: none
rm C:\WinARM\armlib/arch/lpc2000/boot/boot.o C:\WinARM\armlib/buffer.o C:\WinARM\armlib/arch/lpc2000/uartintr.o C:\WinARM\armlib/rprintf.o usb.o commands.o C:\WinARM\armlib/arch/lpc2000/timer.o C:\WinARM\armlib/arch/lpc2000/processor.o molecubePacket.o

Results

| | Build log was saved at "file://c:\cornell\molecubes_sf\trunk\software\controller\serialInterfaceTest\Debug\BuildLog.htm" Serial Interface Test - 0 error(s), 0 warning(s)
