VictorZykov/molecubes/hardware/battery/Slider switch 53H6675.pdf

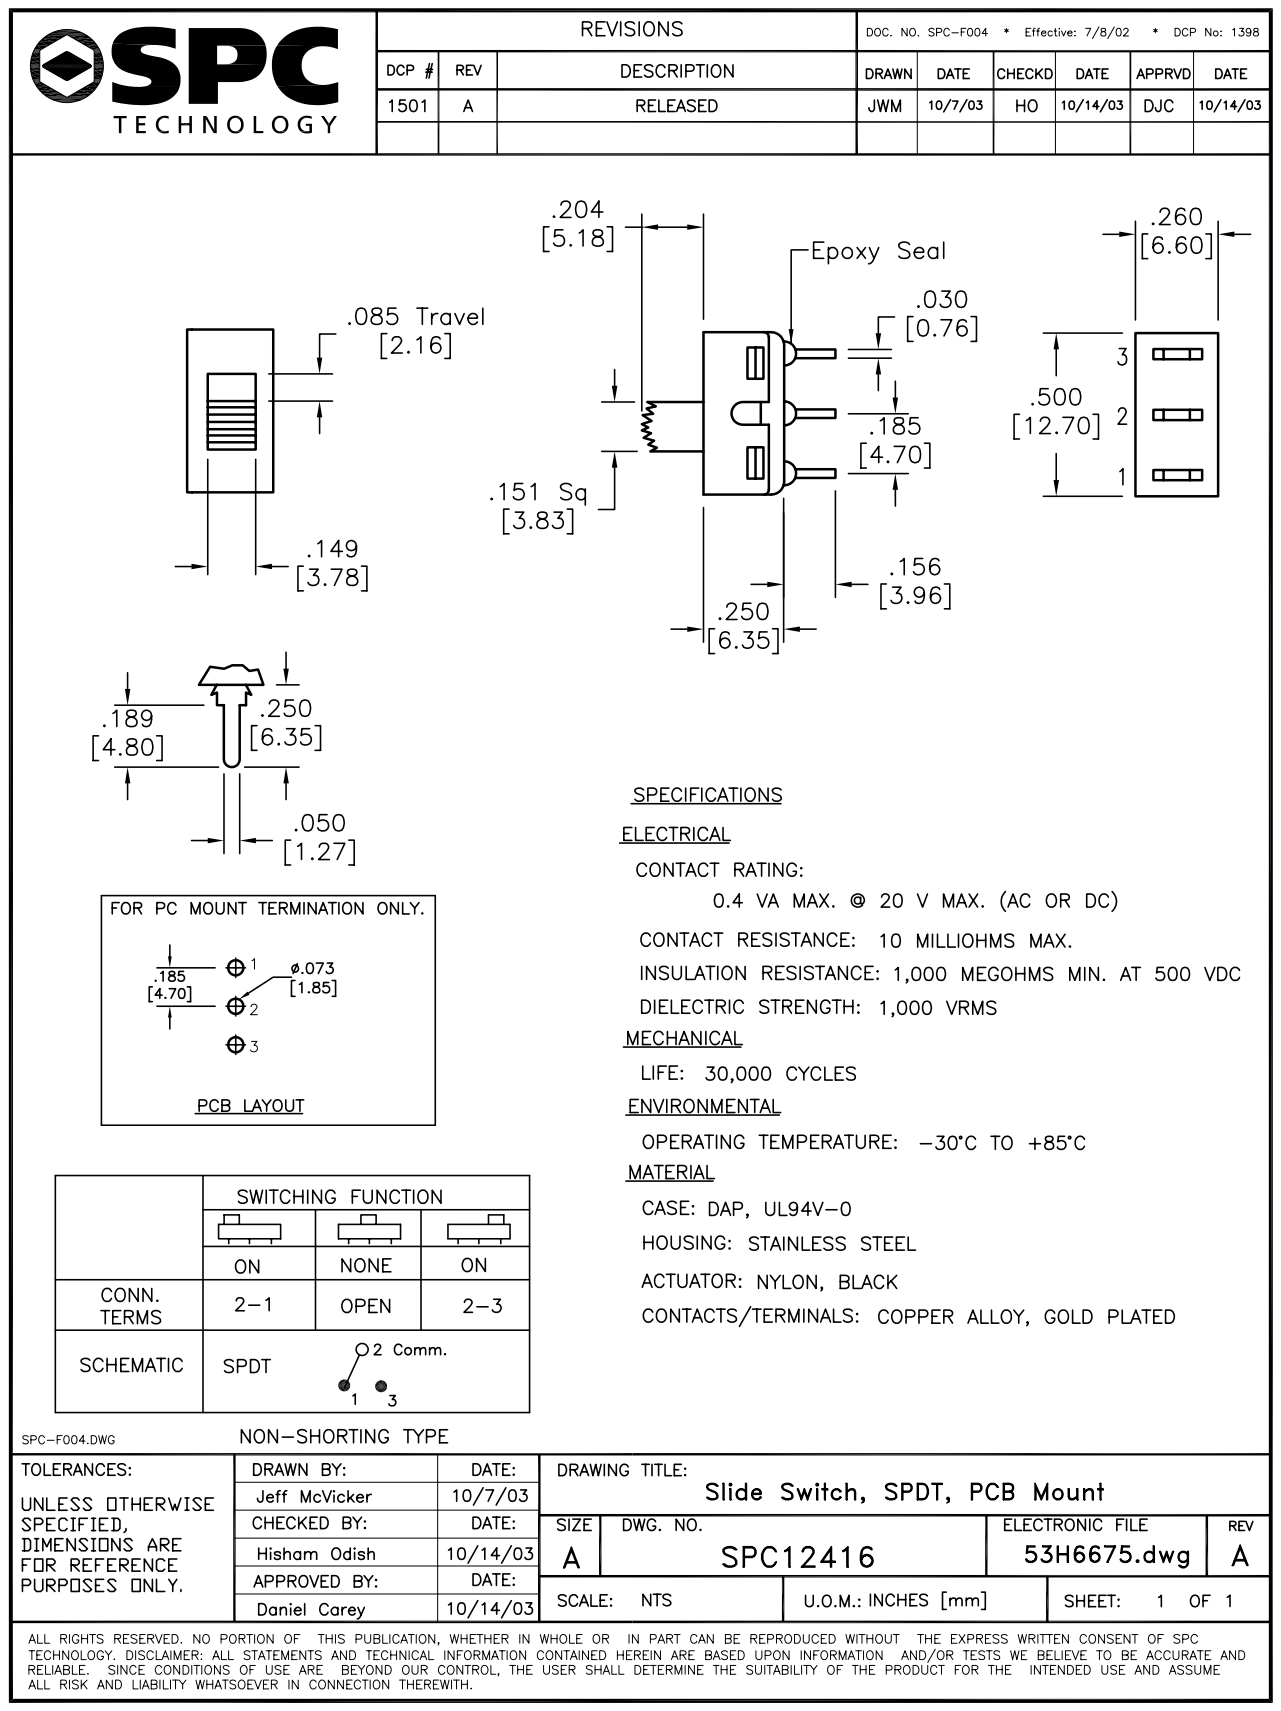
[picture p82: page 1]
