VictorZykov/molecubes/hardware/actuator/pcb/docs/541325097_sd.pdf

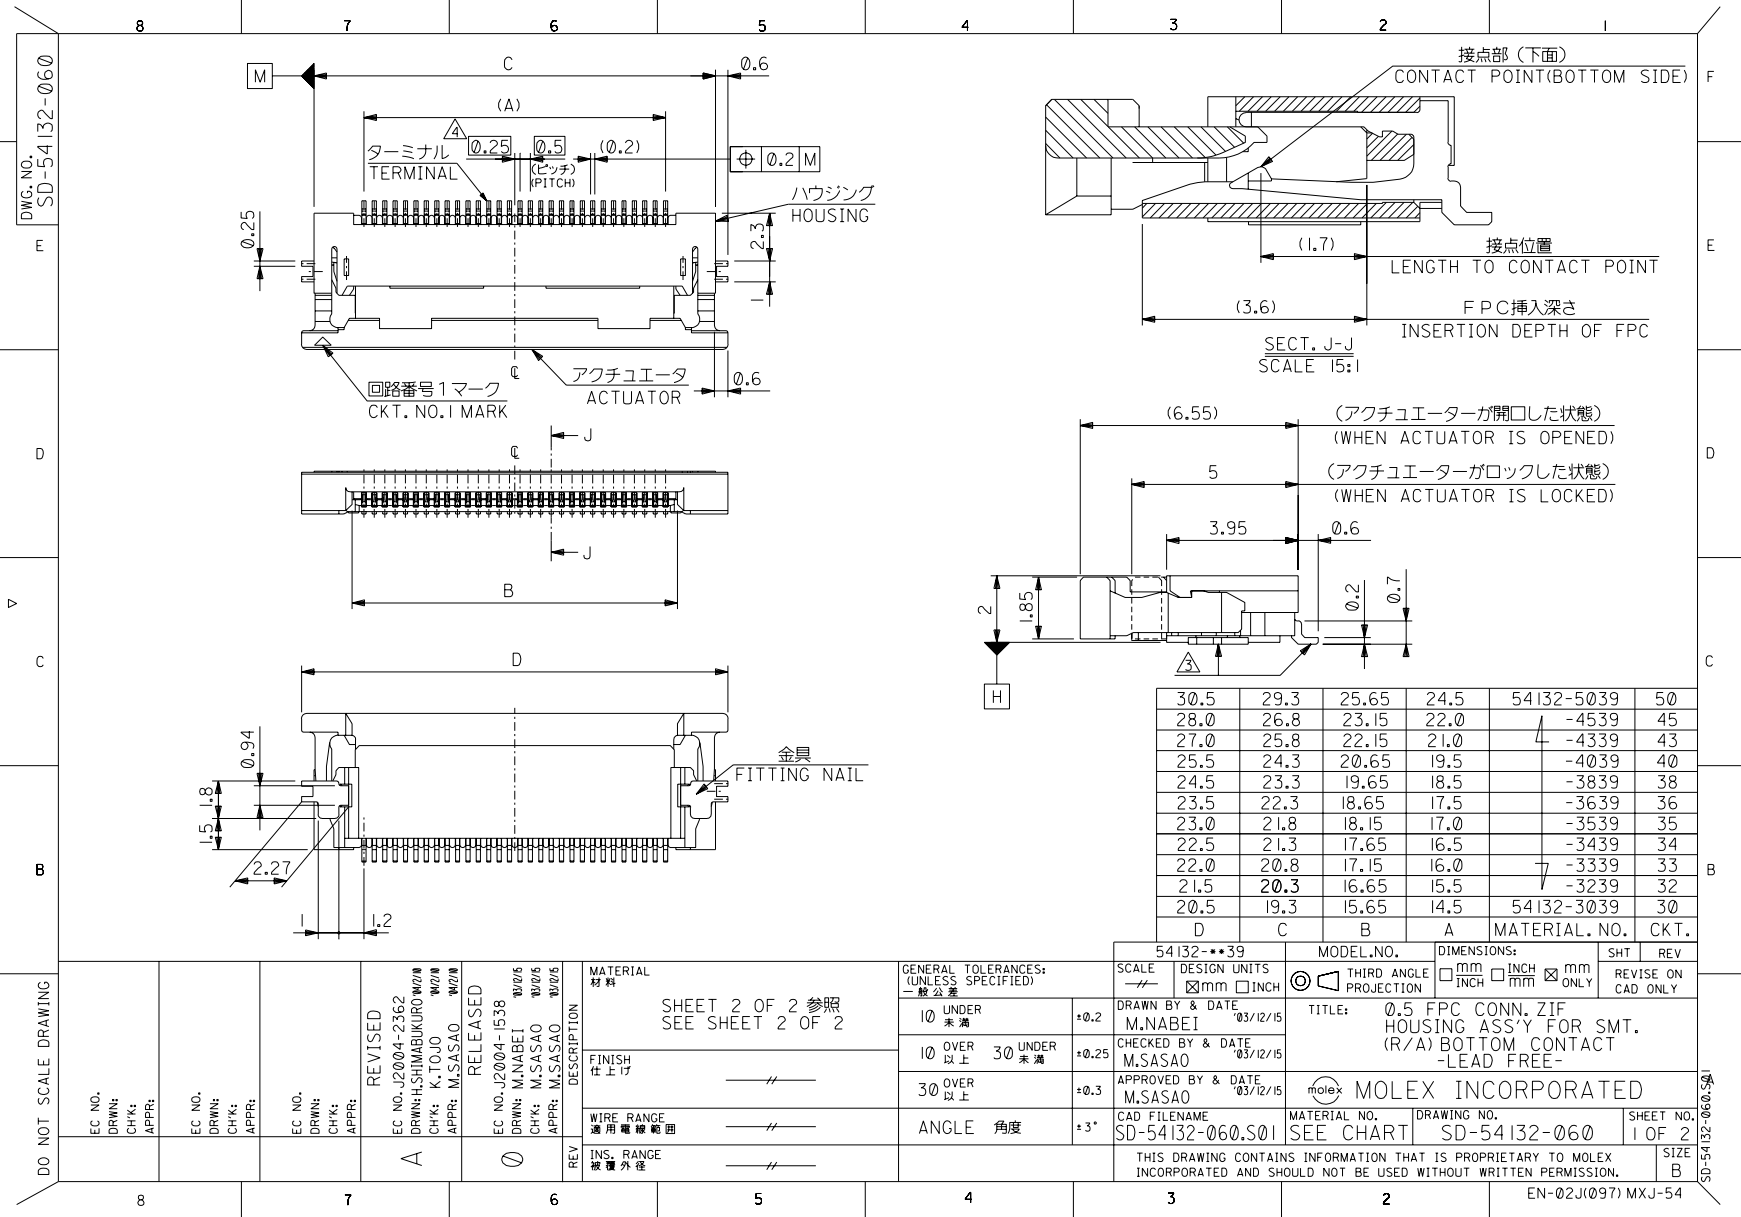
[picture p83: page 1]

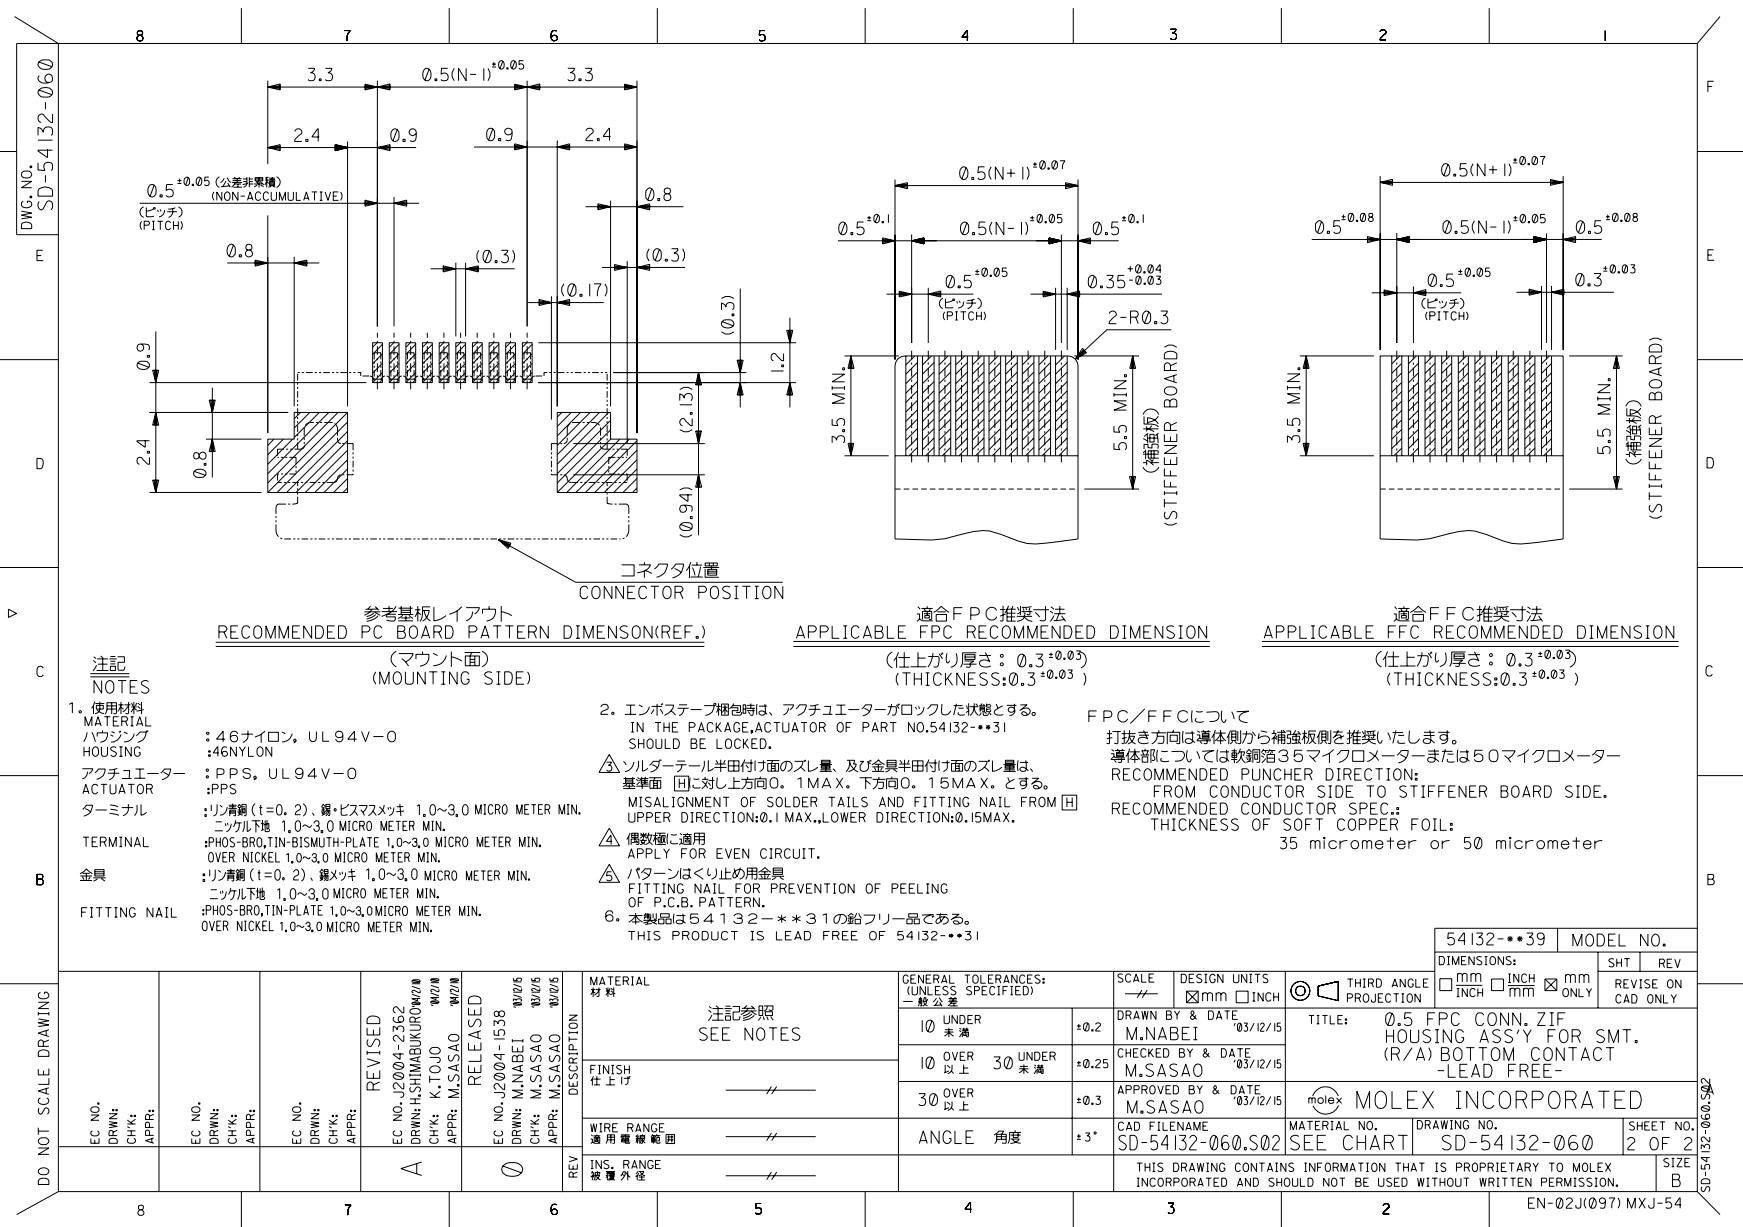
[picture p84: page 2]

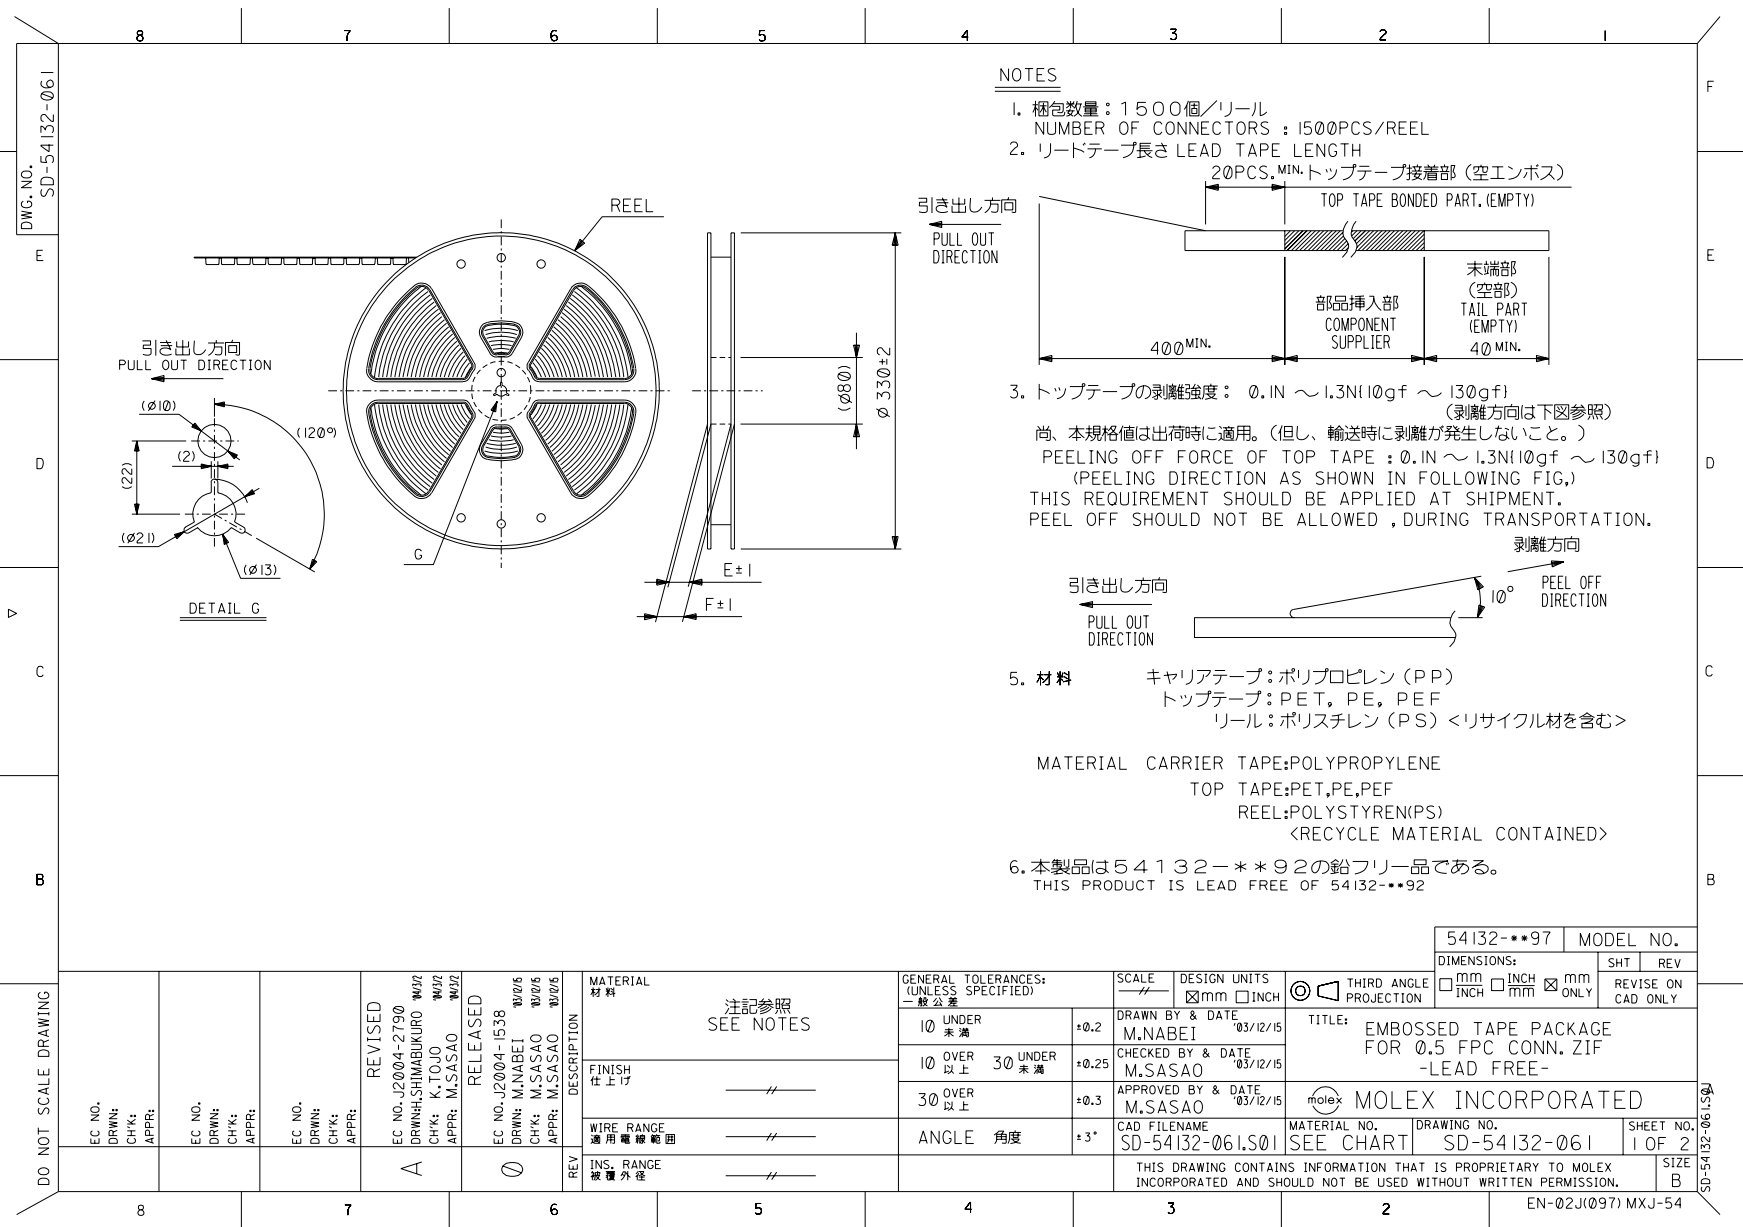
[picture p85: page 3]

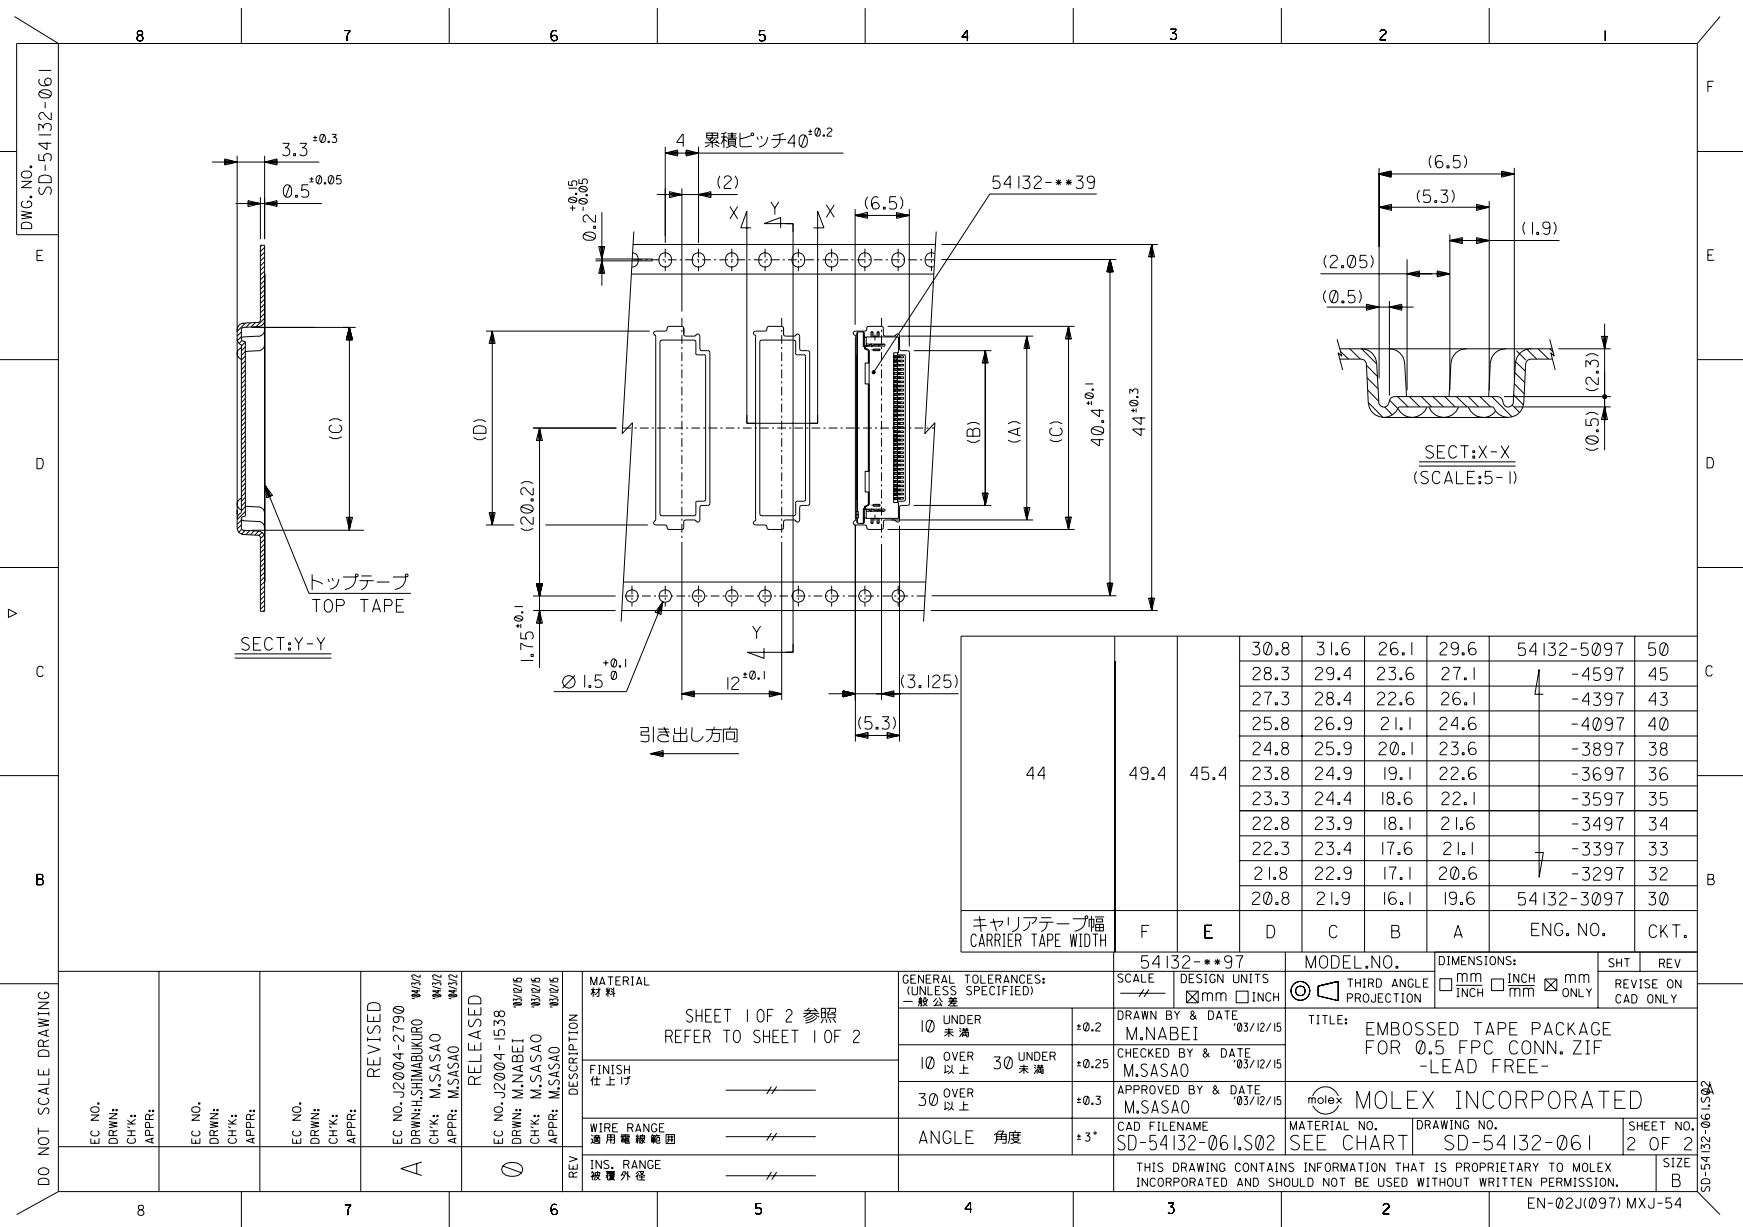
[picture p86: page 4]
