VictorZykov/molecubes/hardware/actuator/pcb/docs/873400424_sd.pdf

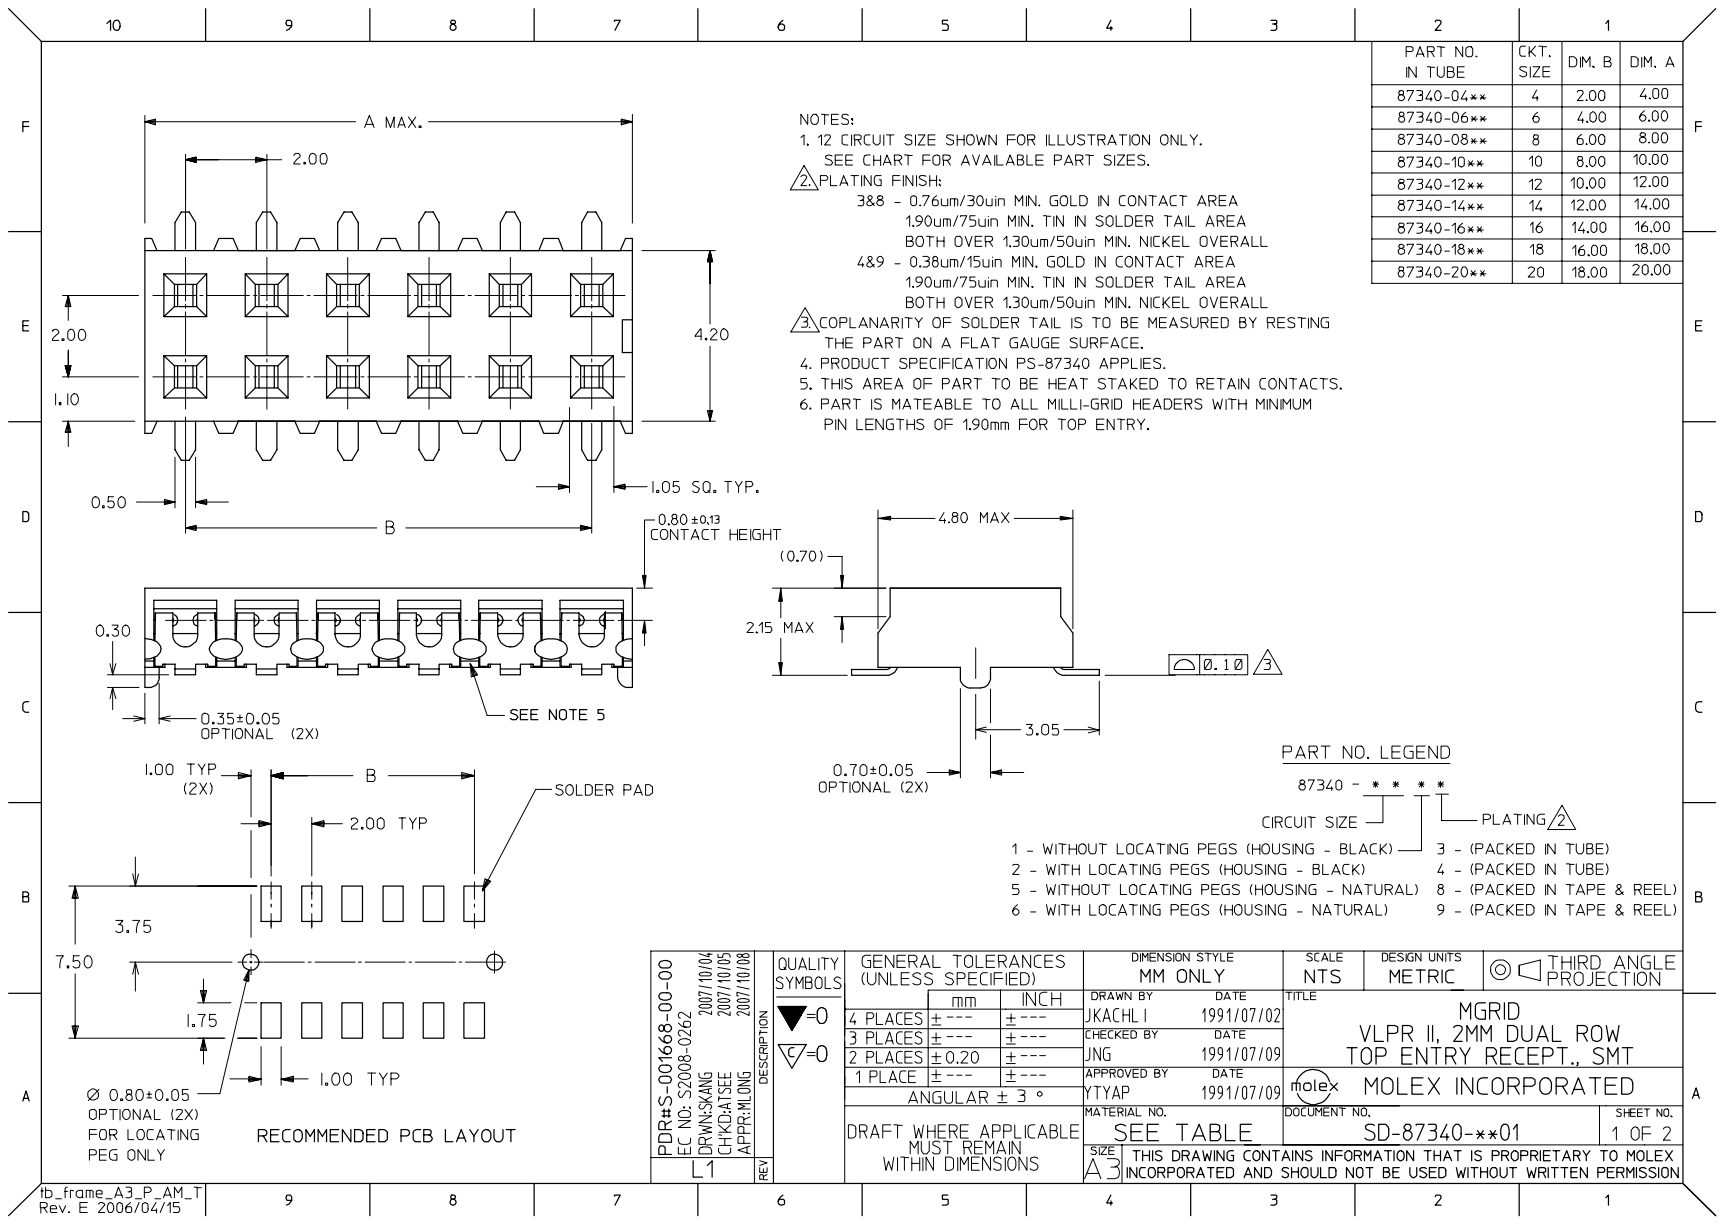
[picture p87: page 1]

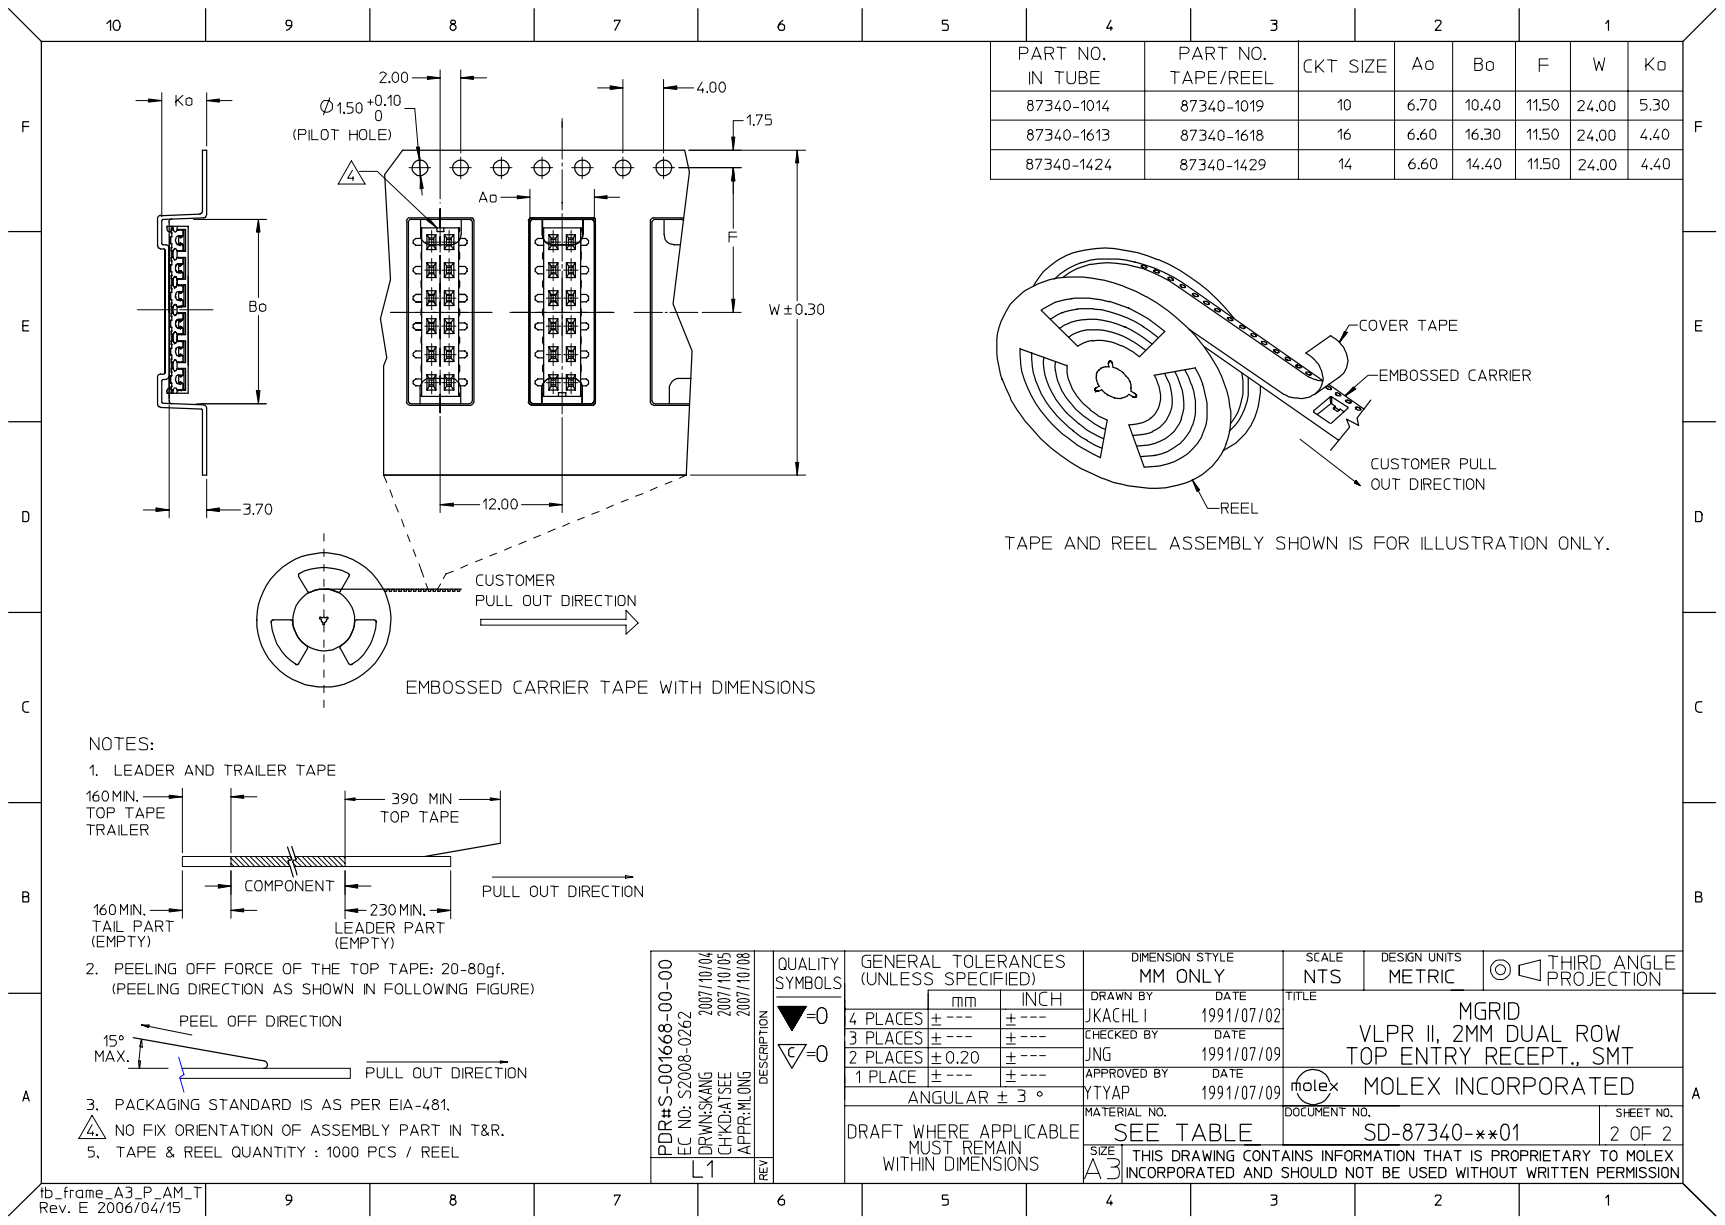
[picture p88: page 2]
