VictorZykov/molecubes/hardware/actuator/pcb/docs/NxPNxx2MAMx-RC-10495.pdf

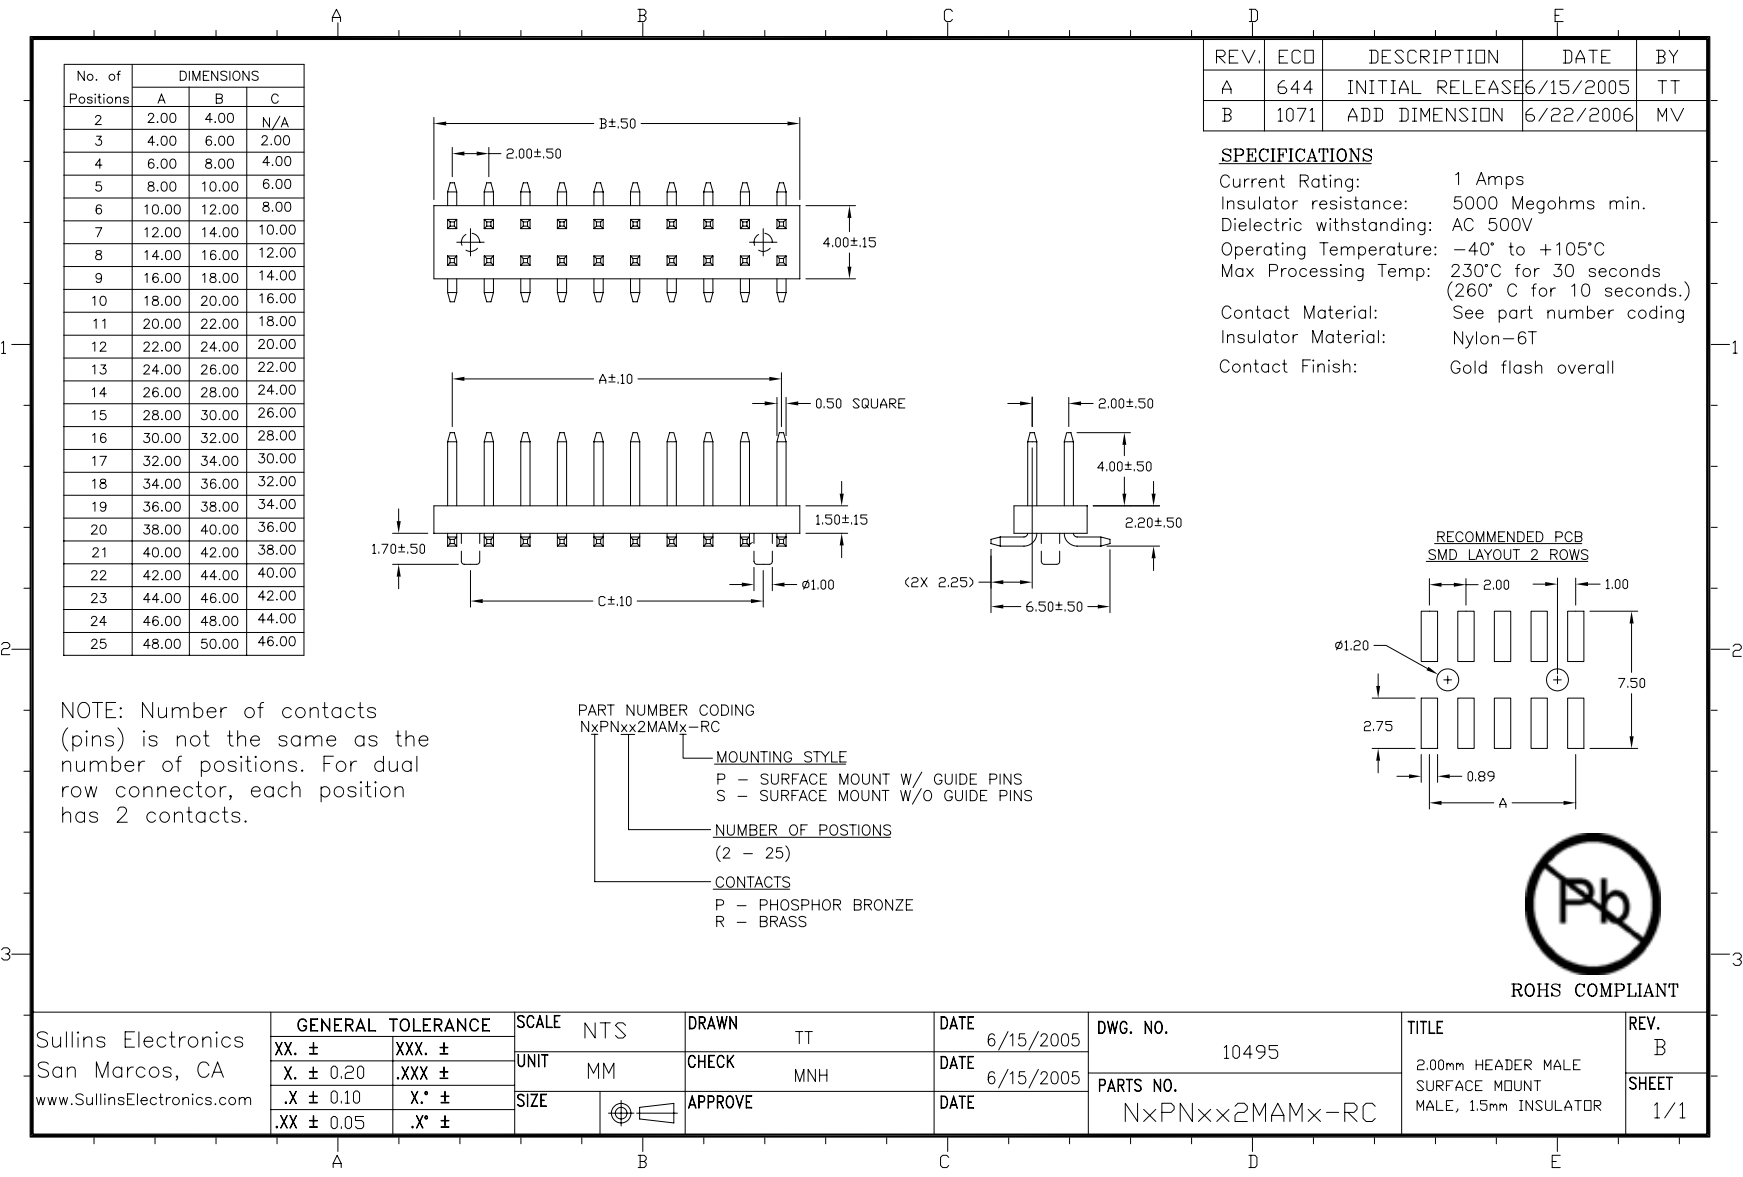
[picture p89: page 1]
