VictorZykov/molecubes/software/CubeInterface/CubeInterface/FullCubeData.cpp

//
// FullCubeData.cpp
//

#include "FullCubeData.h"

std::string *FullCubeData::outputData() {

	// This was used for a more advanced method of saving and loading that wasn't completed
	//std::cout<<"Accessed outputData\n";
	//std::string *tempString = new std::string();
	//tempString->clear();
	//for(int i = 0; i < 6; i++) {
	//	if(attachedCubes[i]!=NULL) {
	//		tempString->append("1");
	//	}
	//	else {
	//		tempString->append("0");
	//	}
	//}	
	//tempString->append("\n");
	//return tempString;
}
