VictorZykov/molecubes/software/CubeInterface/CubeInterface/include/SubEntityMaterialInstance.h

#ifndef __SUBENTITYMATERIALINSTANCE_H__
#define __SUBENTITYMATERIALINSTANCE_H__

#include "MaterialInstance.h"

using namespace Ogre;

/** Specialisation of the MaterialInstance class for SubEntities.
 * @author Kencho.
 * @see MaterialInstance.
 */
class SubEntityMaterialInstance : public MaterialInstance {
// Attributes =================================================================================
  public:
  protected:
    /** Reference to the affected SubEntity.
     */
    SubEntity *mSubEntity;
// Methods ====================================================================================
  public:
    /** Constructor. 
     * Initialises references and parameters.
     * @param se The SubEntity this SubEntityMaterialInstance works on.
     */
    SubEntityMaterialInstance (SubEntity *se);
    /** Destructor.
     * @note Destroys the copy material if needed.
     */
    ~SubEntityMaterialInstance ();
    /** Changes this SubEntity material and does any needed operations to keep the previous
     * material instance parameters (transparency and such).
     * @param name Name of the new material.
     * @note This also changes the references SubEntity material, so there is no need to call 
     *       SubEntity::setMaterialName() if this method is called. Indeed it's recommended to 
     *       change it through this instance rather than changing it manually.
     */
    void setMaterialName (String name);
    /** Changes this instance transparency. 
     * @param transparency The new transparency. Values will be clamped to [0..1].
     * @note This changes transparency. A value of 0 means full opacity, while 1 means full 
     *       transparency (invisible)
     * @note If transparency equals 0, it will use the original material instead of the copy 
     *       (the copy is mandatory transparent, and thus might be slower than the original).
     * @see MaterialInstance::setTransparency().
     */
    void setTransparency (Real transparency);
  protected:
    /** Initialises the reference to the original material from the SubEntity's.
     * @see MaterialInstance::initOriginalMaterial().
     */
    void initOriginalMaterial ();
};

#endif // __SUBENTITYMATERIALINSTANCE_H__
