VictorZykov/molecubes/(commit log)

2019-09-05 first commit to github
    [ARMCube.SLDASM, ARMCumeFDM.SLDASM, ARMHousing.SLDPRT, ARMHousingBack.SLDPRT, ATmega16PinsFuncs.xls, AX12_Top.SLDPRT, AX12_body.SLDPRT, Actuator.SLDASM]
2019-09-06 adding ARM-elf.zip
