VictorZykov/molecubes/(notices)

Notices in the files:
software/controller/interfaceTest/inc/debug.h:
modify it under the terms of the GNU General Public License
